ajisrawi/sentinel-uhf-radar/docs/images/backplane_layers.jpg

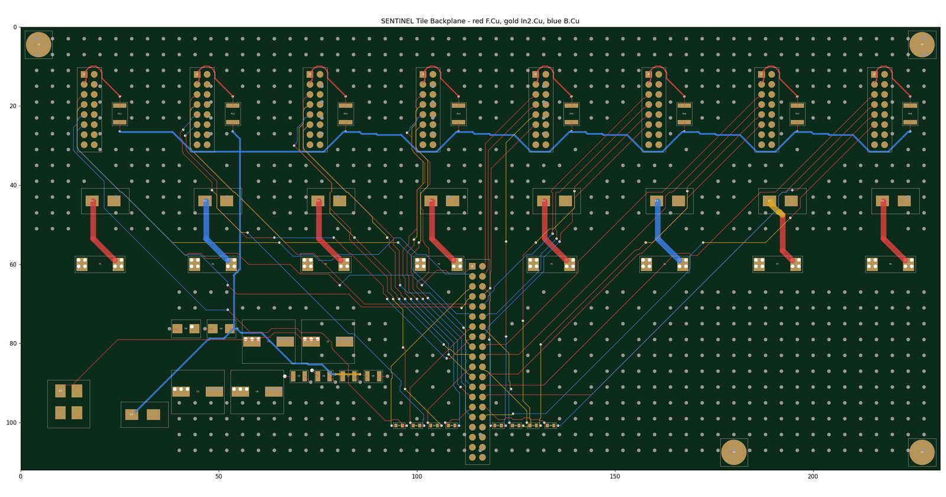
docs/images/backplane_layers.jpg
