ajisrawi/sentinel-uhf-radar/docs/images/cal_board_layers.jpg

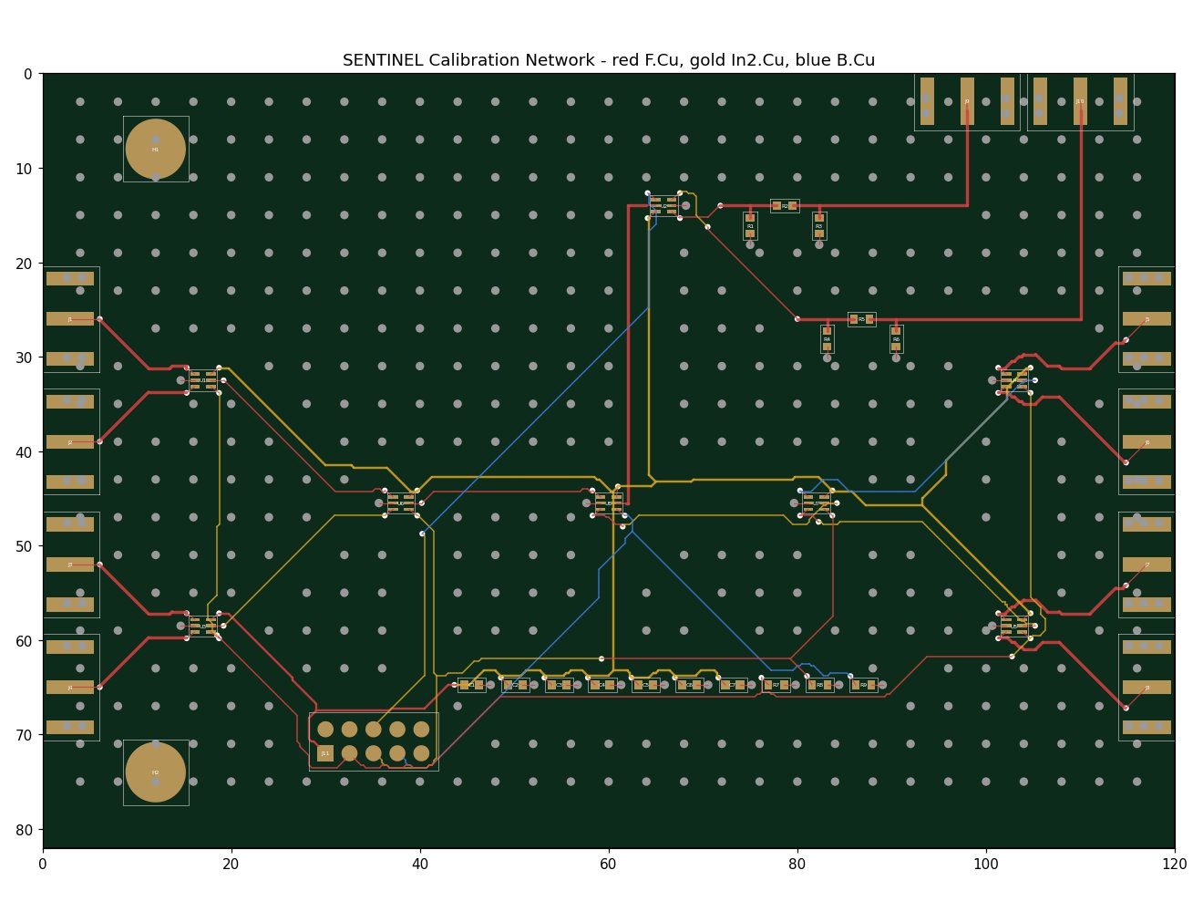
docs/images/cal_board_layers.jpg
