ajisrawi/sentinel-uhf-radar/docs/images/clock_board_layers.jpg

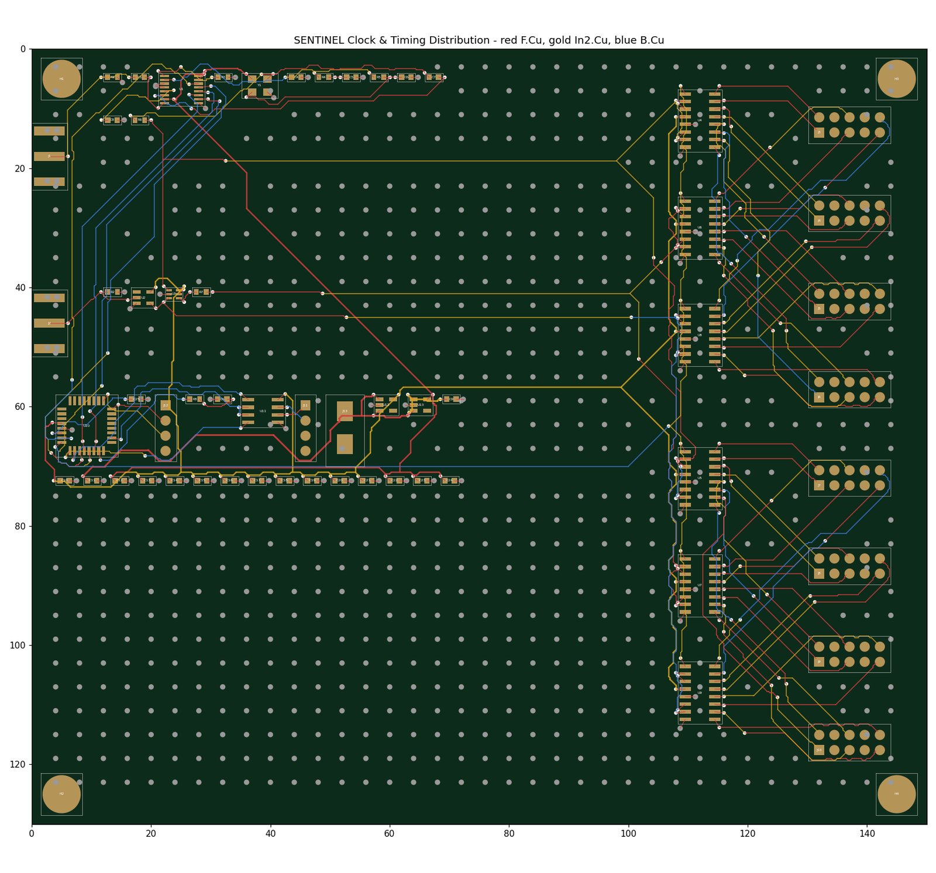
docs/images/clock_board_layers.jpg
