ajisrawi/sentinel-uhf-radar/docs/images/feed_board_layers.jpg

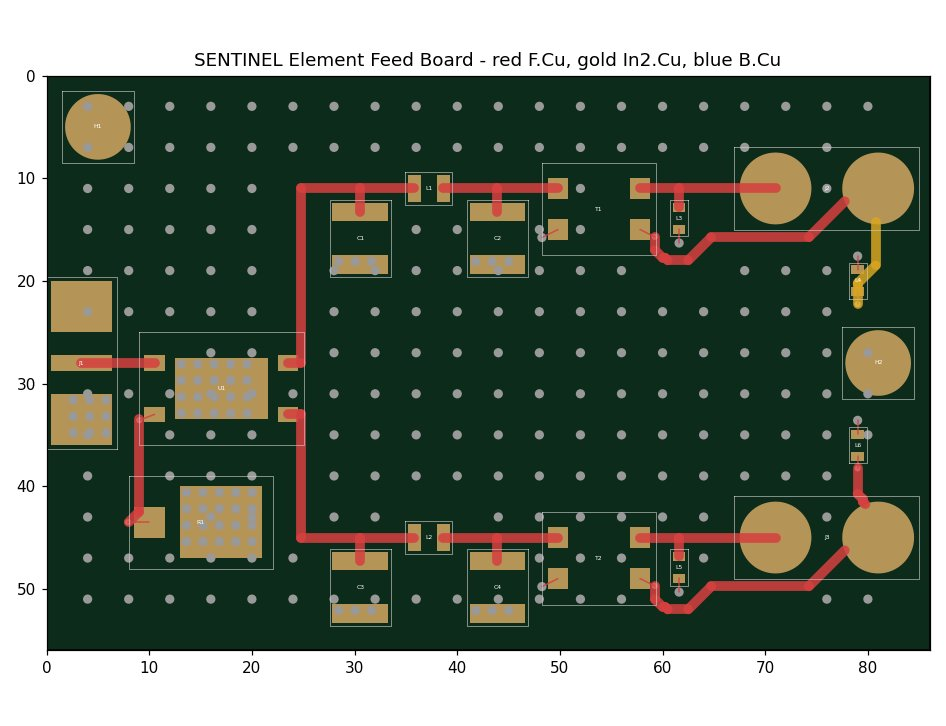
docs/images/feed_board_layers.jpg
