ajisrawi/sentinel-uhf-radar/docs/images/psu_layers.jpg

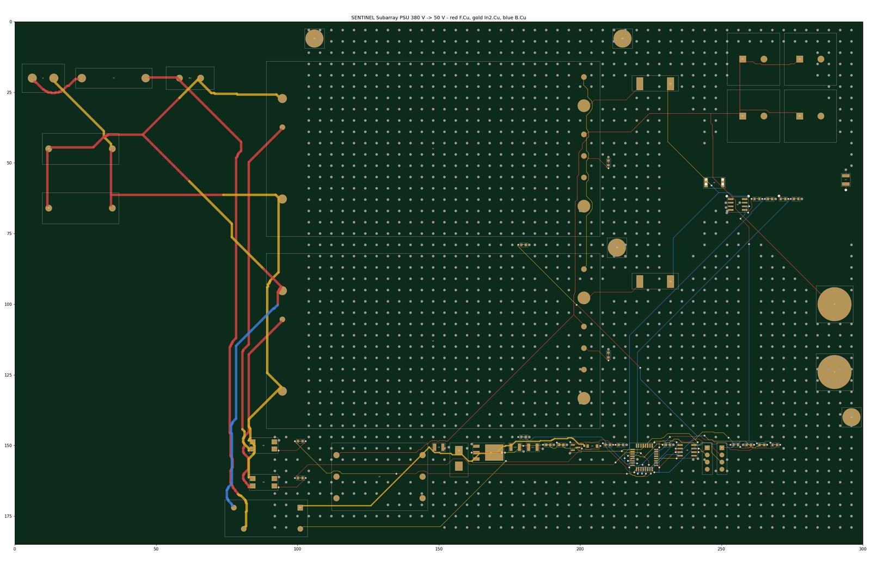
docs/images/psu_layers.jpg
