ajisrawi/sentinel-uhf-radar/docs/images/rfsoc_tile_layers.jpg

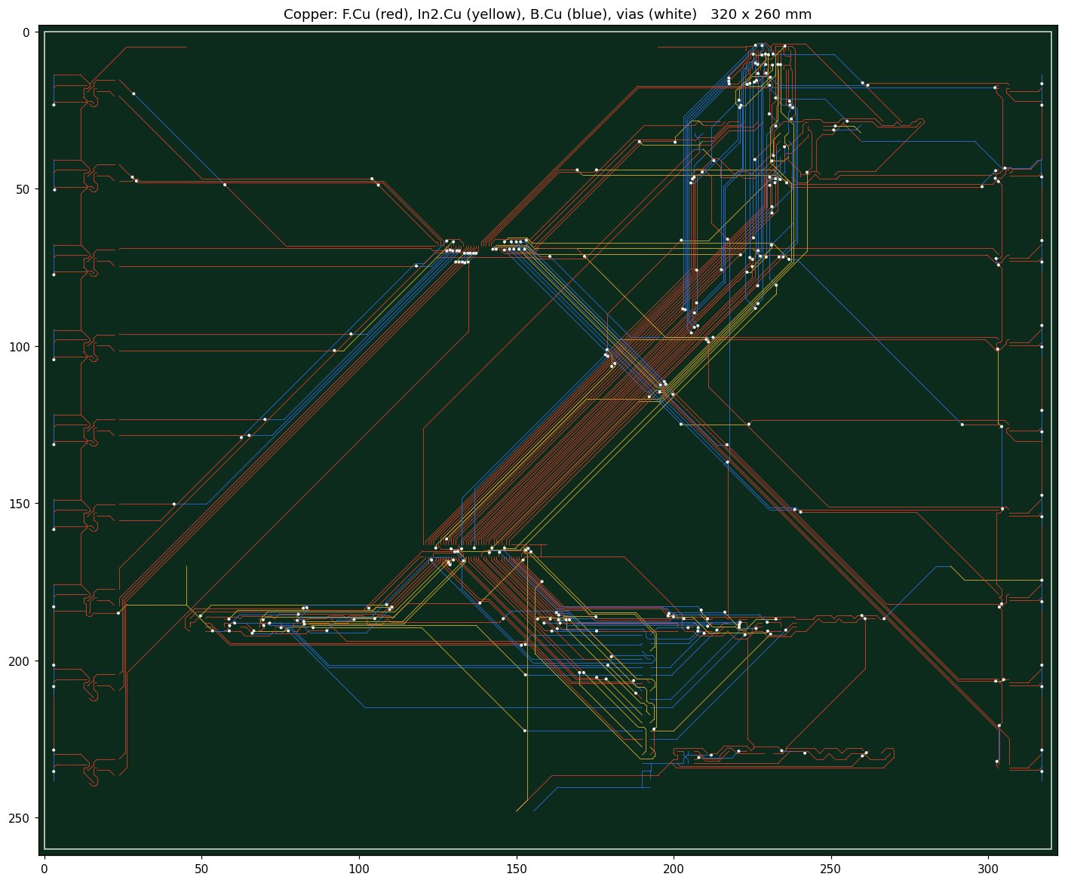
docs/images/rfsoc_tile_layers.jpg
