ajisrawi/sentinel-uhf-radar/report/img/sentinel_aerial.jpg

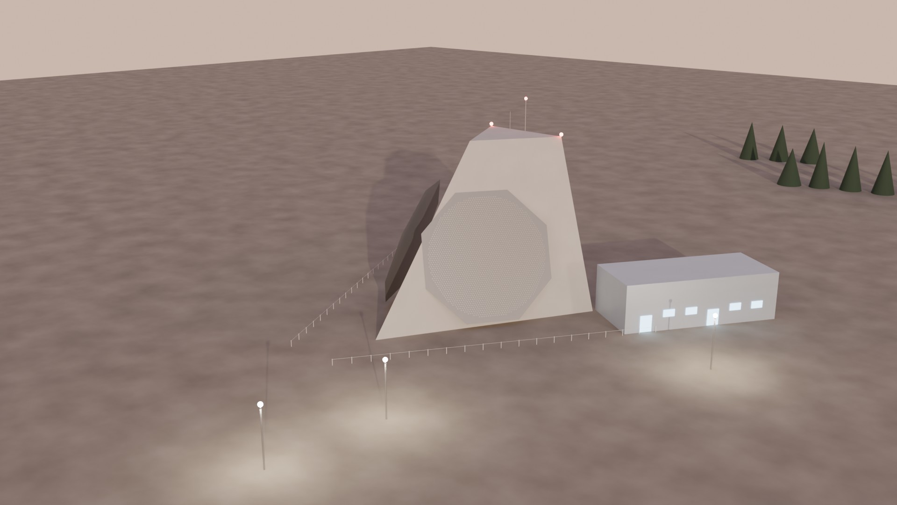
report/img/sentinel_aerial.jpg
