ajisrawi/sentinel-uhf-radar/hardware/backplane/export/SENTINEL_BACKPLANE_BOM.csv

Item | References | Qty | Value | Footprint | Description | MPN / part class
1 | C1-C4 | 4 | 330u 63V | Capacitor_SMD:CP_Elec_10x10.5 | Bus reservoir
2 | C5-C8 | 4 | 4.7u 100V | Capacitor_SMD:C_1210_3225Metric
3 | D1 | 1 | SMBJ58A | Diode_SMD:D_SMB
4 | D2 | 1 | SMBJ15A | Diode_SMD:D_SMB
5 | F1-F8 | 8 | 15A | SENTINEL:Fuse_456_SMD | 15 A fast fuse, per-slot drain protection
6 | F11-F18 | 8 | 0.5A | Fuse:Fuse_1812_4532Metric | Resettable fuse, module aux power
7 | H1-H4 | 4 | M4 | MountingHole:MountingHole_3.2mm_M3_Pad
8 | J1 | 1 | SLOT1 | Connector_PinHeader_2.54mm:PinHeader_2x08_P2.54mm_Vertical | T/R module 1 control header (mates module J5)
9 | J2 | 1 | SLOT2 | Connector_PinHeader_2.54mm:PinHeader_2x08_P2.54mm_Vertical | T/R module 2 control header (mates module J5)
10 | J3 | 1 | SLOT3 | Connector_PinHeader_2.54mm:PinHeader_2x08_P2.54mm_Vertical | T/R module 3 control header (mates module J5)
11 | J4 | 1 | SLOT4 | Connector_PinHeader_2.54mm:PinHeader_2x08_P2.54mm_Vertical | T/R module 4 control header (mates module J5)
12 | J5 | 1 | SLOT5 | Connector_PinHeader_2.54mm:PinHeader_2x08_P2.54mm_Vertical | T/R module 5 control header (mates module J5)
13 | J6 | 1 | SLOT6 | Connector_PinHeader_2.54mm:PinHeader_2x08_P2.54mm_Vertical | T/R module 6 control header (mates module J5)
14 | J7 | 1 | SLOT7 | Connector_PinHeader_2.54mm:PinHeader_2x08_P2.54mm_Vertical | T/R module 7 control header (mates module J5)
15 | J8 | 1 | SLOT8 | Connector_PinHeader_2.54mm:PinHeader_2x08_P2.54mm_Vertical | T/R module 8 control header (mates module J5)
16 | J9 | 1 | TO TILE | Connector_PinHeader_2.54mm:PinHeader_2x20_P2.54mm_Vertical | To RFSoC tile: 8 x (RS-485 A/B, TX_EN, FAULT_N)
17 | J10 | 1 | 50V IN | Connector_Molex:Molex_Mini-Fit_Jr_5566-04A_2x02_P4.20mm_Vertical | 50 V from subarray supply, 40 A pk
18 | J11 | 1 | DRAIN1 | Connector_Molex:Molex_Mini-Fit_Jr_5566-02A_2x01_P4.20mm_Vertical | Module 1 50 V drain feed
19 | J12 | 1 | DRAIN2 | Connector_Molex:Molex_Mini-Fit_Jr_5566-02A_2x01_P4.20mm_Vertical | Module 2 50 V drain feed
20 | J13 | 1 | DRAIN3 | Connector_Molex:Molex_Mini-Fit_Jr_5566-02A_2x01_P4.20mm_Vertical | Module 3 50 V drain feed
21 | J14 | 1 | DRAIN4 | Connector_Molex:Molex_Mini-Fit_Jr_5566-02A_2x01_P4.20mm_Vertical | Module 4 50 V drain feed
22 | J15 | 1 | DRAIN5 | Connector_Molex:Molex_Mini-Fit_Jr_5566-02A_2x01_P4.20mm_Vertical | Module 5 50 V drain feed
23 | J16 | 1 | DRAIN6 | Connector_Molex:Molex_Mini-Fit_Jr_5566-02A_2x01_P4.20mm_Vertical | Module 6 50 V drain feed
24 | J17 | 1 | DRAIN7 | Connector_Molex:Molex_Mini-Fit_Jr_5566-02A_2x01_P4.20mm_Vertical | Module 7 50 V drain feed
25 | J18 | 1 | DRAIN8 | Connector_Molex:Molex_Mini-Fit_Jr_5566-02A_2x01_P4.20mm_Vertical | Module 8 50 V drain feed
26 | J19 | 1 | 12V IN | Connector_Molex:Molex_Mini-Fit_Jr_5566-02A_2x01_P4.20mm_Vertical | 12 V aux from subarray supply
27 | R1-R8 | 8 | 33 | Resistor_SMD:R_0603_1608Metric | TX_EN source termination
