ajisrawi/sentinel-uhf-radar/hardware/cal_board/export/SENTINEL_CAL_BOM.csv

Item | References | Qty | Value | Footprint | Description | MPN / part class
1 | C1 | 1 | 1u | Capacitor_SMD:C_0603_1608Metric
2 | C2-C7 | 6 | 100n | Capacitor_SMD:C_0603_1608Metric
3 | H1,H2 | 2 | M3 | MountingHole:MountingHole_3.2mm_M3_Pad
4 | J1 | 1 | CAL1 | Connector_Coaxial:SMA_Amphenol_132289_EdgeMount | From T/R module 1 CAL port
5 | J2 | 1 | CAL2 | Connector_Coaxial:SMA_Amphenol_132289_EdgeMount | From T/R module 2 CAL port
6 | J3 | 1 | CAL3 | Connector_Coaxial:SMA_Amphenol_132289_EdgeMount | From T/R module 3 CAL port
7 | J4 | 1 | CAL4 | Connector_Coaxial:SMA_Amphenol_132289_EdgeMount | From T/R module 4 CAL port
8 | J5 | 1 | CAL5 | Connector_Coaxial:SMA_Amphenol_132289_EdgeMount | From T/R module 5 CAL port
9 | J6 | 1 | CAL6 | Connector_Coaxial:SMA_Amphenol_132289_EdgeMount | From T/R module 6 CAL port
10 | J7 | 1 | CAL7 | Connector_Coaxial:SMA_Amphenol_132289_EdgeMount | From T/R module 7 CAL port
11 | J8 | 1 | CAL8 | Connector_Coaxial:SMA_Amphenol_132289_EdgeMount | From T/R module 8 CAL port
12 | J9 | 1 | INJECT | Connector_Coaxial:SMA_Amphenol_132289_EdgeMount | From tile calibration DAC
13 | J10 | 1 | MEASURE | Connector_Coaxial:SMA_Amphenol_132289_EdgeMount | To tile calibration ADC
14 | J11 | 1 | CTRL | Connector_PinHeader_2.54mm:PinHeader_2x05_P2.54mm_Vertical | Control from RFSoC tile
15 | R1,R3,R4,R6 | 4 | 150 | Resistor_SMD:R_0603_1608Metric
16 | R2,R5 | 2 | 37.4 | Resistor_SMD:R_0603_1608Metric | 6 dB pad
17 | R7-R9 | 3 | 100k | Resistor_SMD:R_0603_1608Metric | Default channel 1
18 | U1-U8 | 8 | SPDT | Package_TO_SOT_SMD:SOT-363_SC-70-6 | Inject (RF1) / measure (RF2),Selector tree, SEL0 picks RF1/RF2,Selector tree, SEL1 picks RF1/RF2,Selector tree, SEL2 picks RF1/RF2
