ajisrawi/sentinel-uhf-radar/hardware/clock_board/export/SENTINEL_CLOCK_BOM.csv

Item | References | Qty | Value | Footprint | Description | MPN / part class
1 | C1,C13-C25 | 14 | 100n | Capacitor_SMD:C_0603_1608Metric
2 | C4 | 1 | 2.2n | Capacitor_SMD:C_0603_1608Metric | Loop filter (100 Hz loop)
3 | C5 | 1 | 22n | Capacitor_SMD:C_0603_1608Metric | Loop filter (100 Hz loop)
4 | C6 | 1 | 1n | Capacitor_SMD:C_0603_1608Metric | Loop filter (100 Hz loop)
5 | C7,C8 | 2 | 100p | Capacitor_SMD:C_0603_1608Metric
6 | C9-C12 | 4 | 1u | Capacitor_SMD:C_0603_1608Metric
7 | D1 | 1 | LOCK | LED_SMD:LED_0603_1608Metric
8 | H1-H4 | 4 | M3 | MountingHole:MountingHole_3.2mm_M3_Pad
9 | J1 | 1 | 10MHz IN | Connector_Coaxial:SMA_Amphenol_132289_EdgeMount | 10 MHz from site master, +7 dBm sine
10 | J2 | 1 | PPS IN | Connector_Coaxial:SMA_Amphenol_132289_EdgeMount | 1 PPS from site master
11 | J3 | 1 | TILE1 | Connector_PinHeader_2.54mm:PinHeader_2x05_P2.54mm_Vertical | Clock bundle to tile 1
12 | J4 | 1 | TILE2 | Connector_PinHeader_2.54mm:PinHeader_2x05_P2.54mm_Vertical | Clock bundle to tile 2
13 | J5 | 1 | TILE3 | Connector_PinHeader_2.54mm:PinHeader_2x05_P2.54mm_Vertical | Clock bundle to tile 3
14 | J6 | 1 | TILE4 | Connector_PinHeader_2.54mm:PinHeader_2x05_P2.54mm_Vertical | Clock bundle to tile 4
15 | J7 | 1 | TILE5 | Connector_PinHeader_2.54mm:PinHeader_2x05_P2.54mm_Vertical | Clock bundle to tile 5
16 | J8 | 1 | TILE6 | Connector_PinHeader_2.54mm:PinHeader_2x05_P2.54mm_Vertical | Clock bundle to tile 6
17 | J9 | 1 | TILE7 | Connector_PinHeader_2.54mm:PinHeader_2x05_P2.54mm_Vertical | Clock bundle to tile 7
18 | J10 | 1 | TILE8 | Connector_PinHeader_2.54mm:PinHeader_2x05_P2.54mm_Vertical | Clock bundle to tile 8
19 | J11 | 1 | RS485 | Connector_PinHeader_2.54mm:PinHeader_1x04_P2.54mm_Vertical | To site timing controller
20 | J12 | 1 | SWD | Connector_PinHeader_2.54mm:PinHeader_1x04_P2.54mm_Vertical
21 | J13 | 1 | 5V IN | Connector_Molex:Molex_Mini-Fit_Jr_5566-02A_2x01_P4.20mm_Vertical
22 | R1,R2 | 2 | 51 | Resistor_SMD:R_0603_1608Metric | 50 ohm termination
23 | R3 | 1 | 5.1k | Resistor_SMD:R_0603_1608Metric
24 | R4 | 1 | 3.3k | Resistor_SMD:R_0603_1608Metric | Loop filter (100 Hz loop)
25 | R5 | 1 | 6.8k | Resistor_SMD:R_0603_1608Metric | Loop filter (100 Hz loop)
26 | R6,R7 | 2 | 33 | Resistor_SMD:R_0603_1608Metric | Source termination
27 | R8 | 1 | 1k | Resistor_SMD:R_0603_1608Metric
28 | U1 | 1 | PLL | Package_SO:TSSOP-16_4.4x5mm_P0.65mm | Integer-N PLL, verify pin map
29 | U2 | 1 | 74LVC1G17 | Package_TO_SOT_SMD:SOT-23-5 | PPS Schmitt buffer
30 | U3 | 1 | 74LVC1G175 | Package_TO_SOT_SMD:SOT-363_SC-70-6 | SYSREF: PPS re-timed by CLK
31 | U4-U9 | 6 | SN65LVDS047 | Package_SO:SOIC-16_3.9x9.9mm_P1.27mm | Quad LVDS driver, CLK to tiles 1-4,Quad LVDS driver, CLK to tiles 5-8,Quad LVDS driver, PPS to tiles 1-4,Quad LVDS driver, PPS to tiles 5-8,Quad LVDS driver, SYSREF to tiles 1-4,Quad LVDS driver, SYSREF to tiles 5-8
32 | U10 | 1 | STM32G031K8T6 | Package_QFP:LQFP-32_7x7mm_P0.8mm | Programs the PLL, reports lock, enables outputs
33 | U11 | 1 | THVD1450 | Package_SO:SOIC-8_3.9x4.9mm_P1.27mm
34 | U12,U13 | 2 | AP2112K-3.3 | Package_TO_SOT_SMD:SOT-23-5 | Analog rail for PLL/VCXO
35 | Y1 | 1 | 122.88MHz | Oscillator:Oscillator_SMD_EuroQuartz_XO53-4Pin_5.0x3.2mm | 122.88 MHz VCXO, low phase noise
