ajisrawi/sentinel-uhf-radar/hardware/feed_board/export/SENTINEL_FEED_BOM.csv

Item | References | Qty | Value | Footprint | Description | MPN / part class
1 | C1 | 1 | DNP | Capacitor_SMD:C_2220_5750Metric | X match shunt, 500 V
2 | C2,C4 | 2 | tune | Capacitor_SMD:C_2220_5750Metric | Bench trim, fit if needed | DNP
3 | C3 | 1 | 3.9p | Capacitor_SMD:C_2220_5750Metric | Y match shunt, 500 V
4 | H1,H2 | 2 | M3 | MountingHole:MountingHole_3.2mm_M3_Pad
5 | J1 | 1 | FROM T/R | SENTINEL:N_EdgeLaunch | N-type from T/R module ANT port, 300 W pk
6 | J2 | 1 | DIPOLE X | SENTINEL:DipoleArm_M4_Pair | X dipole arms, M4 lugs
7 | J3 | 1 | DIPOLE Y | SENTINEL:DipoleArm_M4_Pair | Y dipole arms, M4 lugs
8 | L1 | 1 | 11.2n | Inductor_SMD:L_1210_3225Metric | X match series
9 | L2 | 1 | 20.7n | Inductor_SMD:L_1210_3225Metric | Y match series
10 | L3-L6 | 4 | 1u | Inductor_SMD:L_0805_2012Metric | Static bleed
11 | R1 | 1 | 50 100W | SENTINEL:Termination_100W_SMD | Isolated-port load, 100 W
12 | T1,T2 | 2 | 1:1 | SENTINEL:Balun_SMD_10x8 | 1:1 balun, 200 W pk
13 | U1 | 1 | HYB 3dB | SENTINEL:Hybrid90_SMD_15x10 | 3 dB 90 deg hybrid, 420-450 MHz, 500 W
