ajisrawi/sentinel-uhf-radar/hardware/psu/export/SENTINEL_PSU_BOM.csv

Item | References | Qty | Value | Footprint | Description | MPN / part class
1 | C1,C2 | 2 | 10u 450V | Capacitor_THT:C_Rect_L26.5mm_W10.5mm_P22.50mm_MKS4 | Input film capacitor
2 | C3-C6 | 4 | 1000u 63V | Capacitor_THT:CP_Radial_D18.0mm_P7.50mm | Output bulk
3 | C7 | 1 | 10u 100V | Capacitor_SMD:C_1210_3225Metric
4 | C8 | 1 | 10n | Capacitor_SMD:C_0603_1608Metric
5 | C9 | 1 | 22u 25V | Capacitor_SMD:C_1210_3225Metric
6 | C10,C11 | 2 | 10u | Capacitor_SMD:C_1210_3225Metric
7 | C12-C14 | 3 | 100n | Capacitor_SMD:C_0603_1608Metric
8 | D1,D2 | 2 | 100V 60A | Package_TO_SOT_THT:TO-247-2_Vertical | Output OR-ing diode
9 | D3 | 1 | 1N4148W | Diode_SMD:D_SOD-123 | Relay flyback
10 | D4 | 1 | GRN | LED_SMD:LED_0603_1608Metric
11 | F1 | 1 | 6.3A 500V | SENTINEL:Fuse_Clips_5x20 | Input fuse, 500 VDC rated
12 | H1-H4 | 4 | M4 | MountingHole:MountingHole_3.2mm_M3_Pad
13 | J1 | 1 | 380VDC IN | SENTINEL:Terminal_HV_2P_7.62 | 380 VDC site distribution bus
14 | J2 | 1 | +50V STUD | SENTINEL:Stud_M6 | M6 stud: capacitor bank + and backplane 50 V
15 | J3 | 1 | 0V STUD | SENTINEL:Stud_M6 | M6 stud: return
16 | J4 | 1 | 12V OUT | Connector_Molex:Molex_Mini-Fit_Jr_5566-02A_2x01_P4.20mm_Vertical | 12 V aux to backplane
17 | J5 | 1 | RS485 | Connector_PinHeader_2.54mm:PinHeader_1x04_P2.54mm_Vertical | Telemetry to tile controller
18 | J6 | 1 | SWD | Connector_PinHeader_2.54mm:PinHeader_1x04_P2.54mm_Vertical
19 | K1 | 1 | G2RL-1A 12V | Relay_THT:Relay_SPST_Omron_G2RL-1A | Inrush bypass relay, 5 kV coil-contact
20 | Q1 | 1 | 2N7002 | Package_TO_SOT_SMD:SOT-23
21 | R1,R2 | 2 | 470 | Resistor_SMD:R_0603_1608Metric
22 | R3,R4 | 2 | trim | Resistor_SMD:R_0603_1608Metric | Trim-up to 50.0 V per vendor formula | value per brick datasheet
23 | R5,R6,R10 | 3 | 10k | Resistor_SMD:R_0603_1608Metric
24 | R7 | 1 | 1m | Resistor_SMD:R_2512_6332Metric | Brick current shunt
25 | R8,R13 | 2 | 1k | Resistor_SMD:R_0603_1608Metric
26 | R9 | 1 | 200k | Resistor_SMD:R_0603_1608Metric
27 | R11 | 1 | 100 | Resistor_SMD:R_0603_1608Metric
28 | R12 | 1 | 100k | Resistor_SMD:R_0603_1608Metric
29 | RT1 | 1 | 10R NTC | SENTINEL:NTC_Disc_D15_P7.5 | Inrush limiter, bypassed by K1 after precharge
30 | TH1,TH2 | 2 | 10k NTC | Resistor_SMD:R_0603_1608Metric | Brick 1 baseplate temperature,Brick 2 baseplate temperature
31 | U1,U2 | 2 | 380V->50V 600W | SENTINEL:Brick_Full_THT | Isolated full brick, 380 V in, 50 V / 12 A out, current share
32 | U3,U4 | 2 | PC817 | Package_DIP:SMDIP-4_W7.62mm | Brick enable across the isolation barrier
33 | U5 | 1 | 48V->12V 50W | SENTINEL:Brick_16_THT | 12 V aux for modules and relay
34 | U6 | 1 | LM1117-3.3 | Package_TO_SOT_SMD:TO-252-3_TabPin2
35 | U7 | 1 | STM32G031K8T6 | Package_QFP:LQFP-32_7x7mm_P0.8mm | Supervisor: soft start, OV/UV, current, temperature, telemetry
36 | U8 | 1 | THVD1450 | Package_SO:SOIC-8_3.9x4.9mm_P1.27mm
37 | U9 | 1 | INA240A1 | Package_SO:SOIC-8_3.9x4.9mm_P1.27mm
