ajisrawi/sentinel-uhf-radar/hardware/rfsoc_tile/export/SENTINEL_TILE_BOM.csv

Item | References | Qty | Value | Footprint | Description | MPN / part class
1 | C1-C9,C11,C12,C21,C100-C108,C120-C128,C140-C148,C161 | 40 | 100n | Capacitor_SMD:C_0603_1608Metric | Centre-tap AC ground
2 | C10,C160 | 2 | 10u | Capacitor_SMD:C_1210_3225Metric | QSFP supply filter
3 | C20 | 1 | 10u 25V | Capacitor_SMD:C_1210_3225Metric
4 | C22 | 1 | 1u | Capacitor_SMD:C_0603_1608Metric
5 | C23,C24 | 2 | 22u | Capacitor_SMD:C_1210_3225Metric
6 | C25 | 1 | 22u 25V | Capacitor_SMD:C_1210_3225Metric
7 | H1-H4 | 4 | M3 | MountingHole:MountingHole_3.2mm_M3_Pad
8 | J1 | 1 | SOM CONN A | SENTINEL:SOM_B2B_2x40_P0.8 | SOM data-converter connector
9 | J2 | 1 | SOM CONN B | SENTINEL:SOM_B2B_2x50_P0.8 | SOM control / optics / power connector
10 | J3 | 1 | BACKPLANE | Connector_PinHeader_2.54mm:PinHeader_2x20_P2.54mm_Vertical | Cable to tile backplane J9 (pin-for-pin)
11 | J4 | 1 | CLOCK | Connector_PinHeader_2.54mm:PinHeader_2x05_P2.54mm_Vertical | From clock board
12 | J5 | 1 | CAL CTRL | Connector_PinHeader_2.54mm:PinHeader_2x05_P2.54mm_Vertical | To calibration board J11
13 | J6 | 1 | PSU LINK | Connector_PinHeader_2.54mm:PinHeader_1x04_P2.54mm_Vertical
14 | J7 | 1 | QSFP28 | SENTINEL:QSFP28_Host_38P | QSFP28 to face beamformer, 4 x 25 Gb/s
15 | J8 | 1 | 12V IN | Connector_Molex:Molex_Mini-Fit_Jr_5566-02A_2x01_P4.20mm_Vertical | 12 V from subarray PSU aux, 4 A
16 | J10 | 1 | RX1 | Connector_Coaxial:SMA_Amphenol_132289_EdgeMount | From T/R module 1 RX_OUT
17 | J11 | 1 | RX2 | Connector_Coaxial:SMA_Amphenol_132289_EdgeMount | From T/R module 2 RX_OUT
18 | J12 | 1 | RX3 | Connector_Coaxial:SMA_Amphenol_132289_EdgeMount | From T/R module 3 RX_OUT
19 | J13 | 1 | RX4 | Connector_Coaxial:SMA_Amphenol_132289_EdgeMount | From T/R module 4 RX_OUT
20 | J14 | 1 | RX5 | Connector_Coaxial:SMA_Amphenol_132289_EdgeMount | From T/R module 5 RX_OUT
21 | J15 | 1 | RX6 | Connector_Coaxial:SMA_Amphenol_132289_EdgeMount | From T/R module 6 RX_OUT
22 | J16 | 1 | RX7 | Connector_Coaxial:SMA_Amphenol_132289_EdgeMount | From T/R module 7 RX_OUT
23 | J17 | 1 | RX8 | Connector_Coaxial:SMA_Amphenol_132289_EdgeMount | From T/R module 8 RX_OUT
24 | J18 | 1 | RXCAL | Connector_Coaxial:SMA_Amphenol_132289_EdgeMount | From calibration board MEASURE
25 | J20 | 1 | TX1 | Connector_Coaxial:SMA_Amphenol_132289_EdgeMount | To T/R module 1 TX_IN
26 | J21 | 1 | TX2 | Connector_Coaxial:SMA_Amphenol_132289_EdgeMount | To T/R module 2 TX_IN
27 | J22 | 1 | TX3 | Connector_Coaxial:SMA_Amphenol_132289_EdgeMount | To T/R module 3 TX_IN
28 | J23 | 1 | TX4 | Connector_Coaxial:SMA_Amphenol_132289_EdgeMount | To T/R module 4 TX_IN
29 | J24 | 1 | TX5 | Connector_Coaxial:SMA_Amphenol_132289_EdgeMount | To T/R module 5 TX_IN
30 | J25 | 1 | TX6 | Connector_Coaxial:SMA_Amphenol_132289_EdgeMount | To T/R module 6 TX_IN
31 | J26 | 1 | TX7 | Connector_Coaxial:SMA_Amphenol_132289_EdgeMount | To T/R module 7 TX_IN
32 | J27 | 1 | TX8 | Connector_Coaxial:SMA_Amphenol_132289_EdgeMount | To T/R module 8 TX_IN
33 | J28 | 1 | TXCAL | Connector_Coaxial:SMA_Amphenol_132289_EdgeMount | To calibration board INJECT
34 | L1 | 1 | 4.7u | Inductor_SMD:L_1210_3225Metric
35 | R10-R12,R24 | 4 | 100 | Resistor_SMD:R_0603_1608Metric | LVDS receiver termination,LVDS termination (DNP if SOM terminates),MGT reference clock termination (refclk from SOM oscillator)
36 | R20-R23 | 4 | 4.7k | Resistor_SMD:R_0603_1608Metric
37 | R25,R27 | 2 | 100k | Resistor_SMD:R_0603_1608Metric
38 | R26 | 1 | 43.2k | Resistor_SMD:R_0603_1608Metric
39 | R160 | 1 | 0 | Resistor_SMD:R_0805_2012Metric | DAC_AVTT from 3.3 V (fit per SOM DAC mode: 2.5 V or 3.0 V)
40 | T1-T9,T11-T19 | 18 | 1:2 | SENTINEL:Balun_SMD_6P_3.8x3.8 | ADC input transformer, 50 -> 100 ohm,DAC output transformer, centre tap biases the DAC
41 | U1-U9 | 9 | THVD1450 | Package_SO:SOIC-8_3.9x4.9mm_P1.27mm | RS-485 to T/R module 1,RS-485 to T/R module 2,RS-485 to T/R module 3,RS-485 to T/R module 4,RS-485 to T/R module 5,RS-485 to T/R module 6,RS-485 to T/R module 7,RS-485 to T/R module 8,RS-485 to subarray PSU
42 | U10 | 1 | LMR33630 | Package_SO:Texas_HSOP-8-1EP_3.9x4.9mm_P1.27mm_ThermalVias | 12 V -> 3.3 V, 3 A
