ajisrawi/sentinel-uhf-radar/hardware/tr_module/export/SENTINEL_TRM_BOM.csv

Item | References | Qty | Value | Footprint | Description | MPN / part class
1 | C1,C3,C23-C29 | 9 | 100p | Capacitor_SMD:C_0603_1608Metric | DC block, C0G
2 | C5 | 1 | 33p | Capacitor_SMD:C_0603_1608Metric | Driver input DC block
3 | C6 | 1 | 8.2p | Capacitor_SMD:C_0603_1608Metric | Driver input match
4 | C8 | 1 | 1.5p | Capacitor_SMD:C_0805_2012Metric | Driver output match
5 | C9 | 1 | 47p | Capacitor_SMD:C_0805_2012Metric | Interstage DC block
6 | C10 | 1 | 10p | Capacitor_SMD:C_0805_2012Metric | Interstage match
7 | C11 | 1 | 22p | Capacitor_SMD:C_1206_3216Metric | PA input match
8 | C13 | 1 | 1n 100V | Capacitor_SMD:C_1210_3225Metric
9 | C14 | 1 | 10u 100V | Capacitor_SMD:C_2220_5750Metric
10 | C15,C16 | 2 | 330u 63V | Capacitor_SMD:CP_Elec_10x10.5 | Polymer, pulse reservoir
11 | C17 | 1 | 100p | Capacitor_SMD:C_2220_5750Metric | Output DC block, 500 V, high-Q
12 | C18 | 1 | 6.8p | Capacitor_SMD:C_2220_5750Metric | Output match, 500 V
13 | C19 | 1 | 3.3p | Capacitor_SMD:C_2220_5750Metric | Output match, 500 V
14 | C20,C21,C30,C31,C35,C36,C40,C41,C44,C47,C49,C50 | 12 | 100n | Capacitor_SMD:C_0603_1608Metric
15 | C22,C32,C33,C45,C46 | 5 | 1u | Capacitor_SMD:C_0603_1608Metric
16 | C34 | 1 | 4.7u | Capacitor_SMD:C_0805_2012Metric
17 | C37 | 1 | 10n | Capacitor_SMD:C_0603_1608Metric
18 | C38 | 1 | 100u 100V | Capacitor_SMD:CP_Elec_10x10.5 | Bus bulk
19 | C39 | 1 | 1u 100V | Capacitor_SMD:C_1210_3225Metric
20 | C42 | 1 | 22u | Capacitor_SMD:C_1210_3225Metric
21 | C43 | 1 | 10u 50V | Capacitor_SMD:C_1210_3225Metric
22 | C48 | 1 | 4.7u | Capacitor_SMD:C_0603_1608Metric
23 | D1 | 1 | PIN | Diode_SMD:D_SMB | Coarse PIN limiter diode, 100 W pk
24 | D2 | 1 | Schottky | Diode_SMD:D_SOD-323 | Fine limiter
25 | D3 | 1 | 12V | Diode_SMD:D_SOD-323 | P-FET Vgs clamp
26 | D4 | 1 | SMBJ58A | Diode_SMD:D_SMB | Bus transient clamp
27 | D5 | 1 | SS16 | Diode_SMD:D_SMA
28 | D6 | 1 | GRN | LED_SMD:LED_0603_1608Metric | Status LED
29 | H1-H4 | 4 | M3 | MountingHole:MountingHole_3.2mm_M3_Pad | Cold-plate bond, M3
30 | J1 | 1 | TX_IN | Connector_Coaxial:SMA_Amphenol_132289_EdgeMount | SMA edge launch, RF drive from RFSoC DAC (0 dBm)
31 | J2 | 1 | RX_OUT | Connector_Coaxial:SMA_Amphenol_132289_EdgeMount | SMA edge launch to RFSoC ADC
32 | J3 | 1 | ANT | SENTINEL:N_EdgeLaunch | N-type edge launch to crossed-dipole hybrid
33 | J4 | 1 | CAL | Connector_Coaxial:SMA_Amphenol_132289_EdgeMount | SMA to array calibration network (mutual-coupling cal)
34 | J5 | 1 | BACKPLANE | Connector_PinHeader_2.54mm:PinHeader_2x08_P2.54mm_Vertical | Tile backplane: aux power, RS-485, TX_EN gate, fault; even pins ground
35 | J6 | 1 | 50V IN | Connector_Molex:Molex_Mini-Fit_Jr_5566-02A_2x01_P4.20mm_Vertical | Mini-Fit Jr, 50 V drain bus from subarray supply
36 | J7 | 1 | SWD | Connector_PinHeader_2.54mm:PinHeader_1x04_P2.54mm_Vertical
37 | L1,L9,L10 | 3 | 390n | Inductor_SMD:L_0603_1608Metric | RF choke
38 | L2 | 1 | 220n | Inductor_SMD:L_0805_2012Metric | Gate feed
39 | L3 | 1 | 120n | Inductor_SMD:L_1210_3225Metric | Driver drain feed
40 | L4 | 1 | 18n | Inductor_SMD:L_0805_2012Metric | Interstage match
41 | L5 | 1 | 56n | Inductor_SMD:L_1210_3225Metric | PA gate feed
42 | L6 | 1 | 47n | Inductor_SMD:L_1812_4532Metric | PA drain feed, 10 A peak
43 | L7 | 1 | 8n | Inductor_SMD:L_1812_4532Metric | Output match, air core
44 | L8 | 1 | 100n | Inductor_SMD:L_0603_1608Metric | Limiter DC return
45 | L11 | 1 | 22u | Inductor_SMD:L_1210_3225Metric
46 | Q1 | 1 | GaN 10W | SENTINEL:GaN_Flange_440166 | Driver GaN HEMT 10 W, 50 V, 440166 flange | CG2H40010F class
47 | Q2 | 1 | GaN 300W | SENTINEL:GaN_Flange_780 | Final GaN HEMT 300 W pulsed, 50 V, NI-780 flange | UHF radar GaN, 300 W class
48 | Q3 | 1 | 2N7002 | Package_TO_SOT_SMD:SOT-23 | Level shifter
49 | Q4 | 1 | SUD50P10 | Package_TO_SOT_SMD:TO-252-2 | High-side drain switch, 100 V P-FET
50 | R1,R10 | 2 | 33 | Resistor_SMD:R_0603_1608Metric
51 | R3,R5 | 2 | 292 | Resistor_SMD:R_0603_1608Metric | 3 dB pi pad
52 | R4 | 1 | 17.6 | Resistor_SMD:R_0603_1608Metric | 3 dB pi pad
53 | R6 | 1 | 22 | Resistor_SMD:R_0603_1608Metric
54 | R7 | 1 | 4.7 | Resistor_SMD:R_0603_1608Metric | Gate stability resistor
55 | R8 | 1 | 10 | Resistor_SMD:R_0805_2012Metric
56 | R9 | 1 | 47 | Resistor_SMD:R_0603_1608Metric
57 | R12,R14,R15,R17 | 4 | 96 | Resistor_SMD:R_0603_1608Metric
58 | R13,R16 | 2 | 71 | Resistor_SMD:R_0603_1608Metric | 10 dB pi pad
59 | R18,R21,R26,R33,R40,R41,R44,R46 | 8 | 10k | Resistor_SMD:R_0603_1608Metric | TX_EN defaults low
60 | R19,R22 | 2 | 12.4k | Resistor_SMD:R_0603_1608Metric
61 | R20,R23 | 2 | 10 | Resistor_SMD:R_0603_1608Metric
62 | R24,R25,R27,R28,R31,R32,R48 | 7 | 100k | Resistor_SMD:R_0603_1608Metric | Fail-safe pinch-off
63 | R29 | 1 | 82k | Resistor_SMD:R_0603_1608Metric
64 | R30 | 1 | 20k | Resistor_SMD:R_0603_1608Metric
65 | R34 | 1 | 100 | Resistor_SMD:R_0603_1608Metric
66 | R35 | 1 | 10k | Resistor_SMD:R_1206_3216Metric
67 | R36 | 1 | 4.7k | Resistor_SMD:R_0805_2012Metric
68 | R37 | 1 | 5m | Resistor_SMD:R_2512_6332Metric | Drain current shunt, Kelvin
69 | R38,R45 | 2 | 1k | Resistor_SMD:R_0603_1608Metric
70 | R39 | 1 | 180k | Resistor_SMD:R_0603_1608Metric
71 | R43 | 1 | 56.2k | Resistor_SMD:R_0603_1608Metric
72 | TH1 | 1 | 10k NTC | Resistor_SMD:R_0603_1608Metric | On PA flange
73 | U1 | 1 | GB 20dB | Package_TO_SOT_SMD:SOT-89-3 | Driver gain block, G 20 dB, P1dB +21 dBm | PHA-13LN+ class
74 | U3 | 1 | CIRC 400W | SENTINEL:Circulator_DropIn_32mm | Drop-in circulator 420-450 MHz, 400 W pk, 20 dB isolation
75 | U4 | 1 | -30dB | SENTINEL:DirCoupler_SMD_12x6 | Directional coupler 30 dB, 500 W
76 | U5 | 1 | SPDT | Package_TO_SOT_SMD:SOT-363_SC-70-6 | RF switch: detector or calibration port
77 | U6 | 1 | DET FWD | Package_TO_SOT_SMD:SOT-23-6 | Forward power detector
78 | U7 | 1 | DET REV | Package_TO_SOT_SMD:SOT-23-6 | Reflected power detector (VSWR trip)
79 | U8 | 1 | LNA | Package_TO_SOT_SMD:SOT-89-3 | LNA NF 0.5 dB, G 18 dB at 435 MHz
80 | U9 | 1 | BPF 420-450 | SENTINEL:BPF_SMD_5x5 | SAW BPF 435 MHz, 30 MHz BW, IL 2 dB
81 | U10 | 1 | GB 20dB | Package_TO_SOT_SMD:SOT-89-3 | Receive gain block, G 20 dB
82 | U11 | 1 | LM2776 | Package_TO_SOT_SMD:SOT-23-6 | -5 V for GaN gate bias
83 | U12,U13 | 2 | DAC7311 | Package_TO_SOT_SMD:SOT-363_SC-70-6 | 12-bit DAC, DRV gate setpoint,12-bit DAC, PA gate setpoint
84 | U14,U15 | 2 | LM321 | Package_TO_SOT_SMD:SOT-23-5 | Inverting gate driver, +5/-5 V
85 | U16 | 1 | LMV331 | Package_TO_SOT_SMD:SOT-23-5 | BIAS_OK high only when VG_PA < -2.0 V
86 | U17 | 1 | 74LVC1G11 | Package_TO_SOT_SMD:SOT-363_SC-70-6 | Drain on = TX_EN AND BIAS_OK AND MCU enable
87 | U18 | 1 | INA240A1 | Package_SO:SOIC-8_3.9x4.9mm_P1.27mm | Drain current sense, 20 V/V
88 | U19 | 1 | LMR16006 | Package_TO_SOT_SMD:SOT-23-6 | 12 V to 5 V buck, 0.6 A
89 | U20 | 1 | AP2112K-3.3 | Package_TO_SOT_SMD:SOT-23-5
90 | U21 | 1 | STM32G031K8T6 | Package_QFP:LQFP-32_7x7mm_P0.8mm | Module controller: bias, protection, telemetry
91 | U22 | 1 | THVD1450 | Package_SO:SOIC-8_3.9x4.9mm_P1.27mm | RS-485 to tile controller
