ajisrawi/sentinel-uhf-radar/(list of files, cad)

Other CAD files:
render/sentinel_site.blend
