ajisrawi/sentinel-uhf-radar/hardware/rfsoc_tile/export/SENTINEL_TILE_schematic.pdf

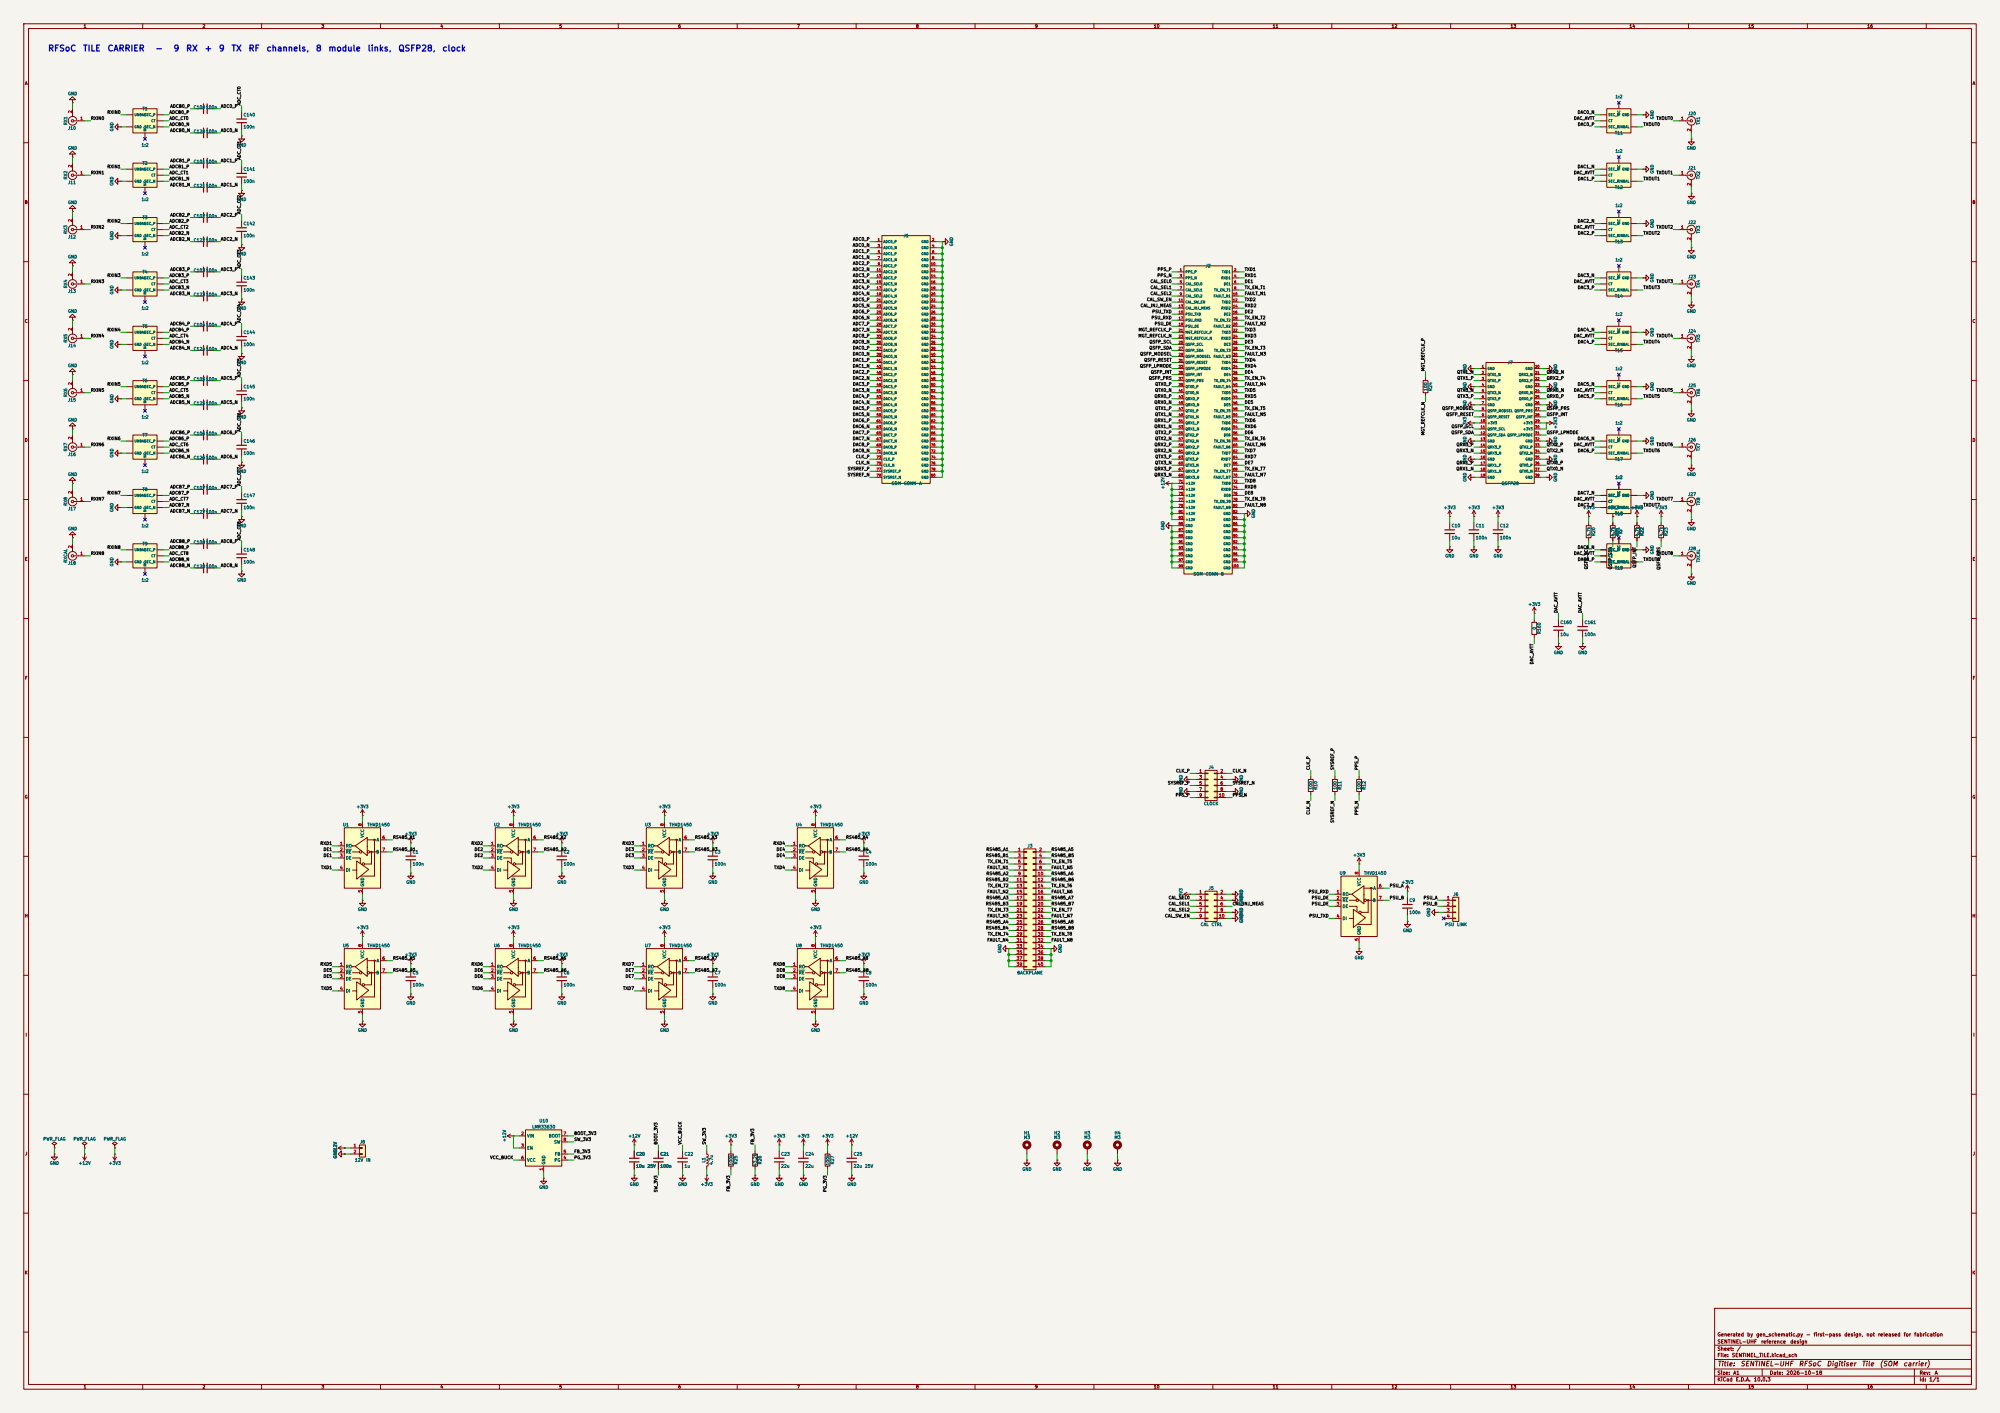
[picture p35: page 1]

37 | 38
39 | 40

Generated by gen_schematic.py - first-pass design, not released for fabrication
SENTINEL-UHF reference design
Sheet: /
File: SENTINEL_TILE.kicad_sch
Title: SENTINEL-UHF RFSoC Digitiser Tile (SOM carrier)

Size: A1 | Rev: A
KiCad E.D.A. 10.0.3 | Id: 1/1
