ajisrawi/sentinel-uhf-radar/hardware/backplane/export/SENTINEL_BACKPLANE_schematic.pdf

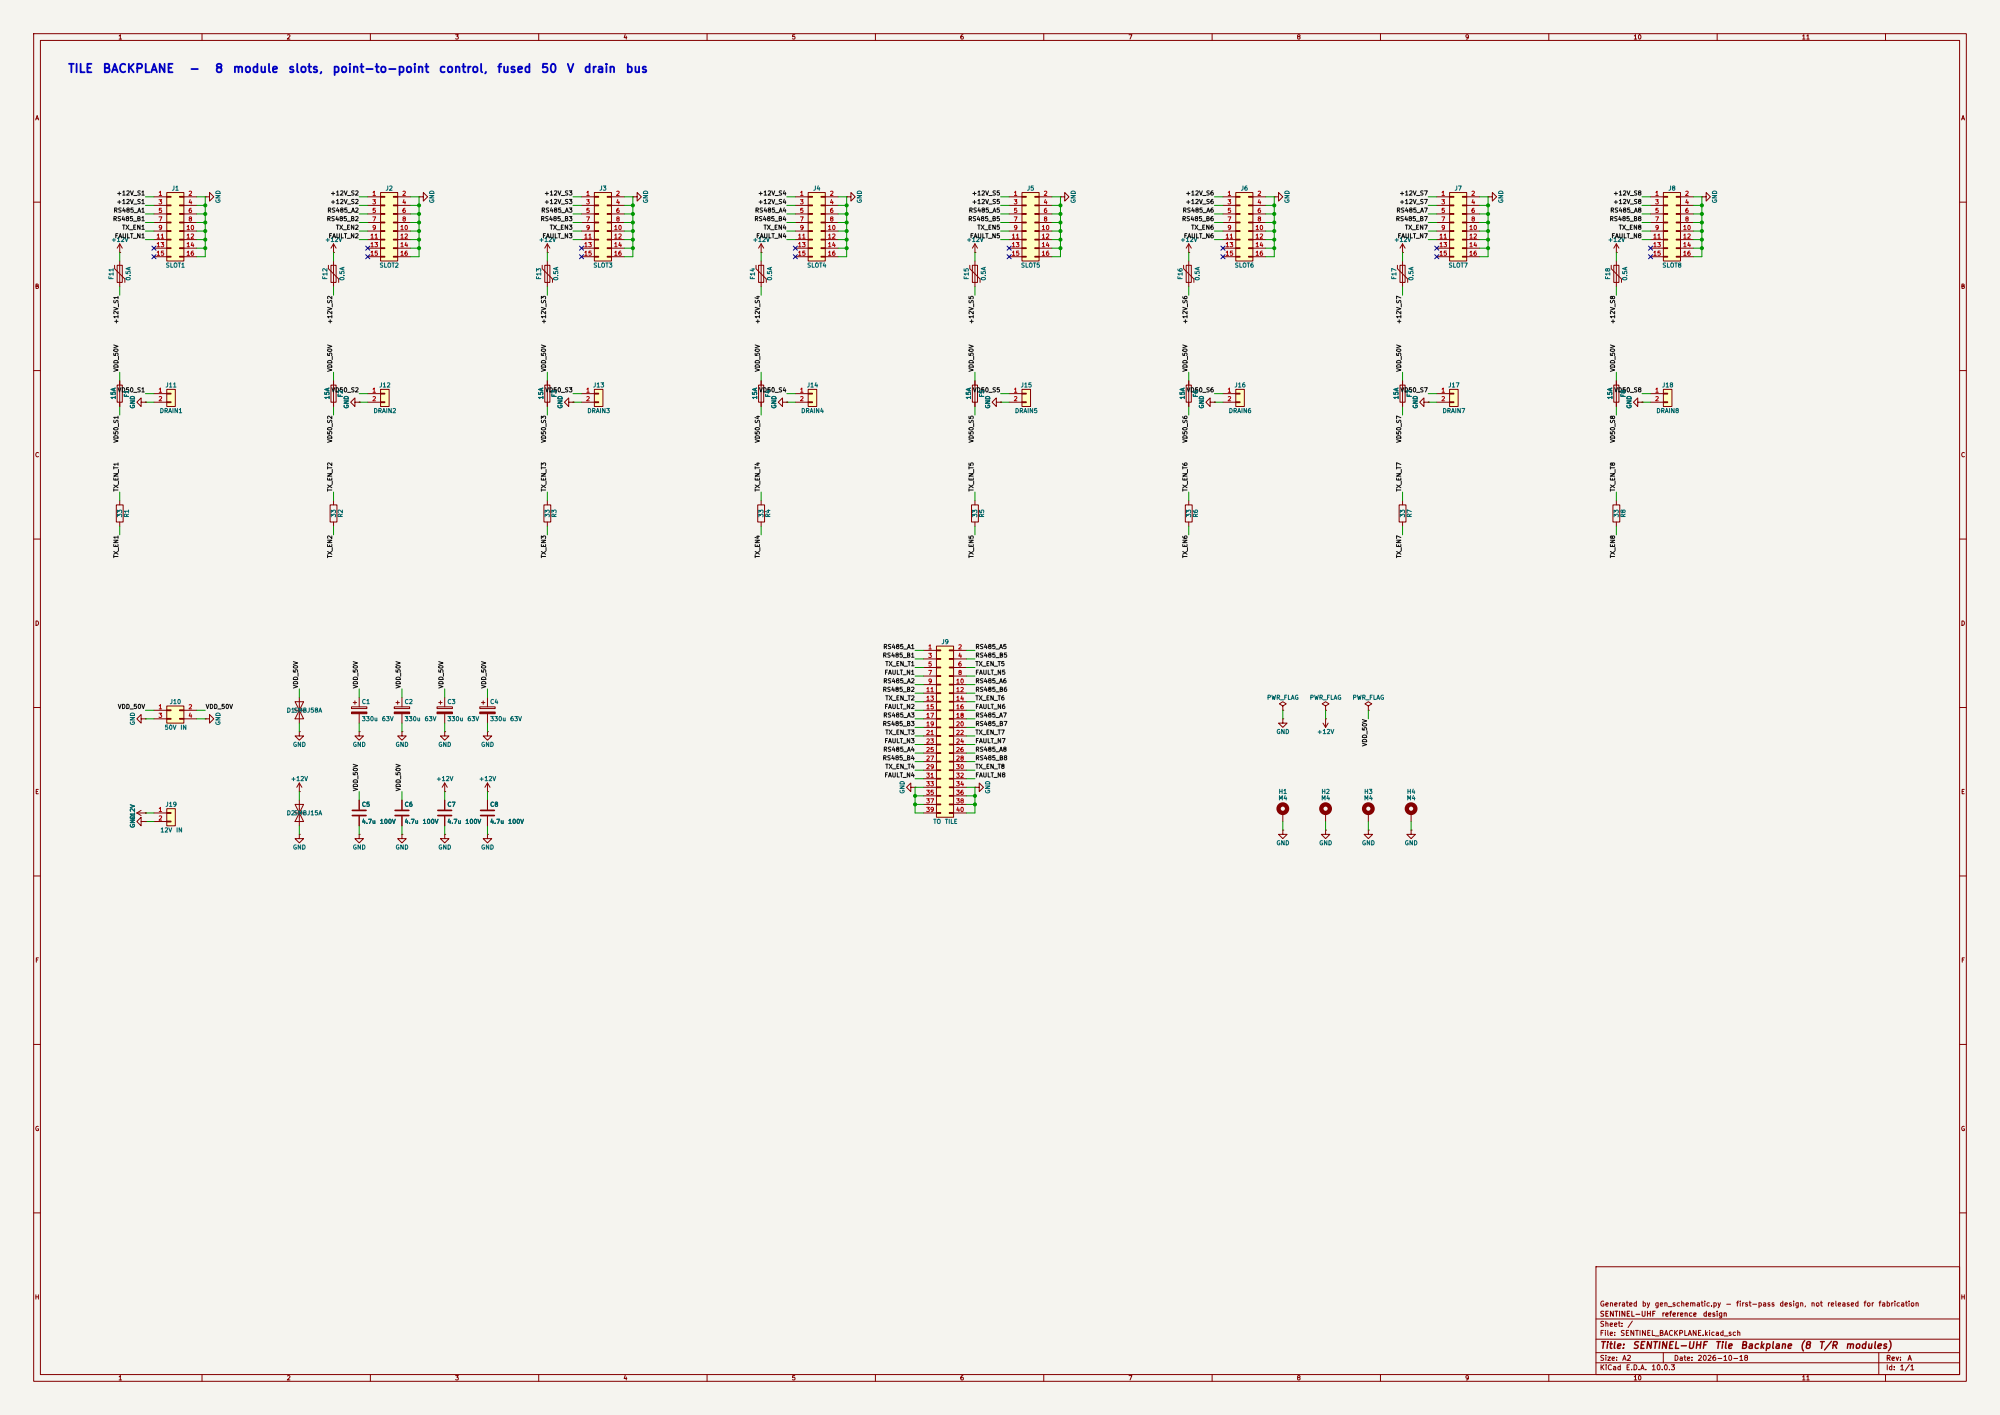
[picture p36: page 1]

35 | 36
37 | 38
39 | 40

Generated by gen_schematic.py - first-pass design, not released for fabrication
SENTINEL-UHF reference design
Sheet: /
File: SENTINEL_BACKPLANE.kicad_sch
Title: SENTINEL-UHF Tile Backplane (8 T/R modules)

Size: A2 | Rev: A
KiCad E.D.A. 10.0.3 | Id: 1/1
