ajisrawi/sentinel-uhf-radar/hardware/cal_board/export/SENTINEL_CAL_schematic.pdf

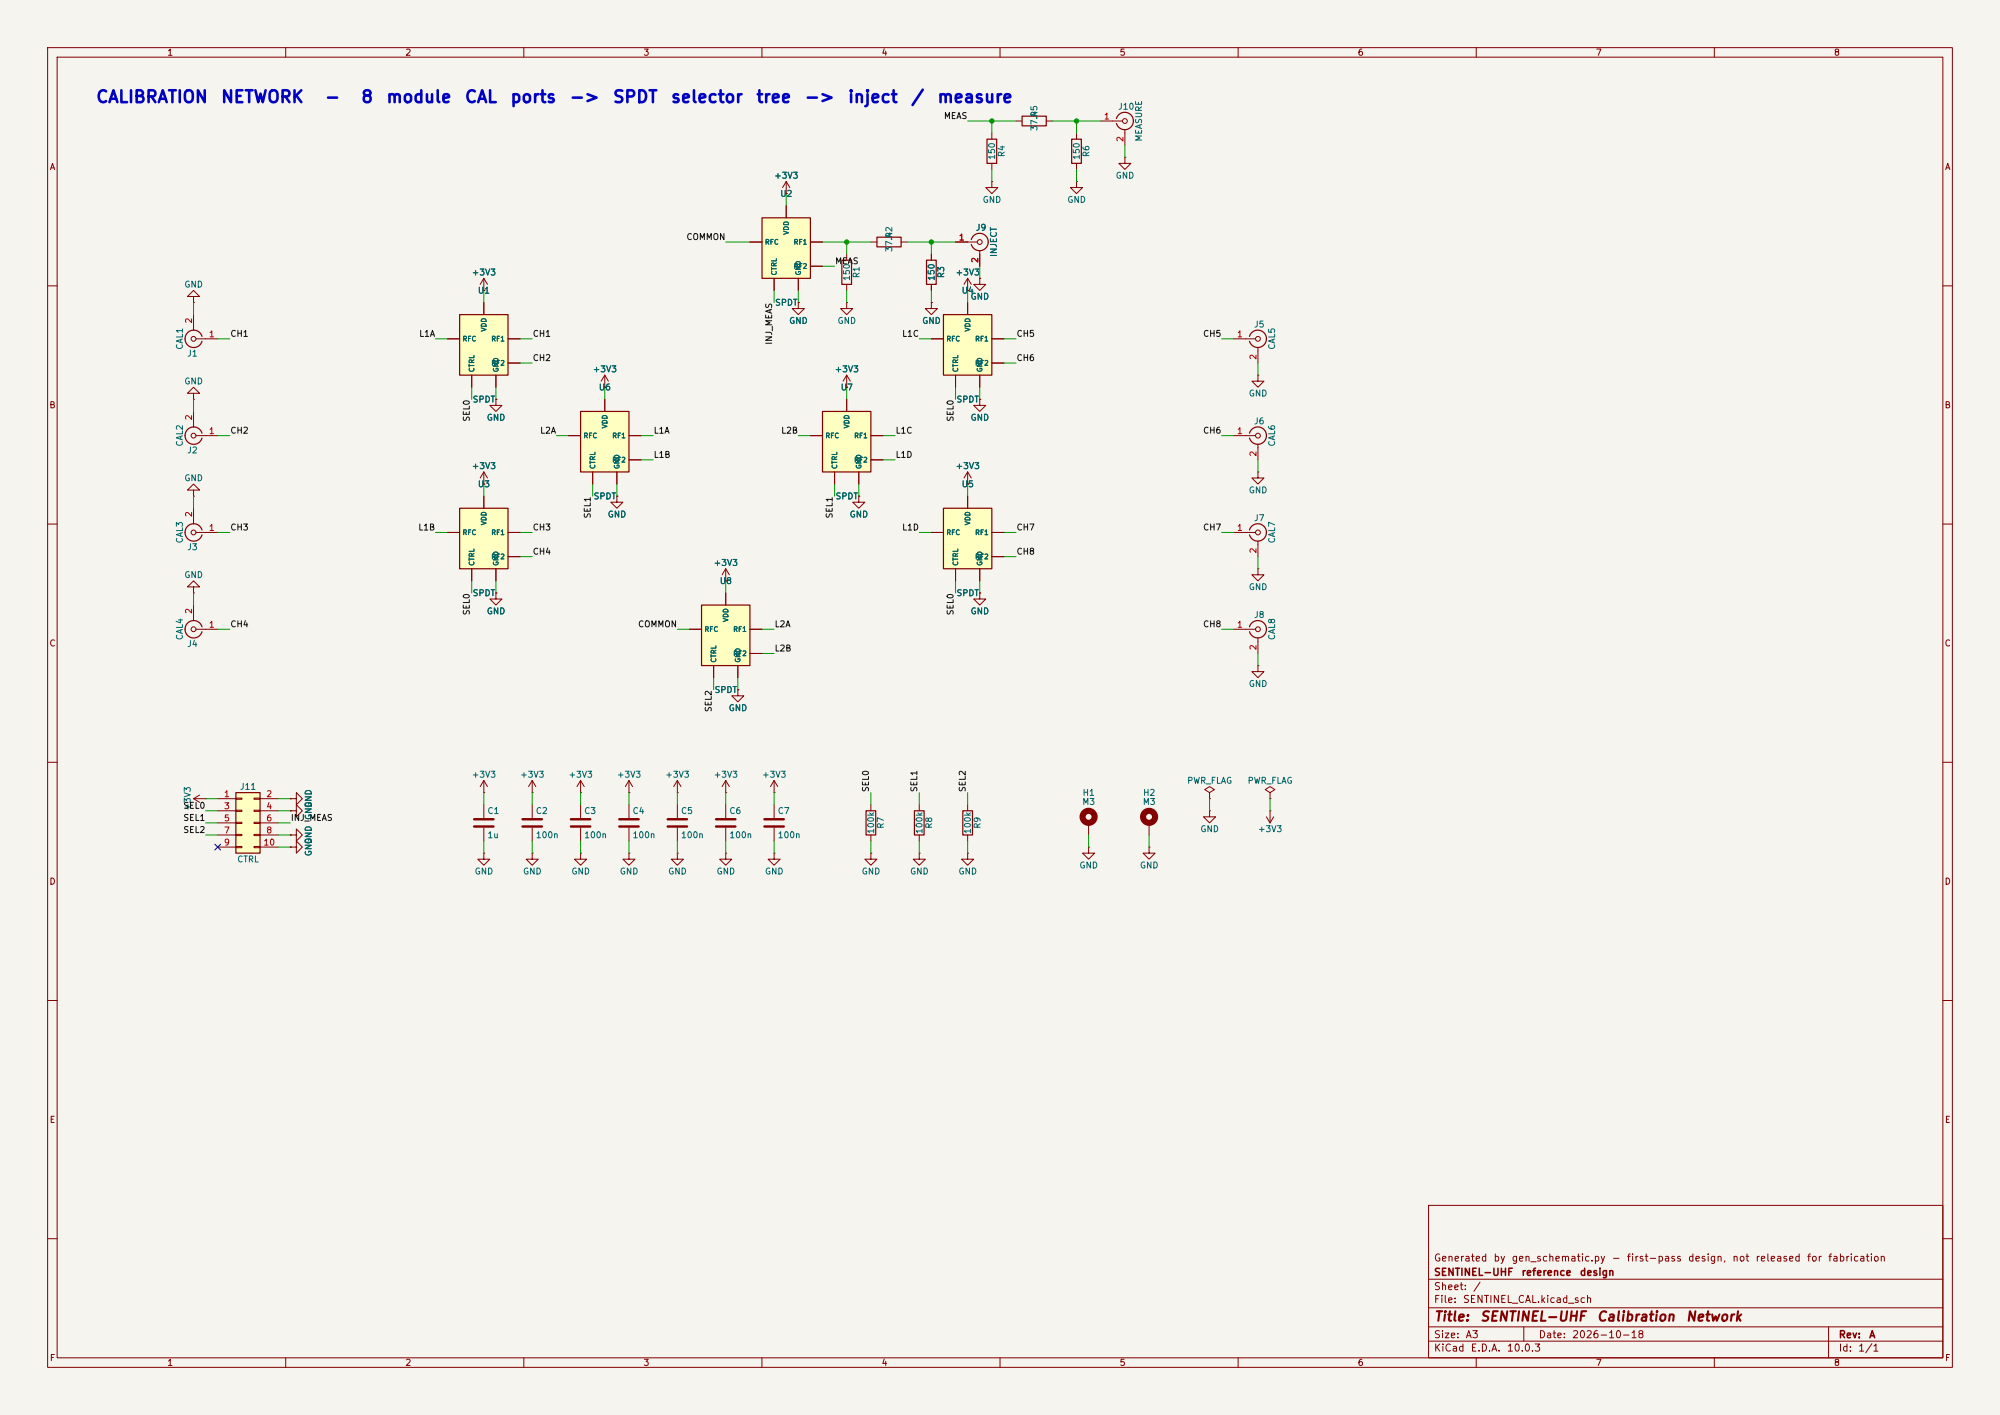
[picture p37: page 1]

L1C CALIBRATION NETWORK - 8 module CAL ports -> SPDT selector tree -> inject / measure

SPDTRF1GNDRF2 CTRL RFC VDD +3V3 GND GND

SPDT RF1GNDRF2 CTRL RFC VDD U3

RF1GNDRF2 CTRL RFC VDD U5
SPDTRF1GNDRF2 CTRL RFC VDD GND

Generated by gen_schematic.py - first-pass design, not released for fabrication
SENTINEL-UHF reference design
Sheet: /
File: SENTINEL_CAL.kicad_sch
Title: SENTINEL-UHF Calibration Network

Size: A3 | Rev: A | F Date: 2026-10-18
KiCad E.D.A. 10.0.3 | Id: 1/1
