ajisrawi/sentinel-uhf-radar/hardware/clock_board/export/SENTINEL_CLOCK_schematic.pdf

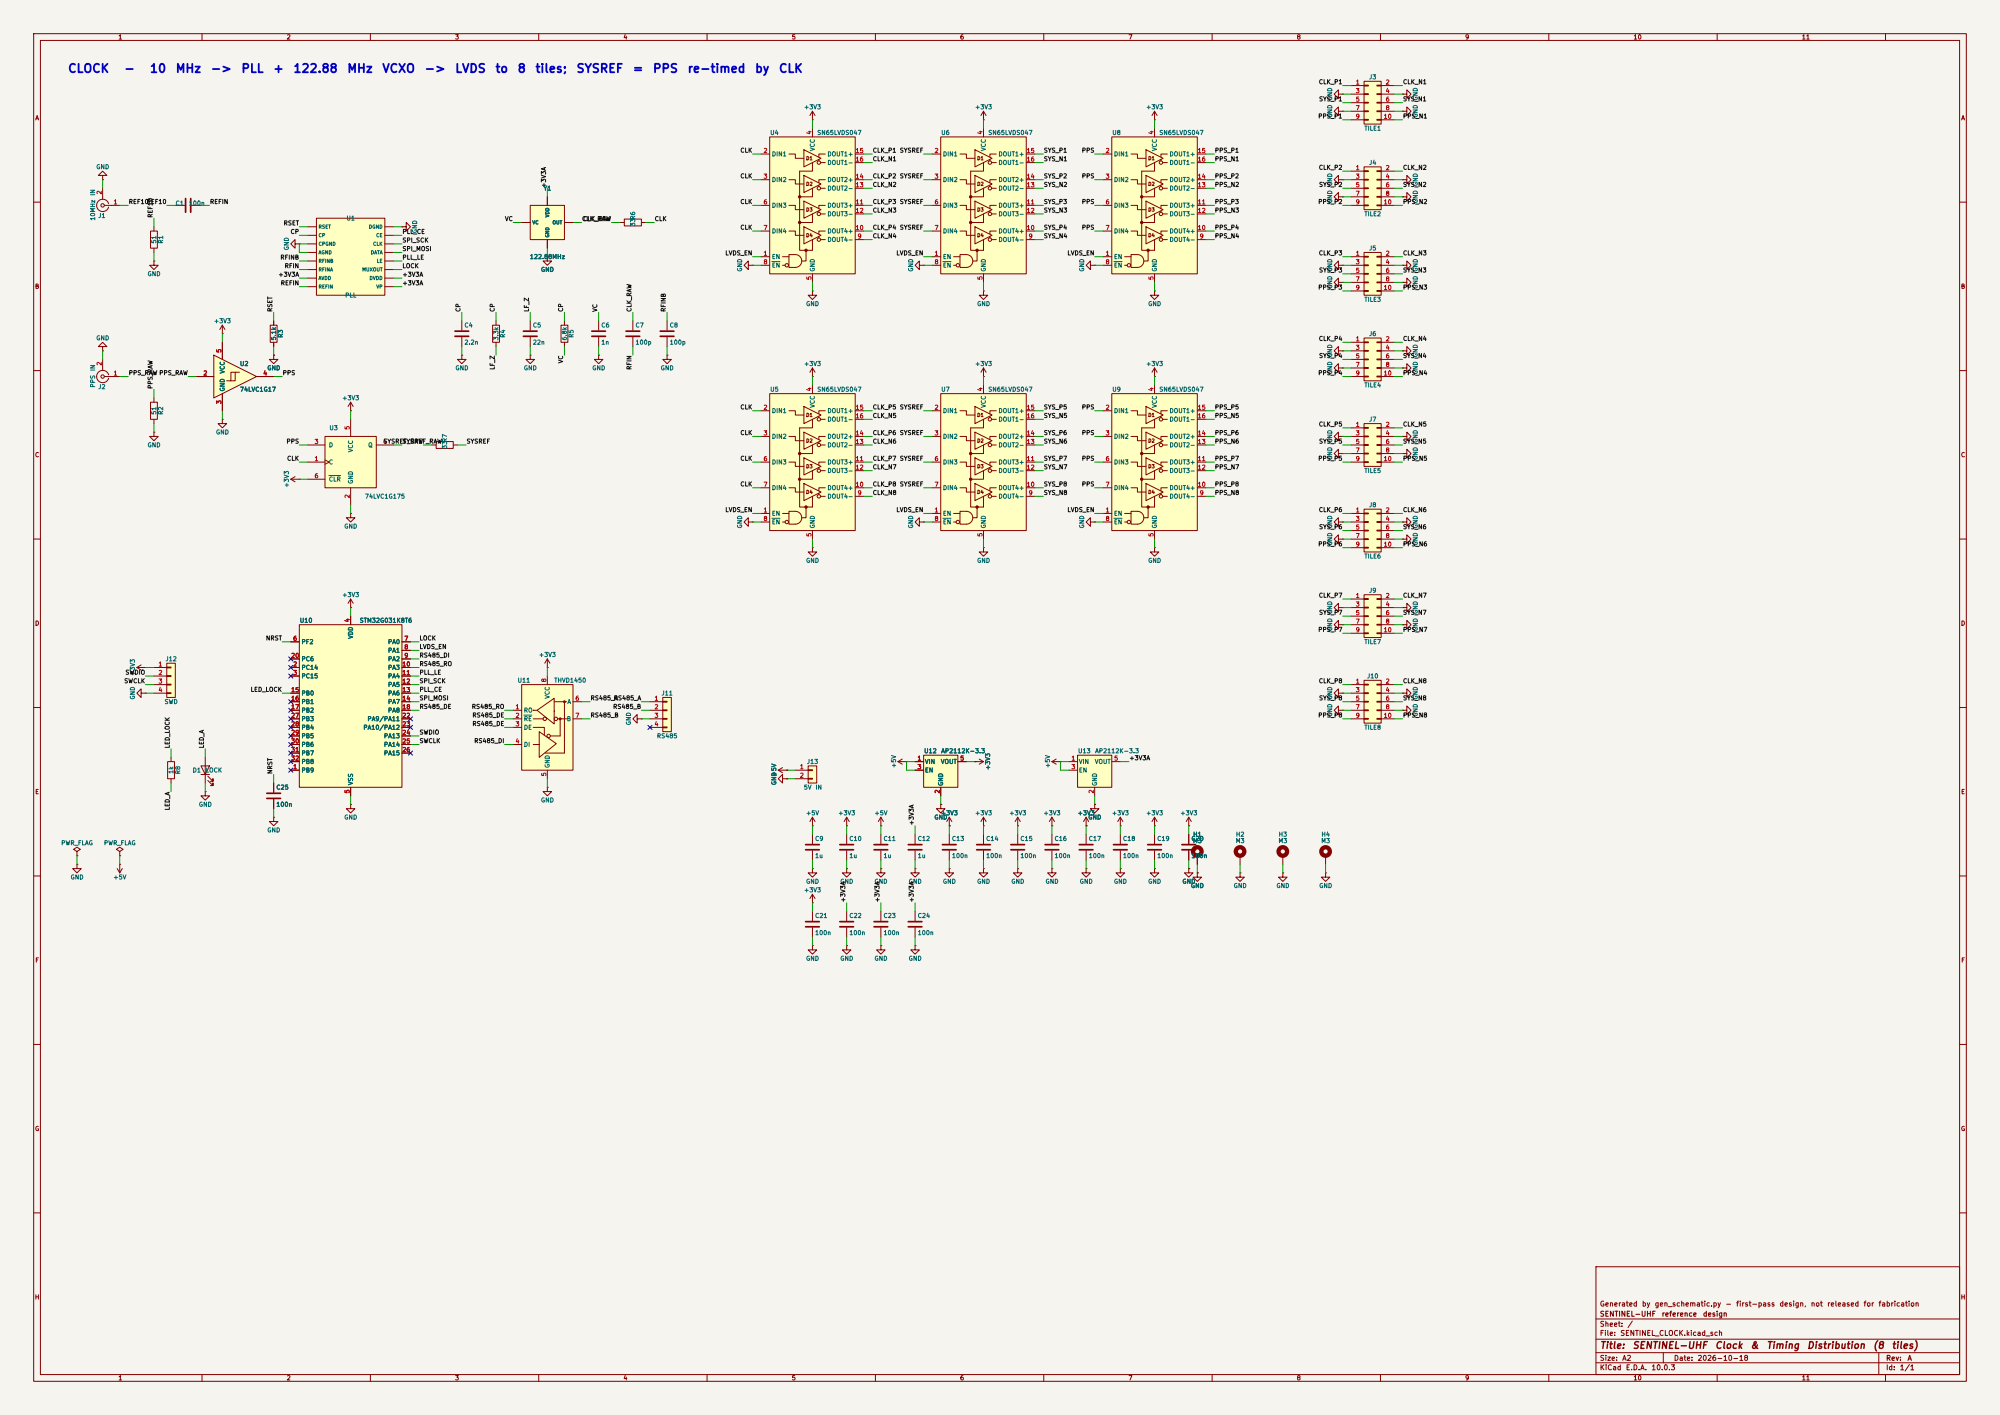
[picture p38: page 1]

CLOCK - 10 MHz -> PLL + 122.88 MHz VCXO -> LVDS to 8 tiles; SYSREF = PPS re-timed by CLK

SYSREF SYSREF CLK_P3 SYSREF CLK

2 PPS J2 IN GND +3V3 +3V3 GND

Generated by gen_schematic.py - first-pass design, not released for fabrication
SENTINEL-UHF reference design
Sheet: /
File: SENTINEL_CLOCK.kicad_sch
Title: SENTINEL-UHF Clock & Timing Distribution (8 tiles)

Size: A2 | Rev: A
KiCad E.D.A. 10.0.3 | Id: 1/1
