ajisrawi/sentinel-uhf-radar/hardware/feed_board/export/SENTINEL_FEED_schematic.pdf

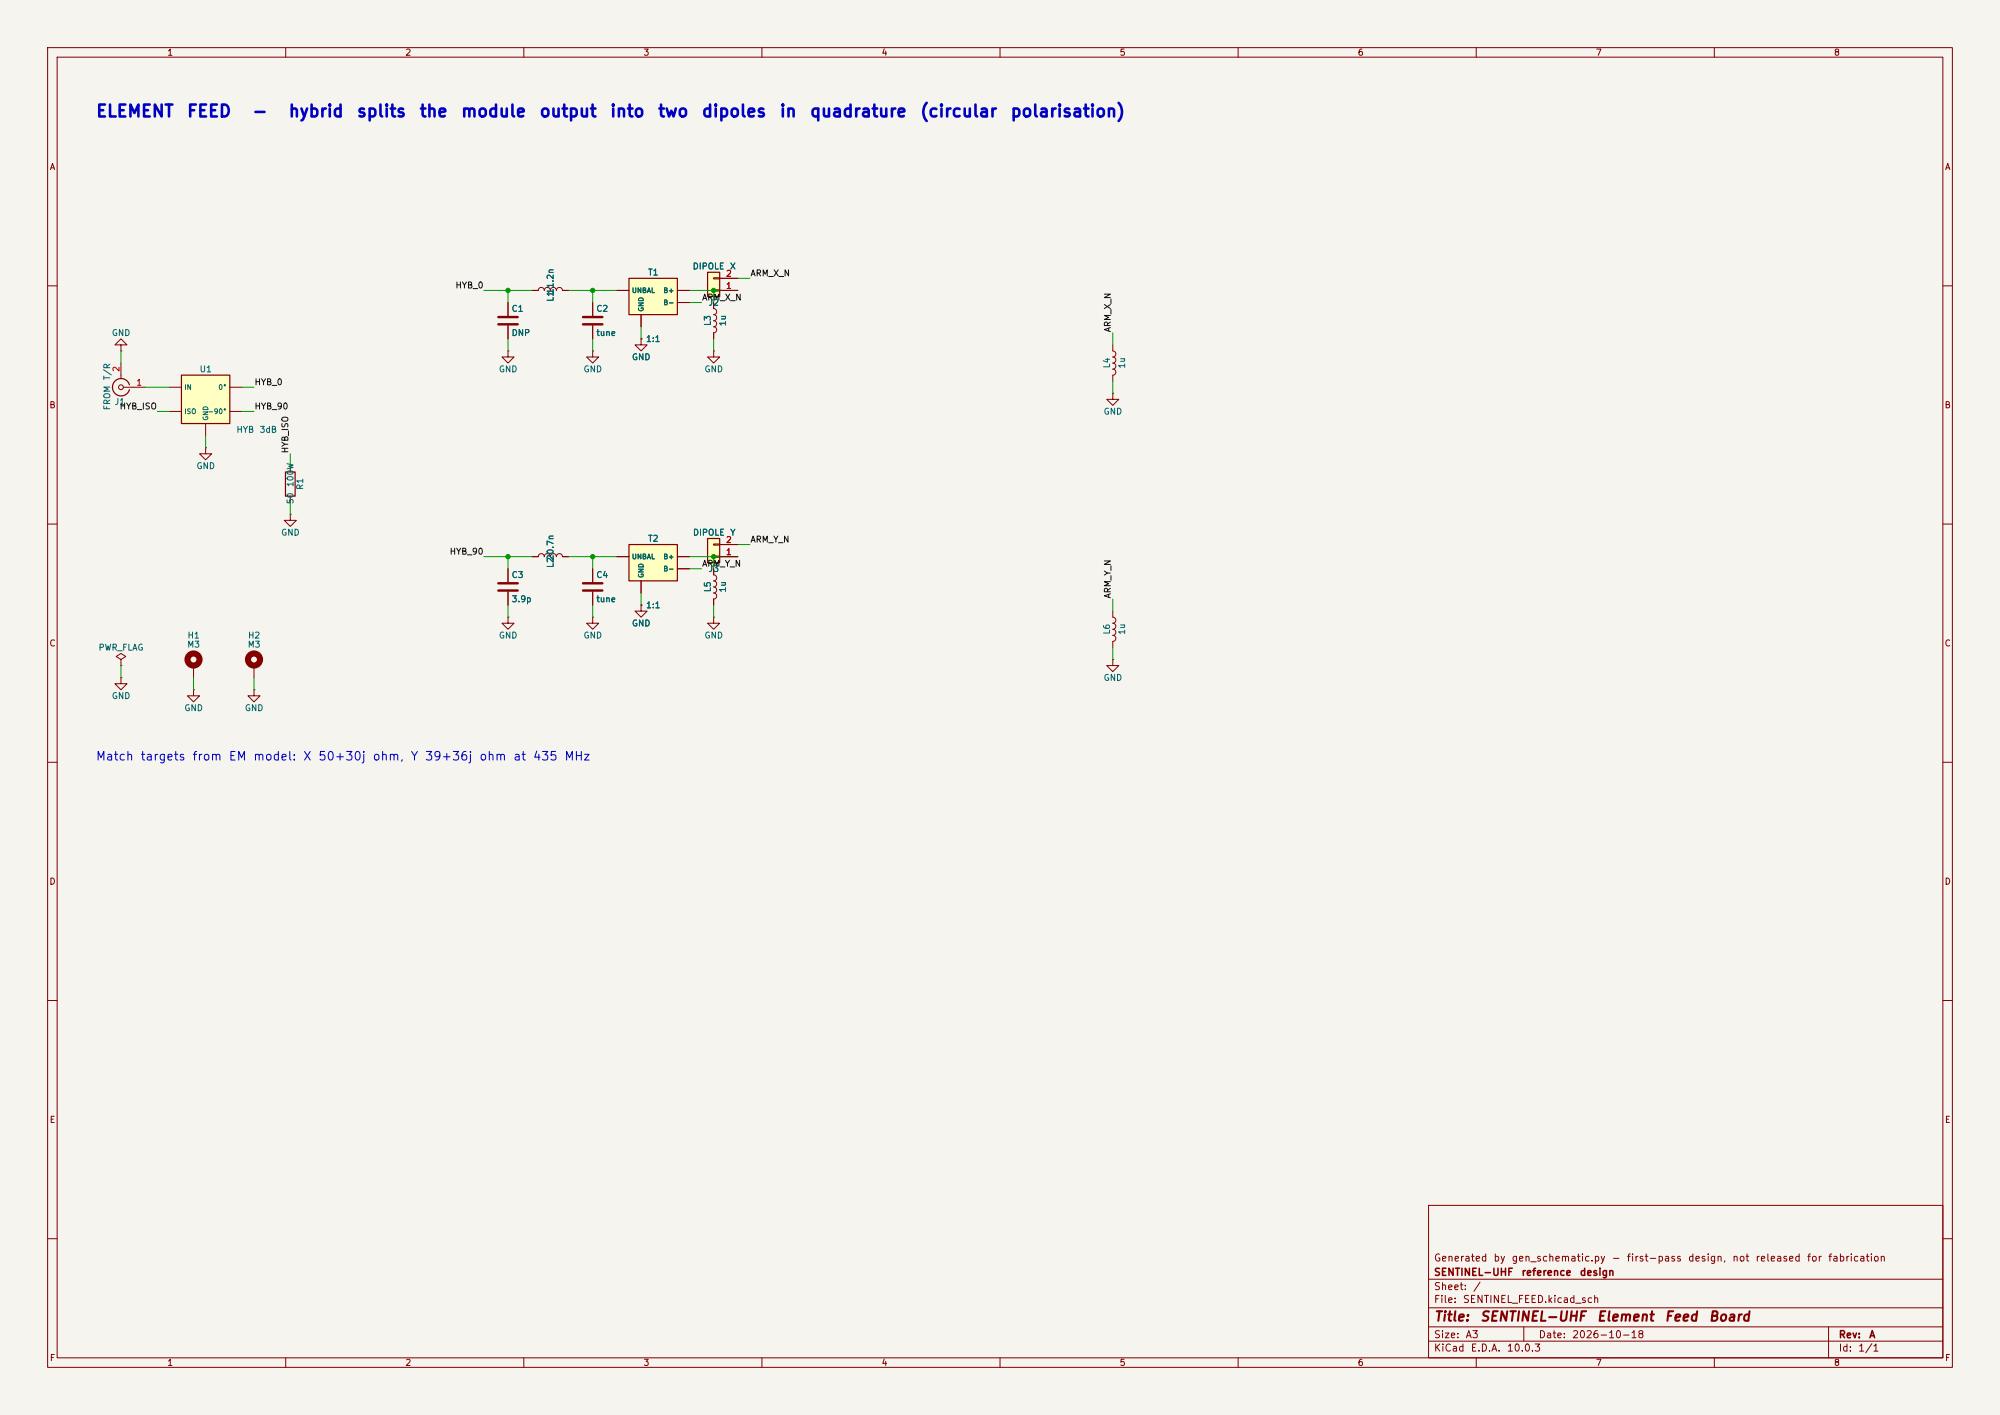
[picture p39: page 1]

HYB_ISO ELEMENT FEED - hybrid splits the module output into two dipoles in quadrature (circular polarisation)

Generated by gen_schematic.py - first-pass design, not released for fabrication L41uGND

Match targets from EM model: X 50+30j ohm, Y 39+36j ohm at 435 MHz

SENTINEL-UHF reference design
Sheet: /
File: SENTINEL_FEED.kicad_sch
Title: SENTINEL-UHF Element Feed Board

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
