ajisrawi/sentinel-uhf-radar/hardware/psu/export/SENTINEL_PSU_schematic.pdf

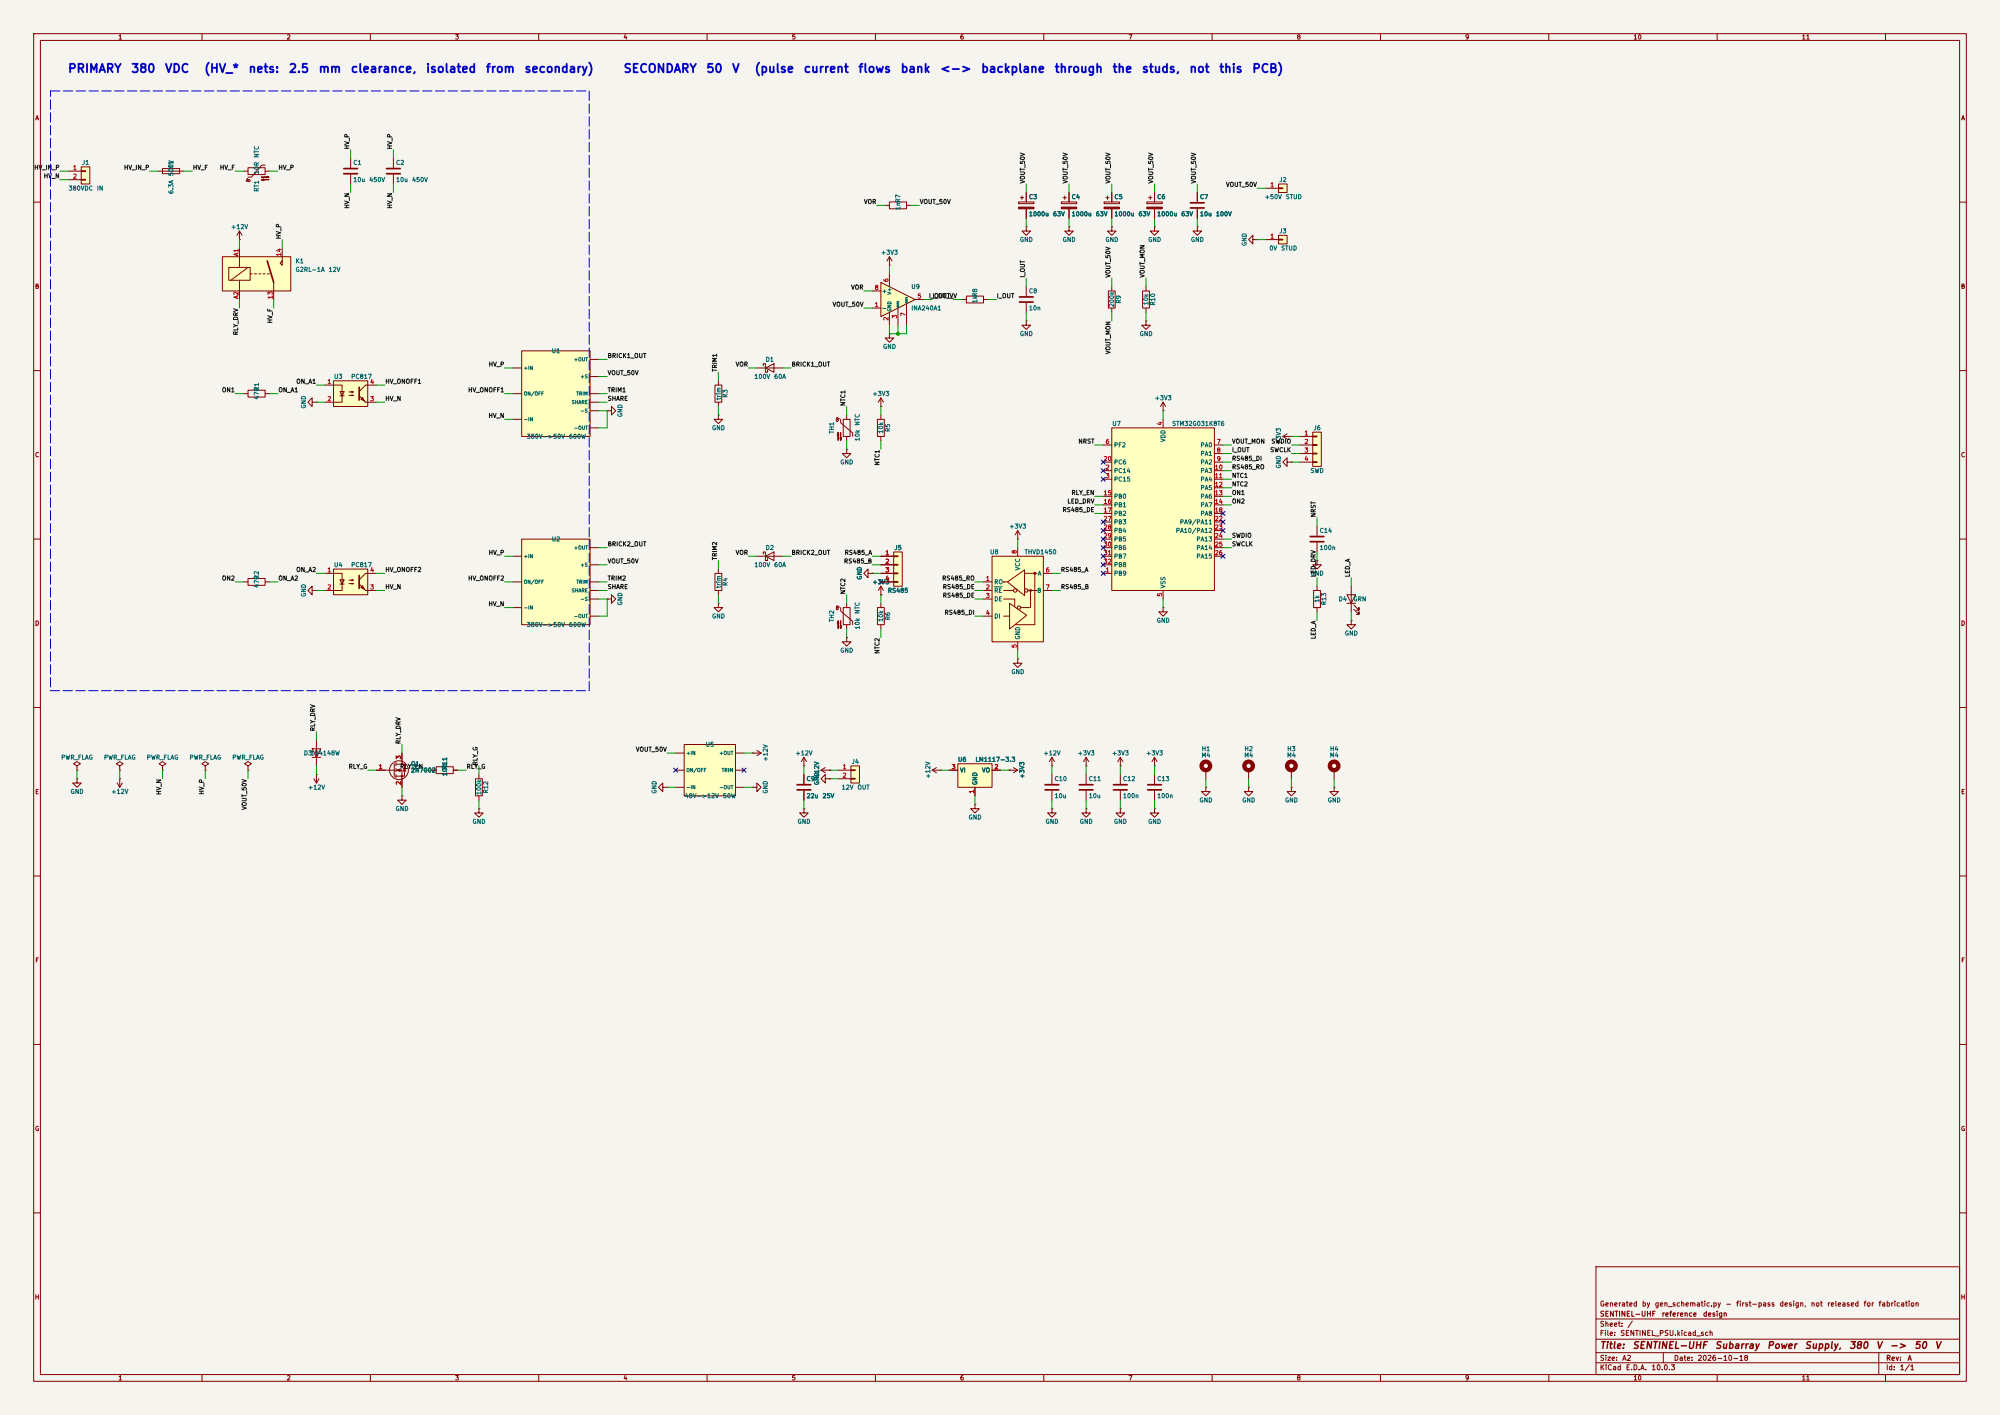
[picture p40: page 1]

Generated by gen_schematic.py - first-pass design, not released for fabrication GND

SENTINEL-UHF reference design
Sheet: /
File: SENTINEL_PSU.kicad_sch
Title: SENTINEL-UHF Subarray Power Supply, 380 V -> 50 V

Size: A2 | Rev: A
KiCad E.D.A. 10.0.3 | Id: 1/1
