ajisrawi/sentinel-uhf-radar/(list of files, drawings)

Other design files:
hardware/rfsoc_tile/easyeda_routes.json
hardware/tr_module/easyeda_routes.json
