ajisrawi/sentinel-uhf-radar/hardware/tr_module/SENTINEL_TRM.kicad_pcb

## KiCad design hardware/tr_module/SENTINEL_TRM.kicad_pcb (2026-10-20)

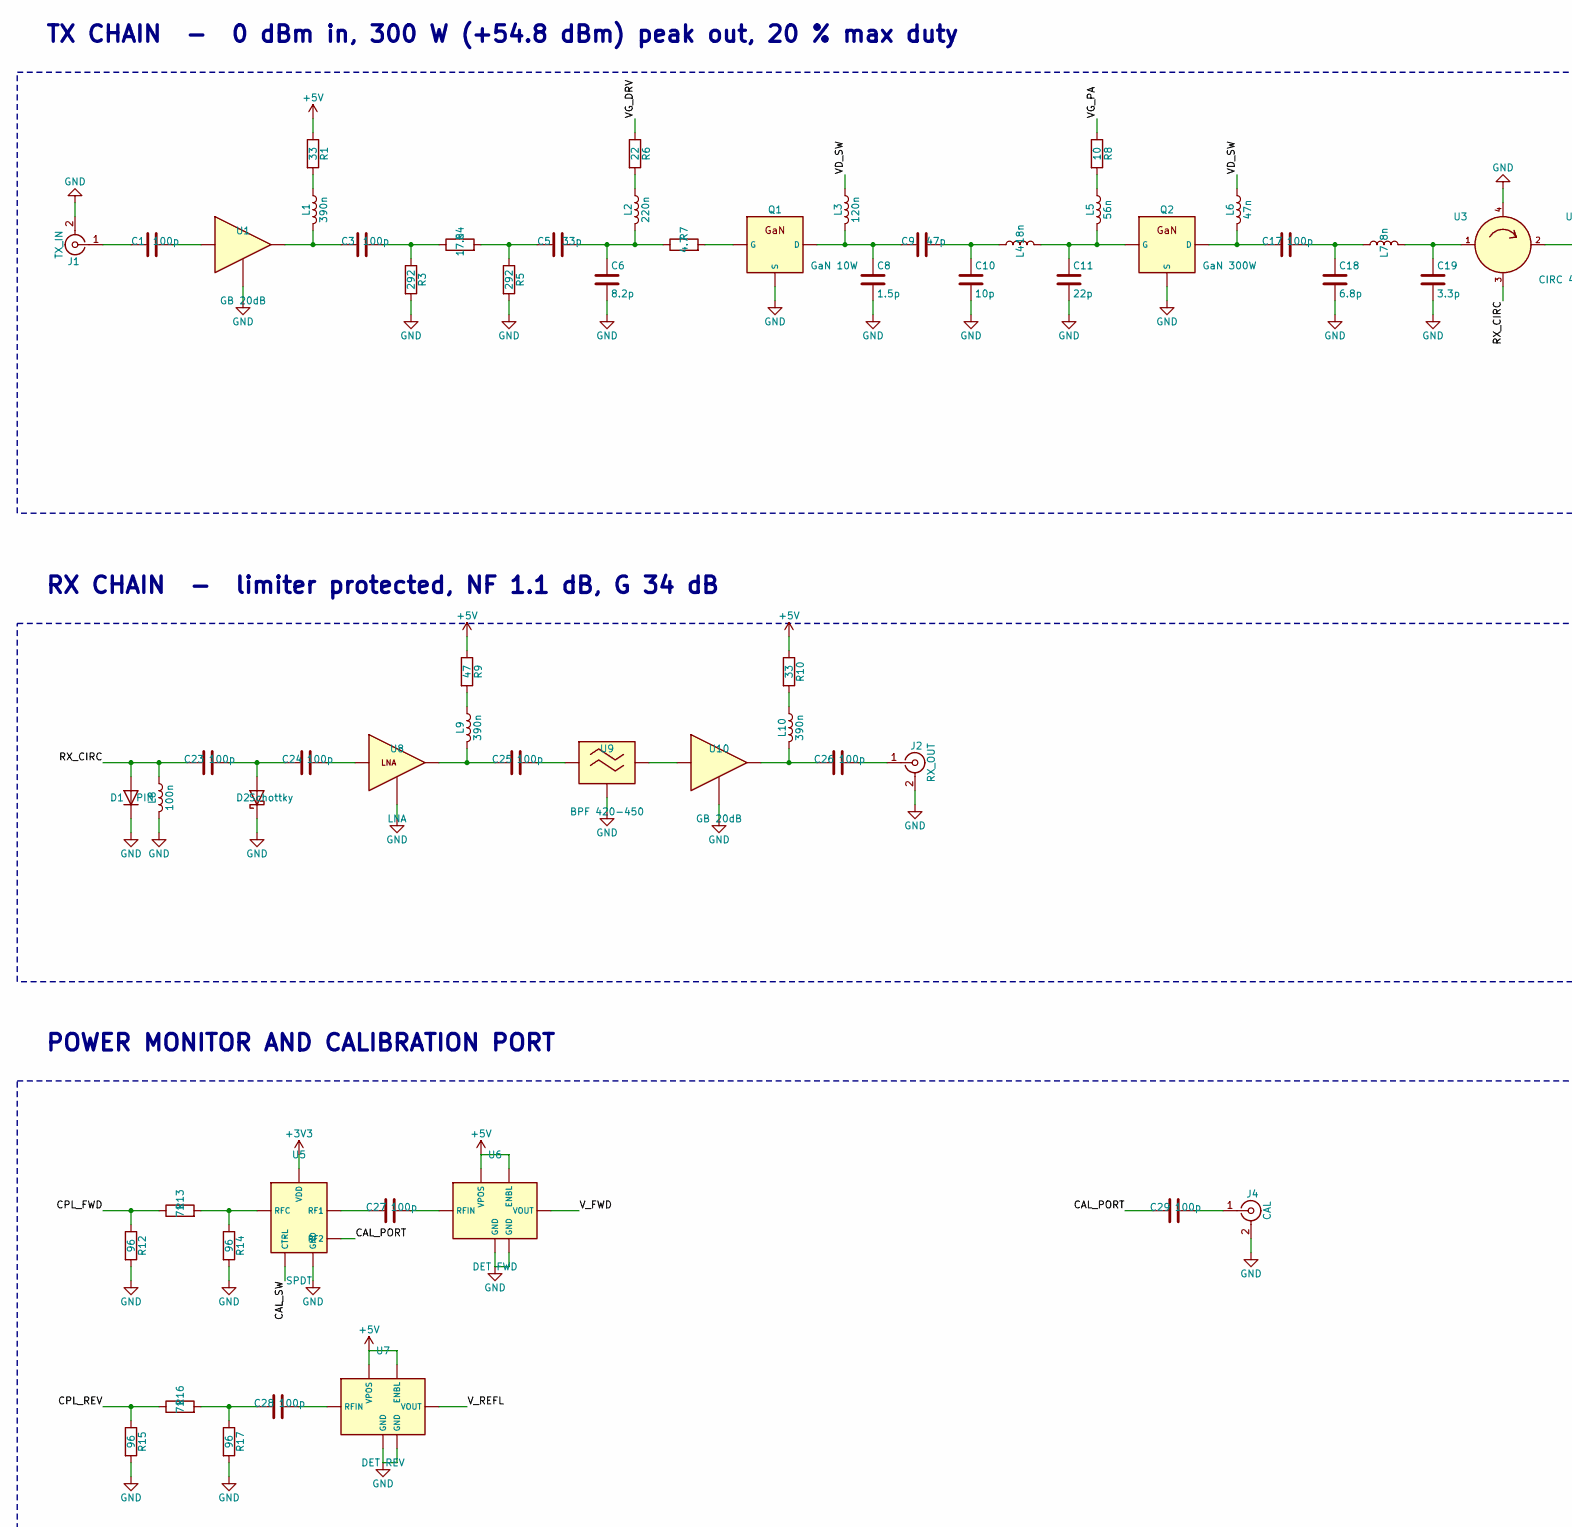
[picture p42: schematic SENTINEL_TRM.kicad_sch, SENTINEL-UHF T/R Module, 420-450 MHz, 300 W, part in row 1, column 1]

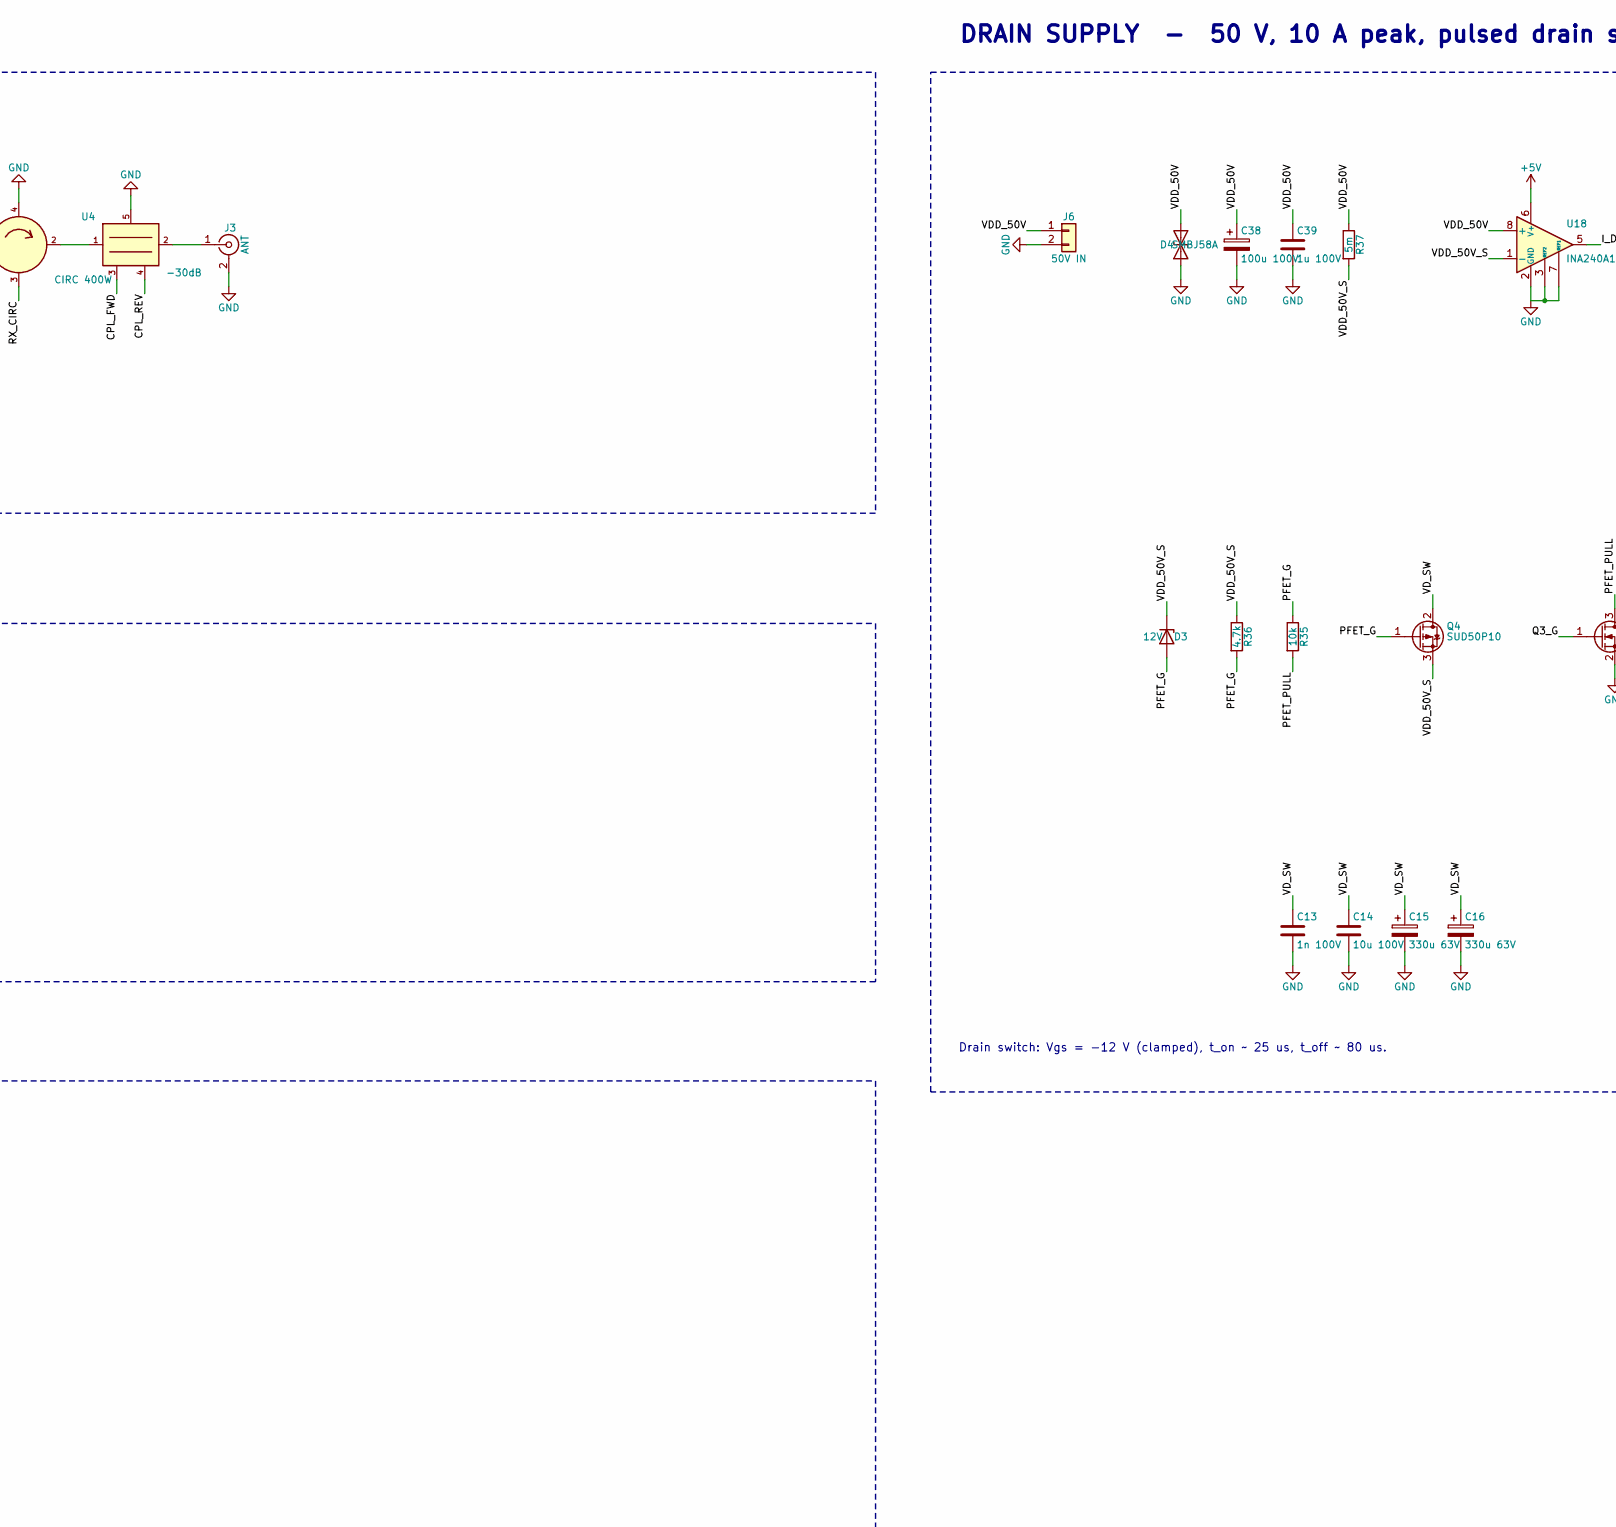
[picture p43: schematic SENTINEL_TRM.kicad_sch, SENTINEL-UHF T/R Module, 420-450 MHz, 300 W, part in row 1, column 2]

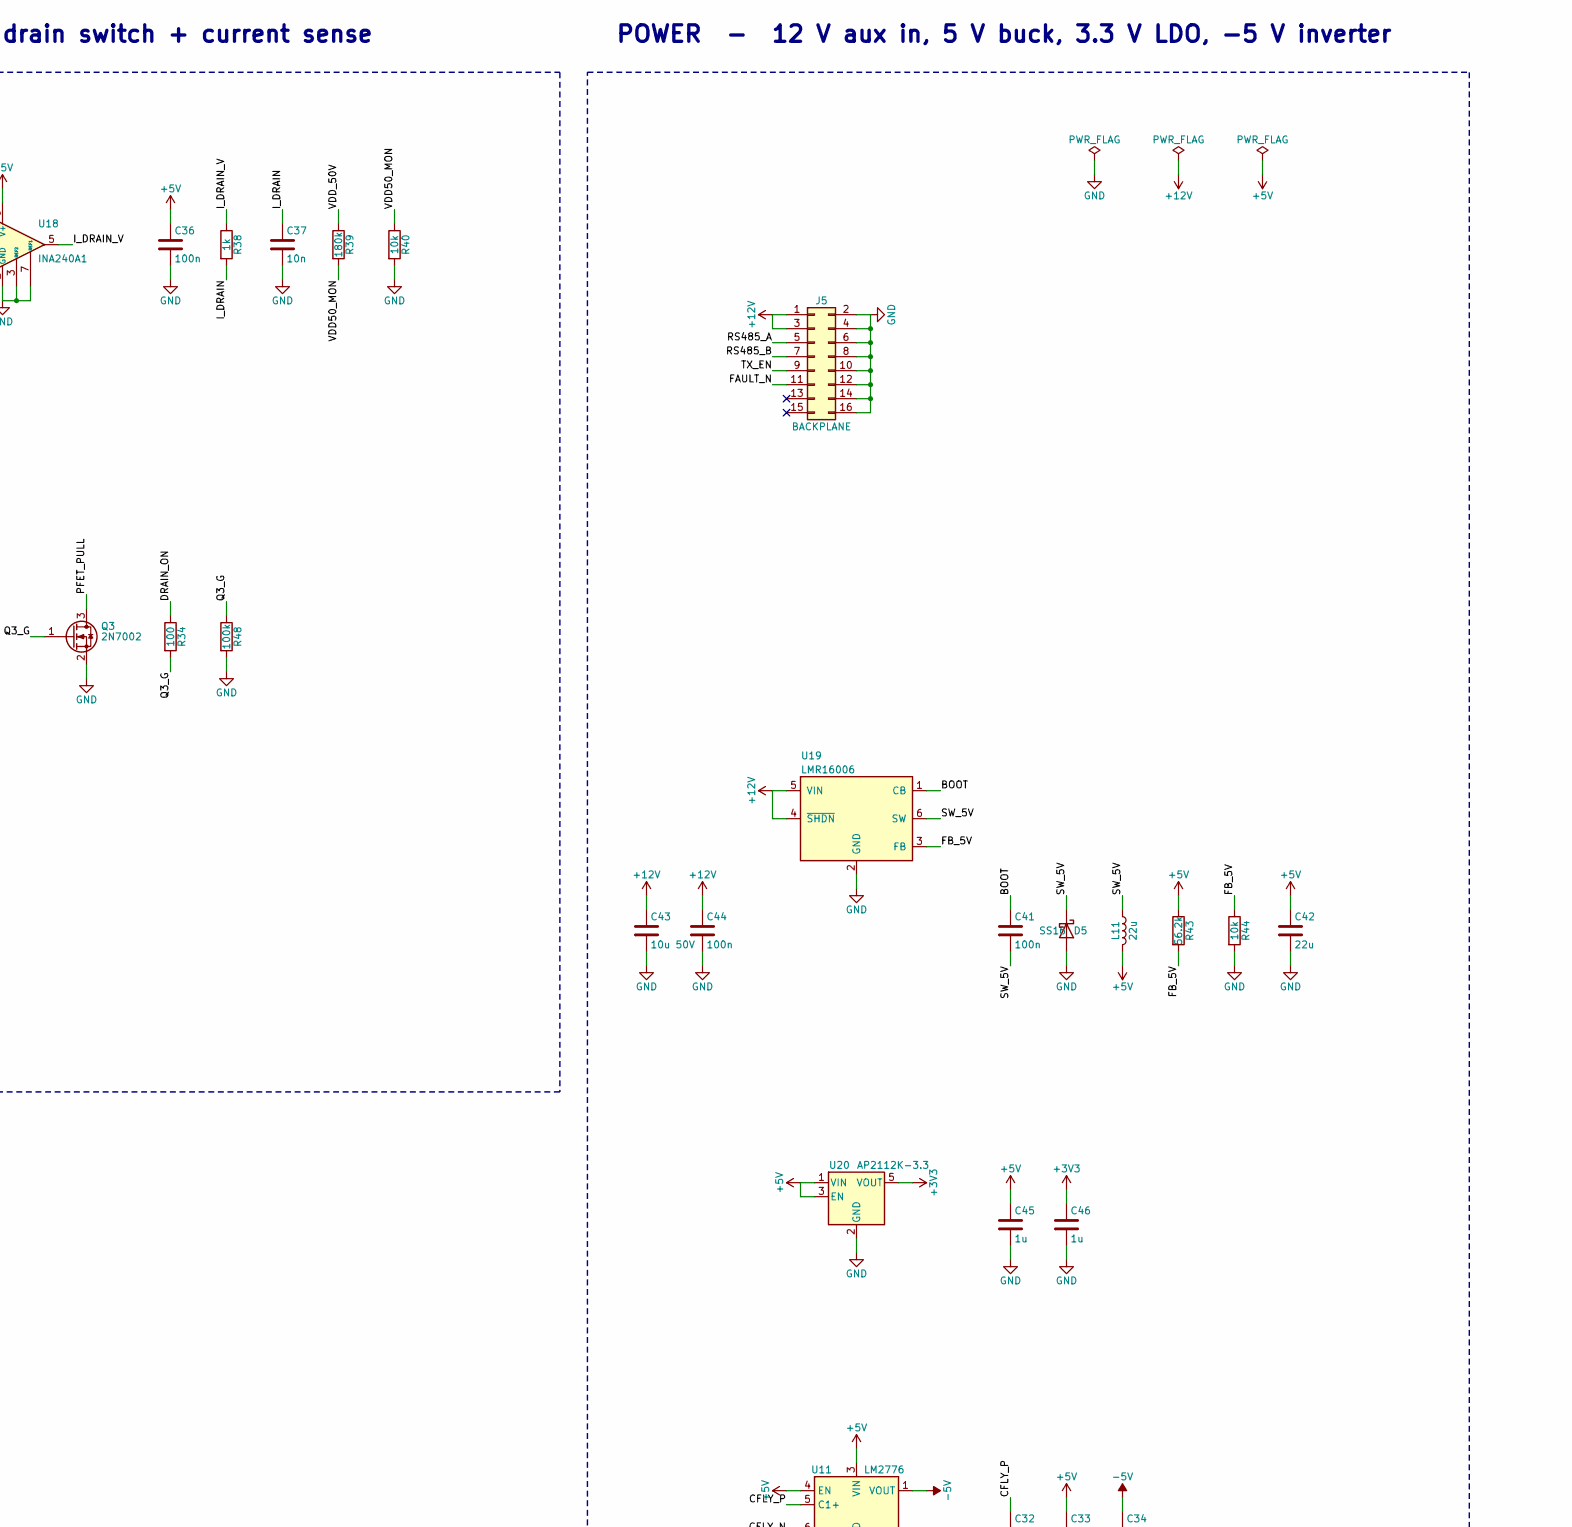
[picture p44: schematic SENTINEL_TRM.kicad_sch, SENTINEL-UHF T/R Module, 420-450 MHz, 300 W, part in row 1, column 3]

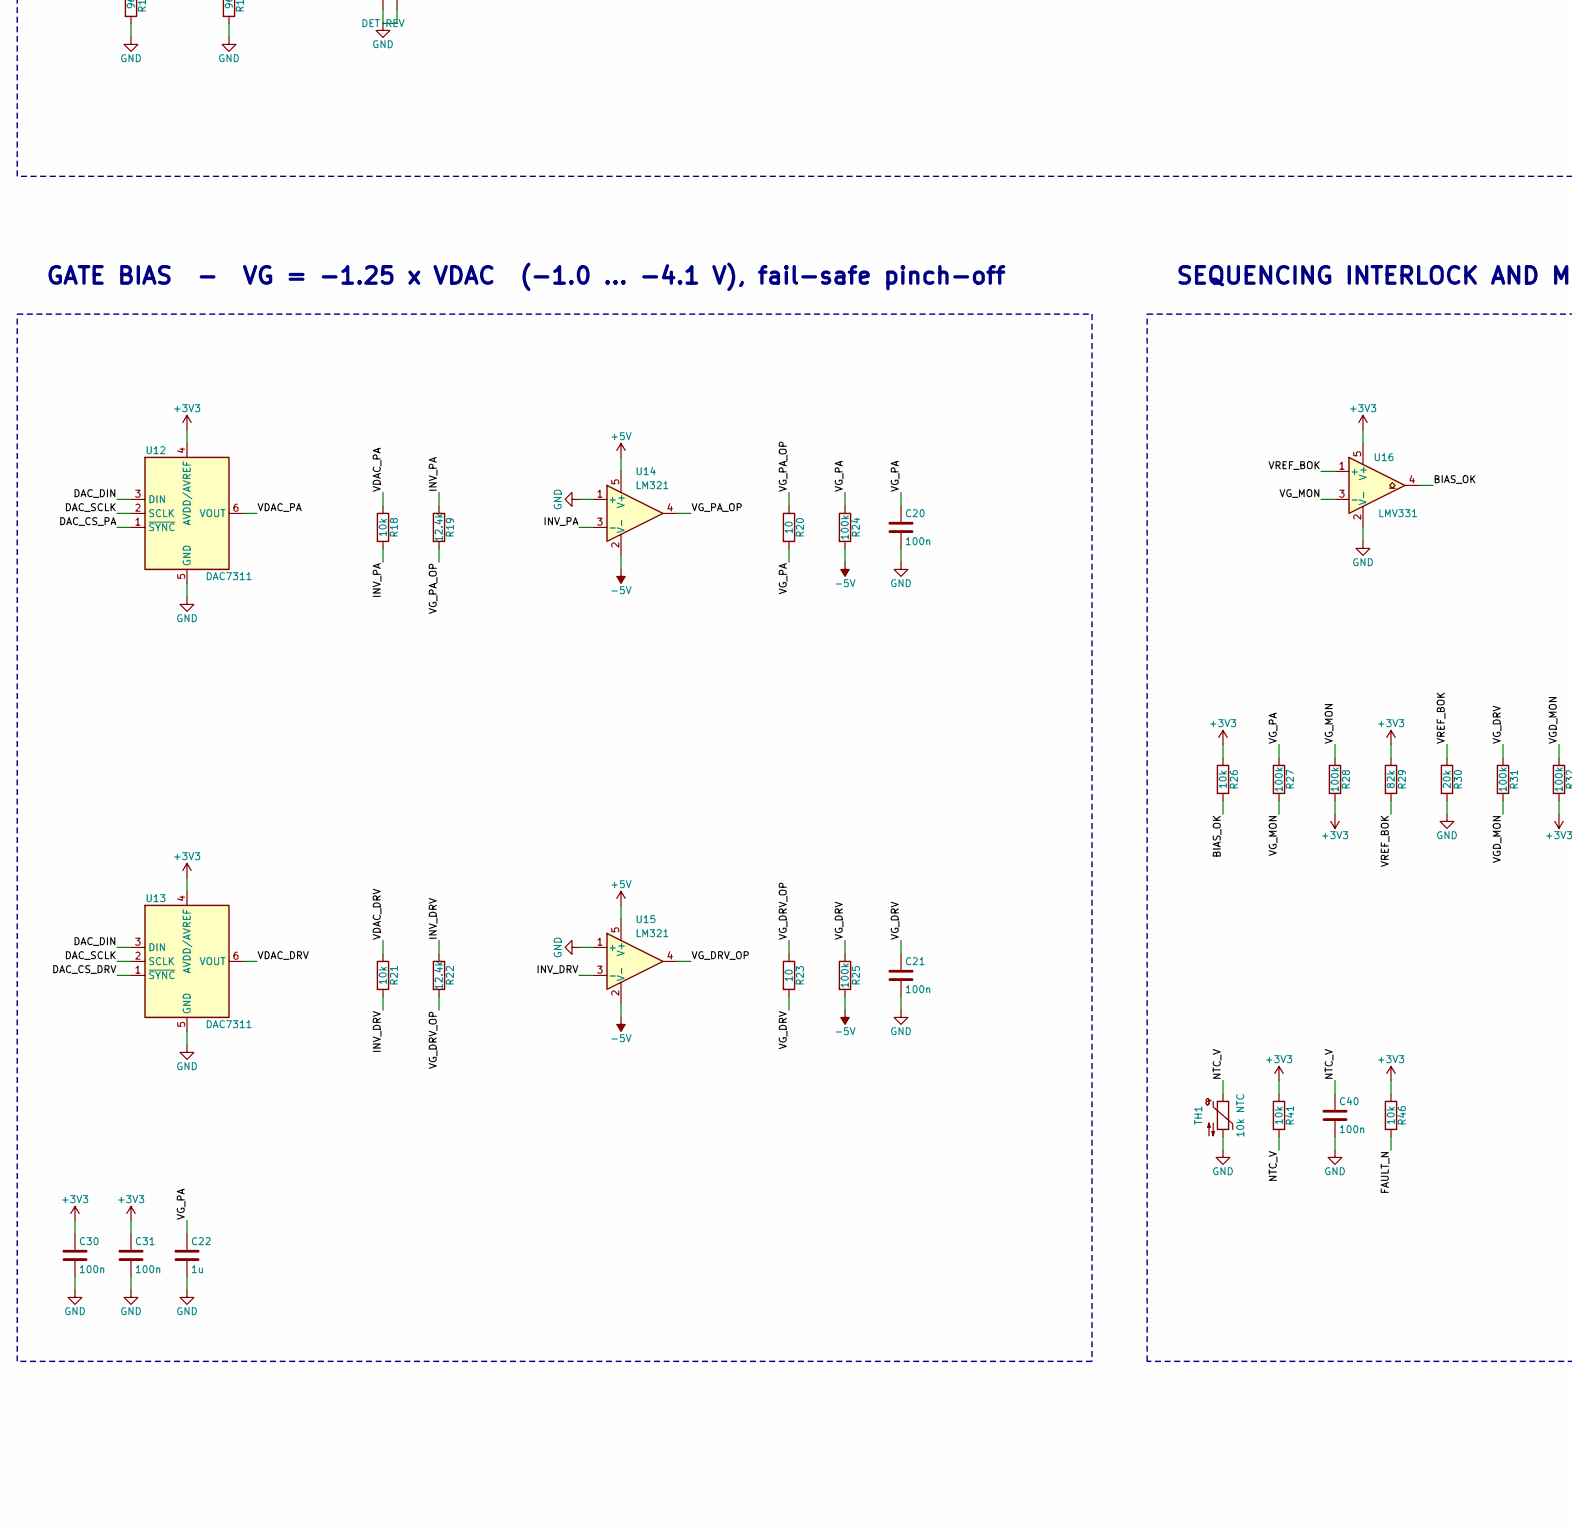
[picture p45: schematic SENTINEL_TRM.kicad_sch, SENTINEL-UHF T/R Module, 420-450 MHz, 300 W, part in row 2, column 1]

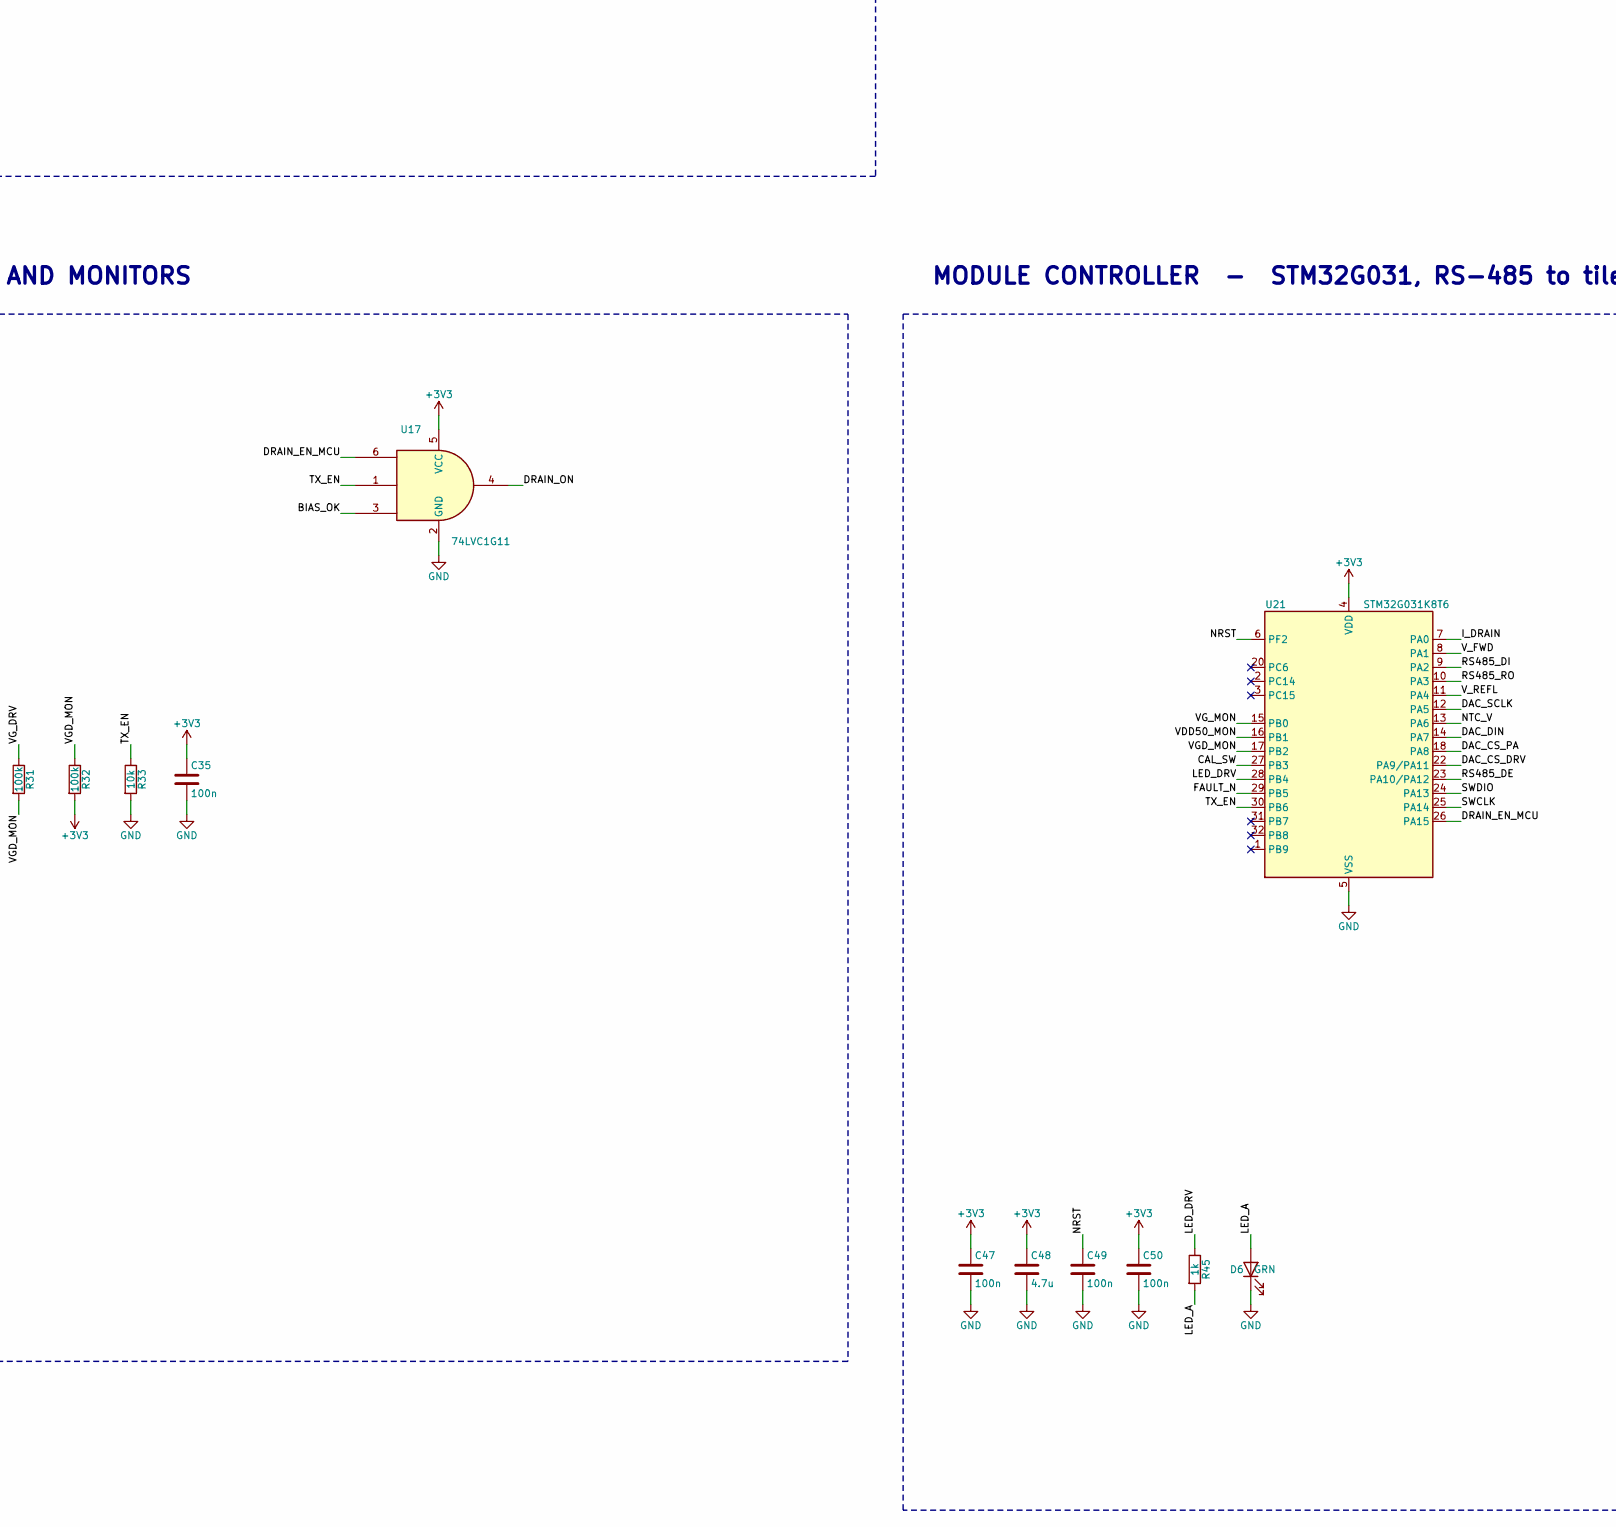
[picture p46: schematic SENTINEL_TRM.kicad_sch, SENTINEL-UHF T/R Module, 420-450 MHz, 300 W, part in row 2, column 2]

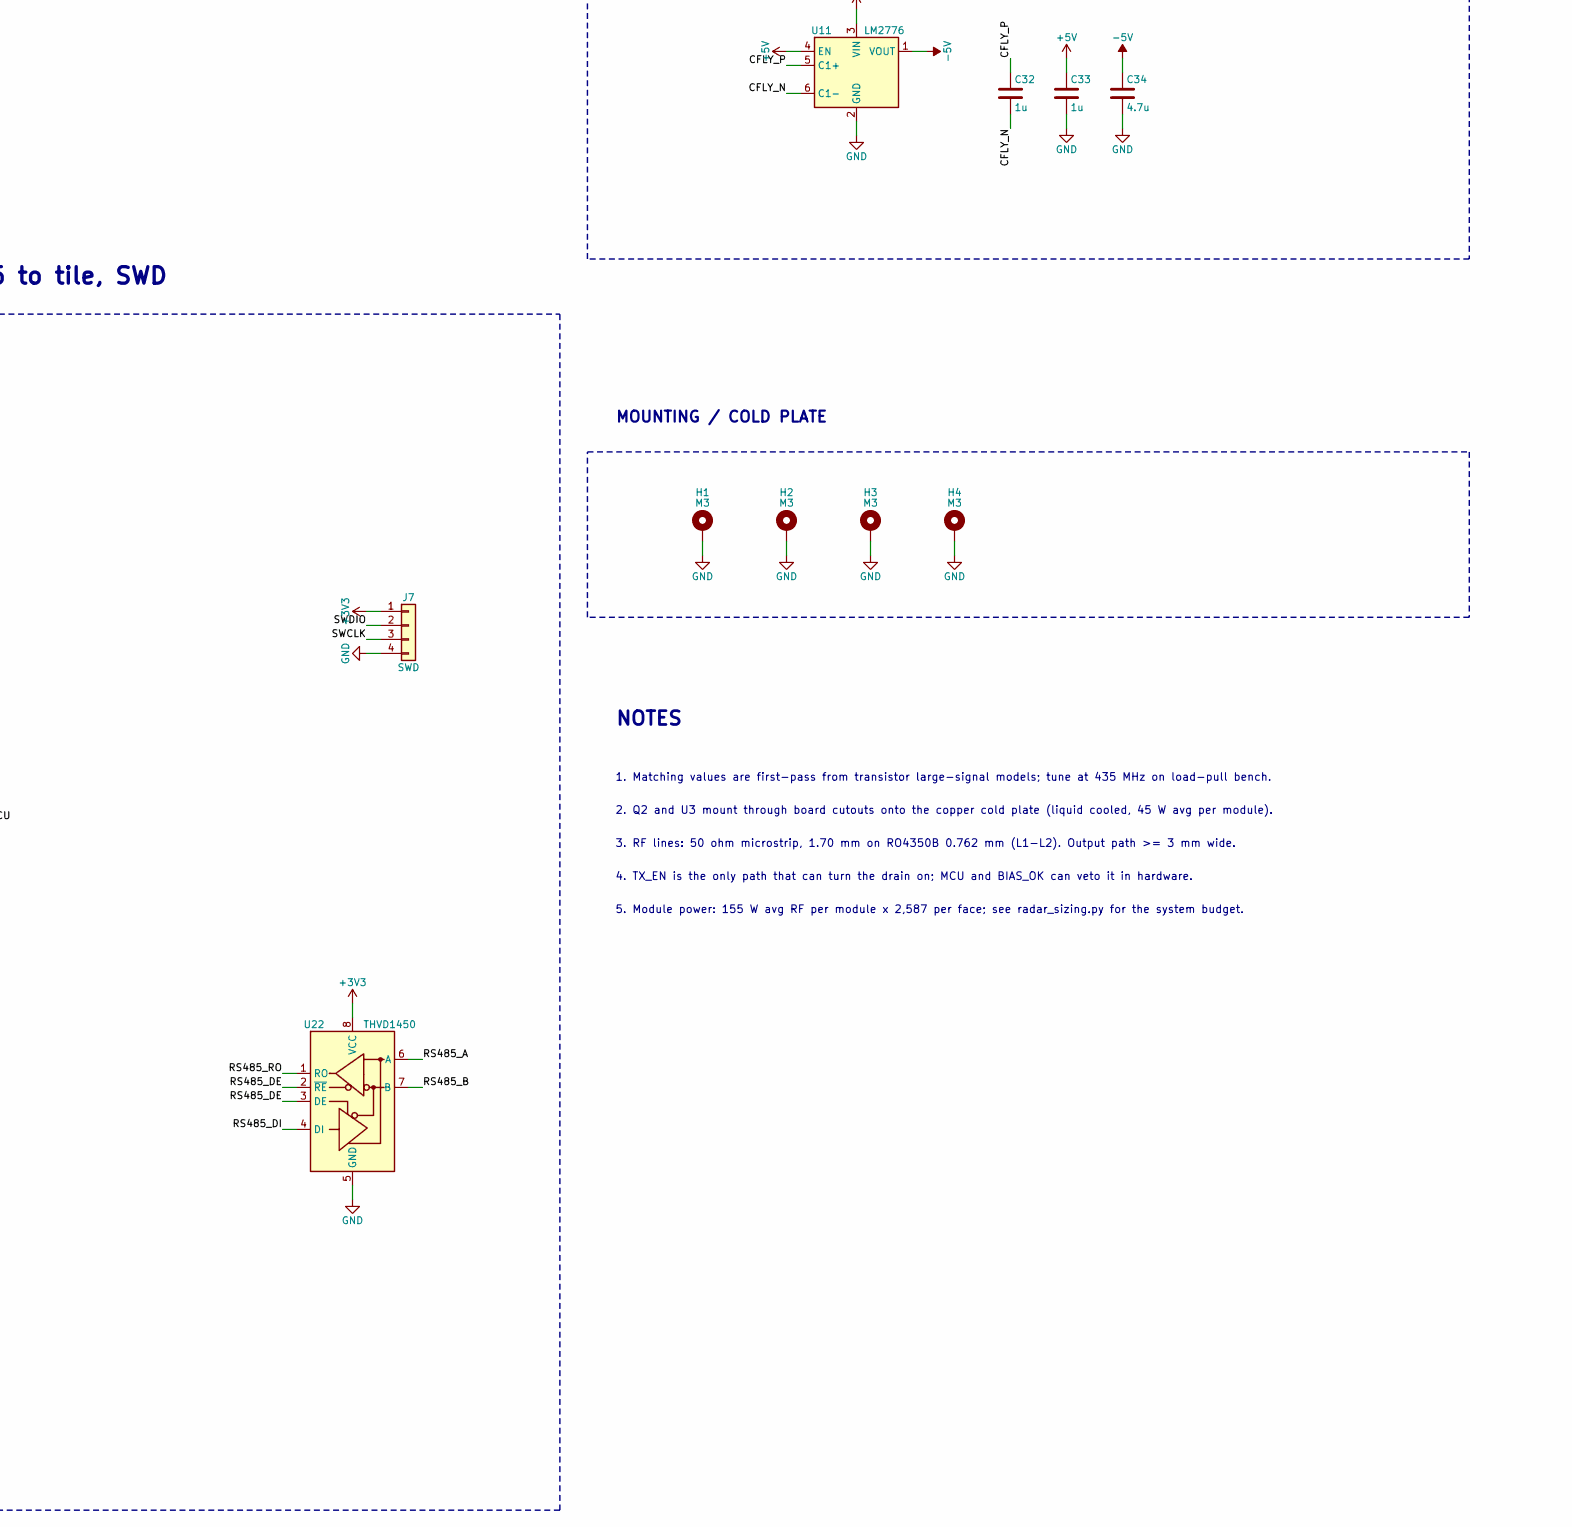
[picture p47: schematic SENTINEL_TRM.kicad_sch, SENTINEL-UHF T/R Module, 420-450 MHz, 300 W, part in row 2, column 3]

Parts:
C1, C3, C23, C24, C25, C26, C27, C28, C29: 100p; C_0603_1608Metric
C5: 33p; C_0603_1608Metric
C6: 8.2p; C_0603_1608Metric
C8: 1.5p; C_0805_2012Metric
C9: 47p; C_0805_2012Metric
C10: 10p; C_0805_2012Metric
C11: 22p; C_1206_3216Metric
C13: 1n 100V; C_1210_3225Metric
C14: 10u 100V; C_2220_5750Metric
C15, C16: 330u 63V; CP_Elec_10x10.5
C17: 100p; C_2220_5750Metric
C18: 6.8p; C_2220_5750Metric
C19: 3.3p; C_2220_5750Metric
C20, C21, C30, C31, C35, C36, C40, C41, C44, C47, C49, C50: 100n; C_0603_1608Metric
C22, C32, C33, C45, C46: 1u; C_0603_1608Metric
C34: 4.7u; C_0805_2012Metric
C37: 10n; C_0603_1608Metric
C38: 100u 100V; CP_Elec_10x10.5
C39: 1u 100V; C_1210_3225Metric
C42: 22u; C_1210_3225Metric
C43: 10u 50V; C_1210_3225Metric
C48: 4.7u; C_0603_1608Metric
D1: PIN; D_SMB
D2: Schottky; D_SOD-323
D3: 12V; D_SOD-323
D4: SMBJ58A; D_SMB
D5: SS16; D_SMA
D6: GRN; LED_0603_1608Metric
H1, H2, H3, H4: M3; MountingHole_3.2mm_M3_Pad
J1: TX_IN; SMA_Amphenol_132289_EdgeMount
J2: RX_OUT; SMA_Amphenol_132289_EdgeMount
J3: ANT; N_EdgeLaunch
J4: CAL; SMA_Amphenol_132289_EdgeMount
J5: BACKPLANE; PinHeader_2x08_P2.54mm_Vertical
J6: 50V IN; Molex_Mini-Fit_Jr_5566-02A_2x01_P4.20mm_Vertical
J7: SWD; PinHeader_1x04_P2.54mm_Vertical
L1, L9, L10: 390n; L_0603_1608Metric
L2: 220n; L_0805_2012Metric
L3: 120n; L_1210_3225Metric
L4: 18n; L_0805_2012Metric
L5: 56n; L_1210_3225Metric
L6: 47n; L_1812_4532Metric
L7: 8n; L_1812_4532Metric
L8: 100n; L_0603_1608Metric
L11: 22u; L_1210_3225Metric
Q1: GaN 10W; GaN_Flange_440166; MPN CG2H40010F class
Q2: GaN 300W; GaN_Flange_780; MPN UHF radar GaN, 300 W class
Q3: 2N7002; SOT-23
Q4: SUD50P10; TO-252-2
R1, R10: 33; R_0603_1608Metric
R3, R5: 292; R_0603_1608Metric
R4: 17.6; R_0603_1608Metric
R6: 22; R_0603_1608Metric
R7: 4.7; R_0603_1608Metric
R8: 10; R_0805_2012Metric
R9: 47; R_0603_1608Metric
R12, R14, R15, R17: 96; R_0603_1608Metric
R13, R16: 71; R_0603_1608Metric
R18, R21, R26, R33, R40, R41, R44, R46: 10k; R_0603_1608Metric
R19, R22: 12.4k; R_0603_1608Metric
R20, R23: 10; R_0603_1608Metric
R24, R25, R27, R28, R31, R32, R48: 100k; R_0603_1608Metric
R29: 82k; R_0603_1608Metric
R30: 20k; R_0603_1608Metric
R34: 100; R_0603_1608Metric
R35: 10k; R_1206_3216Metric
R36: 4.7k; R_0805_2012Metric
R37: 5m; R_2512_6332Metric
R38, R45: 1k; R_0603_1608Metric
R39: 180k; R_0603_1608Metric
R43: 56.2k; R_0603_1608Metric
TH1: 10k NTC; R_0603_1608Metric
U1: GB 20dB; SOT-89-3; MPN PHA-13LN+ class
U3: CIRC 400W; Circulator_DropIn_32mm
U4: -30dB; DirCoupler_SMD_12x6
U5: SPDT; SOT-363_SC-70-6
U6: DET FWD; SOT-23-6
U7: DET REV; SOT-23-6
U8: LNA; SOT-89-3
U9: BPF 420-450; BPF_SMD_5x5
U10: GB 20dB; SOT-89-3
U11: LM2776; SOT-23-6
U12, U13: DAC7311; SOT-363_SC-70-6
U14, U15: LM321; SOT-23-5
U16: LMV331; SOT-23-5
U17: 74LVC1G11; SOT-363_SC-70-6
U18: INA240A1; SOIC-8_3.9x4.9mm_P1.27mm
U19: LMR16006; SOT-23-6
U20: AP2112K-3.3; SOT-23-5
U21: STM32G031K8T6; LQFP-32_7x7mm_P0.8mm
U22: THVD1450; SOIC-8_3.9x4.9mm_P1.27mm

Connections:
+3V3: C30.1, C31.1, C35.1, C46.1, C47.1, C48.1, C50.1, J7.1, R26.1, R28.2, R29.1, R32.2, R41.1, R46.1, U5.6 (VDD), U12.4 (AVDD/AVREF), U13.4 (AVDD/AVREF), U16.5 (V+), U17.5 (VCC), U20.5 (VOUT), U21.4 (VDD), U22.8 (VCC)
+5V: C33.1, C36.1, C42.1, C45.1, L11.2, R1.1, R9.1, R10.1, R43.1, U6.3 (ENBL), U6.5 (VPOS), U7.3 (ENBL), U7.5 (VPOS), U11.3 (VIN), U11.4 (EN), U14.5 (V+), U15.5 (V+), U18.6 (V+), U20.1 (VIN), U20.3 (EN)
+12V: C43.1, C44.1, J5.1, J5.3, U19.4 (~SHDN), U19.5 (VIN)
-5V: C34.1, R24.2, R25.2, U11.1 (VOUT), U14.2 (V-), U15.2 (V-)
BIAS_OK: R26.2, U16.4, U17.3
BOOT: C41.1, U19.1 (CB)
CAL_PORT: C29.1, U5.3 (RF2)
CAL_SW: U5.4 (CTRL), U21.27 (PB3)
CFLY_N: C32.2, U11.6 (C1-)
CFLY_P: C32.1, U11.5 (C1+)
CPL_FWD: R12.1, R13.1, U4.3 (CPL)
CPL_REV: R15.1, R16.1, U4.4 (ISO)
DAC_CS_DRV: U13.1 (~SYNC), U21.22 (PA9/PA11)
DAC_CS_PA: U12.1 (~SYNC), U21.18 (PA8)
DAC_DIN: U12.3 (DIN), U13.3 (DIN), U21.14 (PA7)
DAC_SCLK: U12.2 (SCLK), U13.2 (SCLK), U21.12 (PA5)
DRAIN_EN_MCU: U17.6, U21.26 (PA15)
DRAIN_ON: R34.1, U17.4
FAULT_N: J5.11, R46.2, U21.29 (PB5)
FB_5V: R43.2, R44.1, U19.3 (FB)
GND: C6.2, C8.2, C10.2, C11.2, C13.2, C14.2, C15.2, C16.2, C18.2, C19.2, C20.2, C21.2, C22.2, C30.2, C31.2, C33.2, C34.2, C35.2, C36.2, C37.2, C38.2, C39.2, C40.2, C42.2, C43.2, C44.2, C45.2, C46.2, C47.2, C48.2, C49.2, C50.2, D1.1 (K), D2.1 (K), D4.1 (A1), D5.2 (A), D6.1 (K), H1.1, H2.1, H3.1, H4.1, J1.2 (Ext), J2.2 (Ext), J3.2 (Ext), J4.2 (Ext), J5.2, J5.4, J5.6, J5.8, J5.10, J5.12, J5.14, J5.16, J6.2, J7.4, L8.2, Q1.3 (S), Q2.3 (S), Q3.2 (S), R3.2, R5.2, R12.2, R14.2, R15.2, R17.2, R30.2, R33.2, R40.2, R44.2, R48.2, TH1.2, U1.2 (GND), U3.4 (GND), U4.5 (GND), U5.2 (GND), U6.2 (GND), U6.6 (GND), U7.2 (GND), U7.6 (GND), U8.2 (GND), U9.2 (GND), U10.2 (GND), U11.2 (GND), U12.5 (GND), U13.5 (GND), U14.1 (+), U15.1 (+), U16.2 (V-), U17.2 (GND), U18.2 (GND), U18.3 (REF2), U18.4 (GND), U18.7 (REF1), U19.2 (GND), U20.2 (GND), U21.5 (VSS), U22.5 (GND)
INV_DRV: R21.2, R22.1, U15.3 (-)
INV_PA: R18.2, R19.1, U14.3 (-)
I_DRAIN: C37.1, R38.2, U21.7 (PA0)
I_DRAIN_V: R38.1, U18.5
LED_A: D6.2 (A), R45.2
LED_DRV: R45.1, U21.28 (PB4)
NRST: C49.1, U21.6 (PF2)
NTC_V: C40.1, R41.2, TH1.1, U21.13 (PA6)
unnamed: C3.2, R3.1, R4.1
unnamed: C5.1, R4.2, R5.1
unnamed: C5.2, C6.1, L2.2, R7.1
unnamed: C9.2, C10.1, L4.1
unnamed: C17.2, C18.1, L7.1
unnamed: C28.1, R16.2, R17.1
unnamed: C23.2, C24.1, D2.2 (A)
unnamed: C1.1, J1.1 (In)
unnamed: C26.2, J2.1 (In)
unnamed: J3.1 (In), U4.2 (OUT)
unnamed: C29.2, J4.1 (In)
unnamed: L1.1, R1.2
unnamed: L2.1, R6.2
unnamed: L5.1, R8.2
unnamed: L9.1, R9.2
unnamed: L10.1, R10.2
unnamed: C8.1, C9.1, L3.2, Q1.2 (D)
unnamed: Q1.1 (G), R7.2
unnamed: C17.1, L6.2, Q2.2 (D)
unnamed: C11.1, L4.2, L5.2, Q2.1 (G)
unnamed: C1.2, U1.1 (RFIN)
unnamed: C3.1, L1.2, U1.3 (RFOUT)
unnamed: C19.1, L7.2, U3.1
unnamed: U3.2, U4.1 (IN)
unnamed: C27.1, U5.1 (RF1)
unnamed: R13.2, R14.1, U5.5 (RFC)
unnamed: C27.2, U6.1 (RFIN)
unnamed: C28.2, U7.1 (RFIN)
unnamed: C24.2, U8.1 (RFIN)
unnamed: C25.1, L9.2, U8.3 (RFOUT)
unnamed: C25.2, U9.1 (IN)
unnamed: U9.3 (OUT), U10.1 (RFIN)
unnamed: C26.1, L10.2, U10.3 (RFOUT)
PFET_G: D3.2 (A), Q4.1 (G), R35.1, R36.2
PFET_PULL: Q3.3 (D), R35.2
Q3_G: Q3.1 (G), R34.2, R48.1
RS485_A: J5.5, U22.6 (A)
RS485_B: J5.7, U22.7 (B)
RS485_DE: U21.23 (PA10/PA12), U22.2 (~RE), U22.3 (DE)
RS485_DI: U21.9 (PA2), U22.4 (DI)
RS485_RO: U21.10 (PA3), U22.1 (RO)
RX_CIRC: C23.1, D1.2 (A), L8.1, U3.3
SWCLK: J7.3, U21.25 (PA14)
SWDIO: J7.2, U21.24 (PA13)
SW_5V: C41.2, D5.1 (K), L11.1, U19.6 (SW)
TX_EN: J5.9, R33.1, U17.1, U21.30 (PB6)
VDAC_DRV: R21.1, U13.6 (VOUT)
VDAC_PA: R18.1, U12.6 (VOUT)
VDD50_MON: R39.2, R40.1, U21.16 (PB1)
VDD_50V: C38.1, C39.1, D4.2 (A2), J6.1, R37.1, R39.1, U18.8 (+)
VDD_50V_S: D3.1 (K), Q4.3 (S), R36.1, R37.2, U18.1 (-)
VD_SW: C13.1, C14.1, C15.1, C16.1, L3.1, L6.1, Q4.2 (D)
VGD_MON: R31.2, R32.1, U21.17 (PB2)
VG_DRV: C21.1, R6.1, R23.2, R25.1, R31.1
VG_DRV_OP: R22.2, R23.1, U15.4
VG_MON: R27.2, R28.1, U16.3 (-), U21.15 (PB0)
VG_PA: C20.1, C22.1, R8.1, R20.2, R24.1, R27.1
VG_PA_OP: R19.2, R20.1, U14.4
VREF_BOK: R29.2, R30.1, U16.1 (+)
V_FWD: U6.4 (VOUT), U21.8 (PA1)
V_REFL: U7.4 (VOUT), U21.11 (PA4)

Notes on the sheet:
TX CHAIN - 0 dBm in, 300 W (+54.8 dBm) peak out, 20 % max duty
RX CHAIN - limiter protected, NF 1.1 dB, G 34 dB
POWER MONITOR AND CALIBRATION PORT
DRAIN SUPPLY - 50 V, 10 A peak, pulsed drain switch + current sense
Drain switch: Vgs = -12 V (clamped), t_on ~ 25 us, t_off ~ 80 us.
POWER - 12 V aux in, 5 V buck, 3.3 V LDO, -5 V inverter
GATE BIAS - VG = -1.25 x VDAC (-1.0 ... -4.1 V), fail-safe pinch-off
SEQUENCING INTERLOCK AND MONITORS
MODULE CONTROLLER - STM32G031, RS-485 to tile, SWD
MOUNTING / COLD PLATE
NOTES
1. Matching values are first-pass from transistor large-signal models; tune at 435 MHz on load-pull bench.
2. Q2 and U3 mount through board cutouts onto the copper cold plate (liquid cooled, 45 W avg per module).
3. RF lines: 50 ohm microstrip, 1.70 mm on RO4350B 0.762 mm (L1-L2). Output path >= 3 mm wide.
4. TX_EN is the only path that can turn the drain on; MCU and BIAS_OK can veto it in hardware.
5. Module power: 155 W avg RF per module x 2,587 per face; see radar_sizing.py for the system budget.

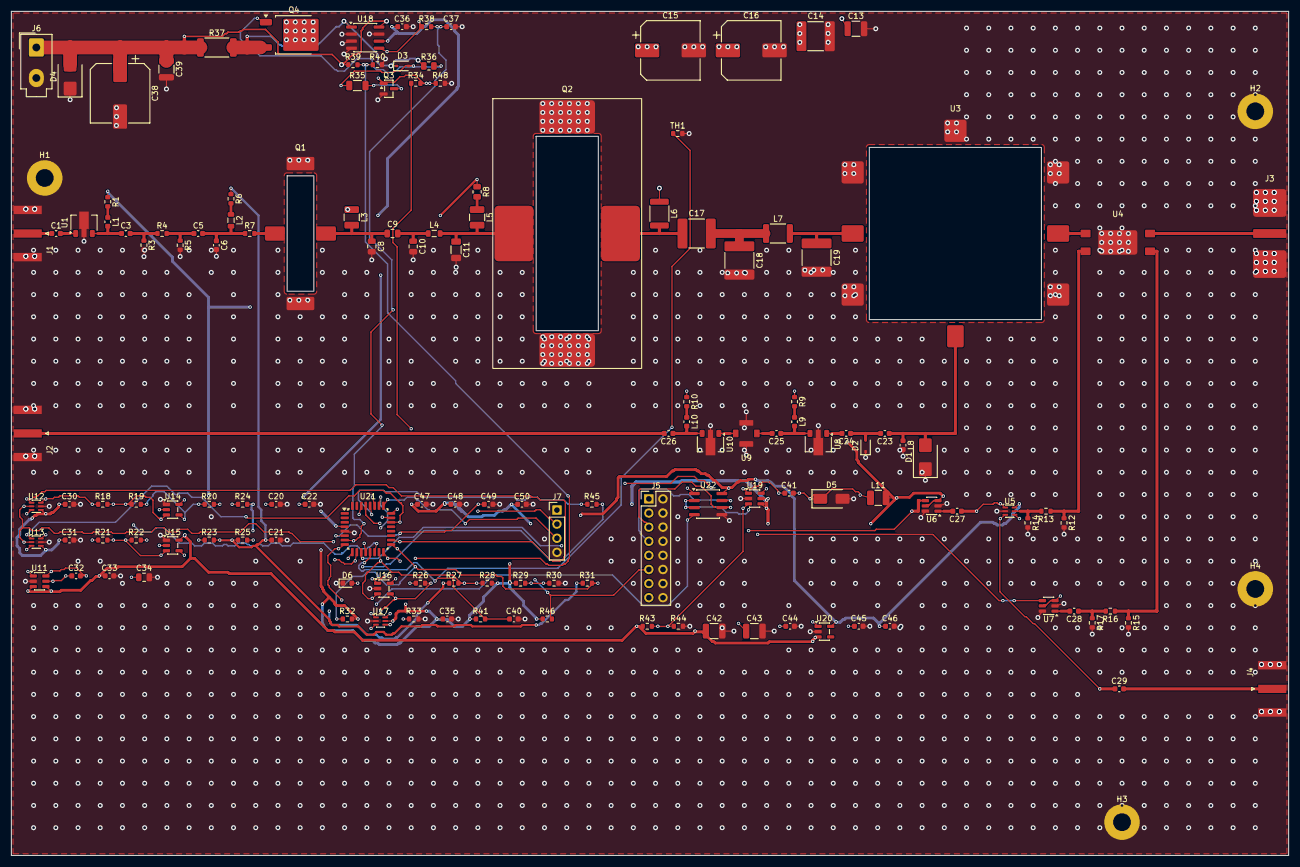
[picture p48: board SENTINEL_TRM.kicad_pcb from above]

Board: 4 copper layers, 230.0 x 152.0 mm, 144 parts (0 on the bottom side), 90 nets.
