ajisrawi/sentinel-uhf-radar/hardware/rfsoc_tile/SENTINEL_TILE.kicad_pcb

## KiCad design hardware/rfsoc_tile/SENTINEL_TILE.kicad_pcb (2026-10-20)

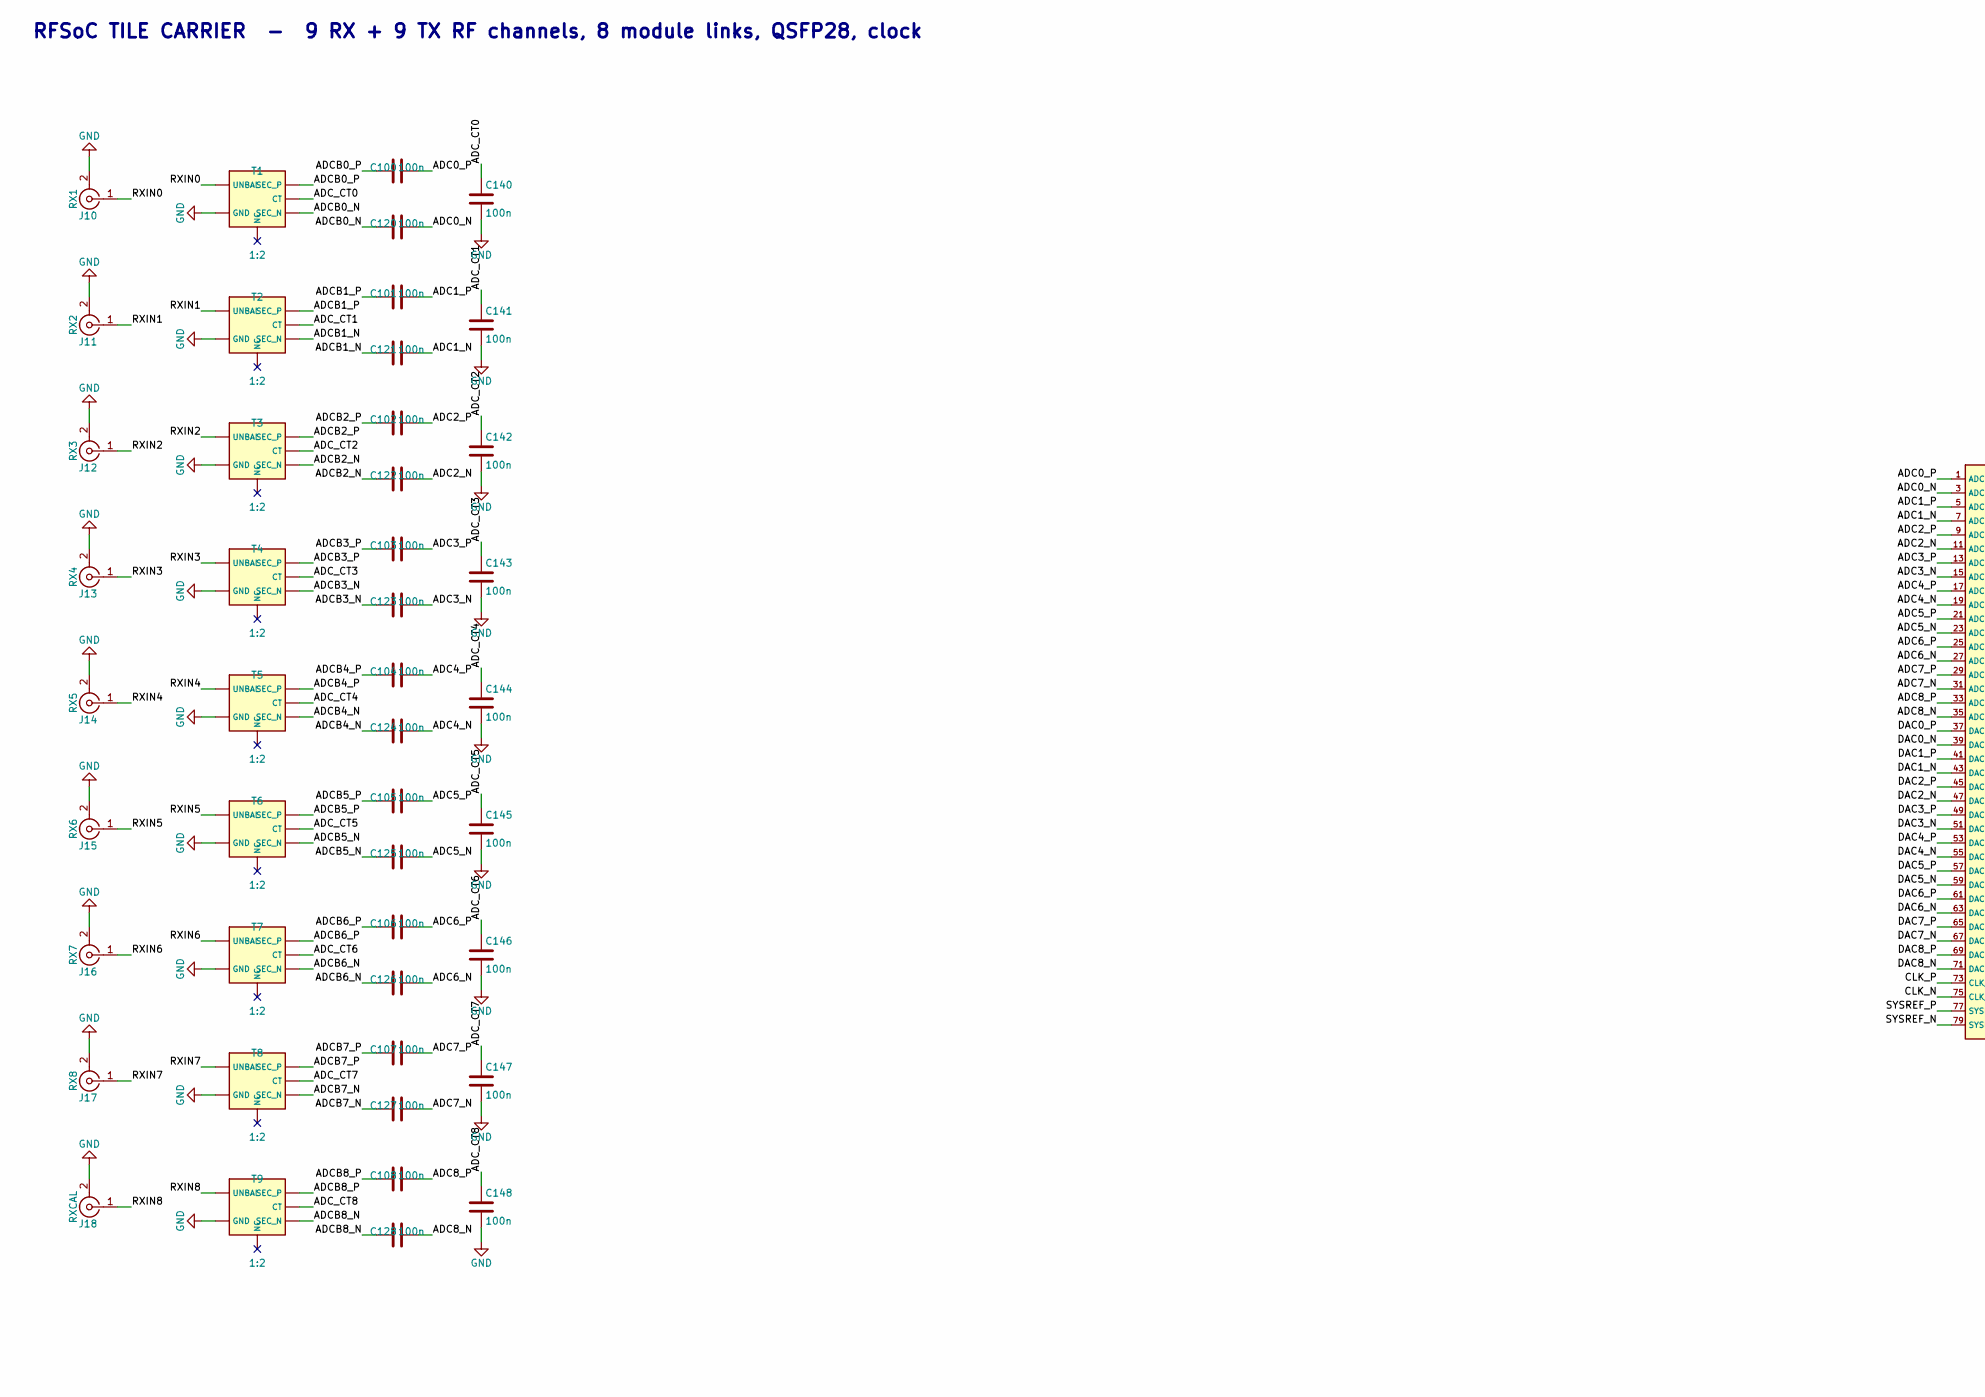
[picture p49: schematic SENTINEL_TILE.kicad_sch, SENTINEL-UHF RFSoC Digitiser Tile (SOM carrier), part in row 1, column 1]

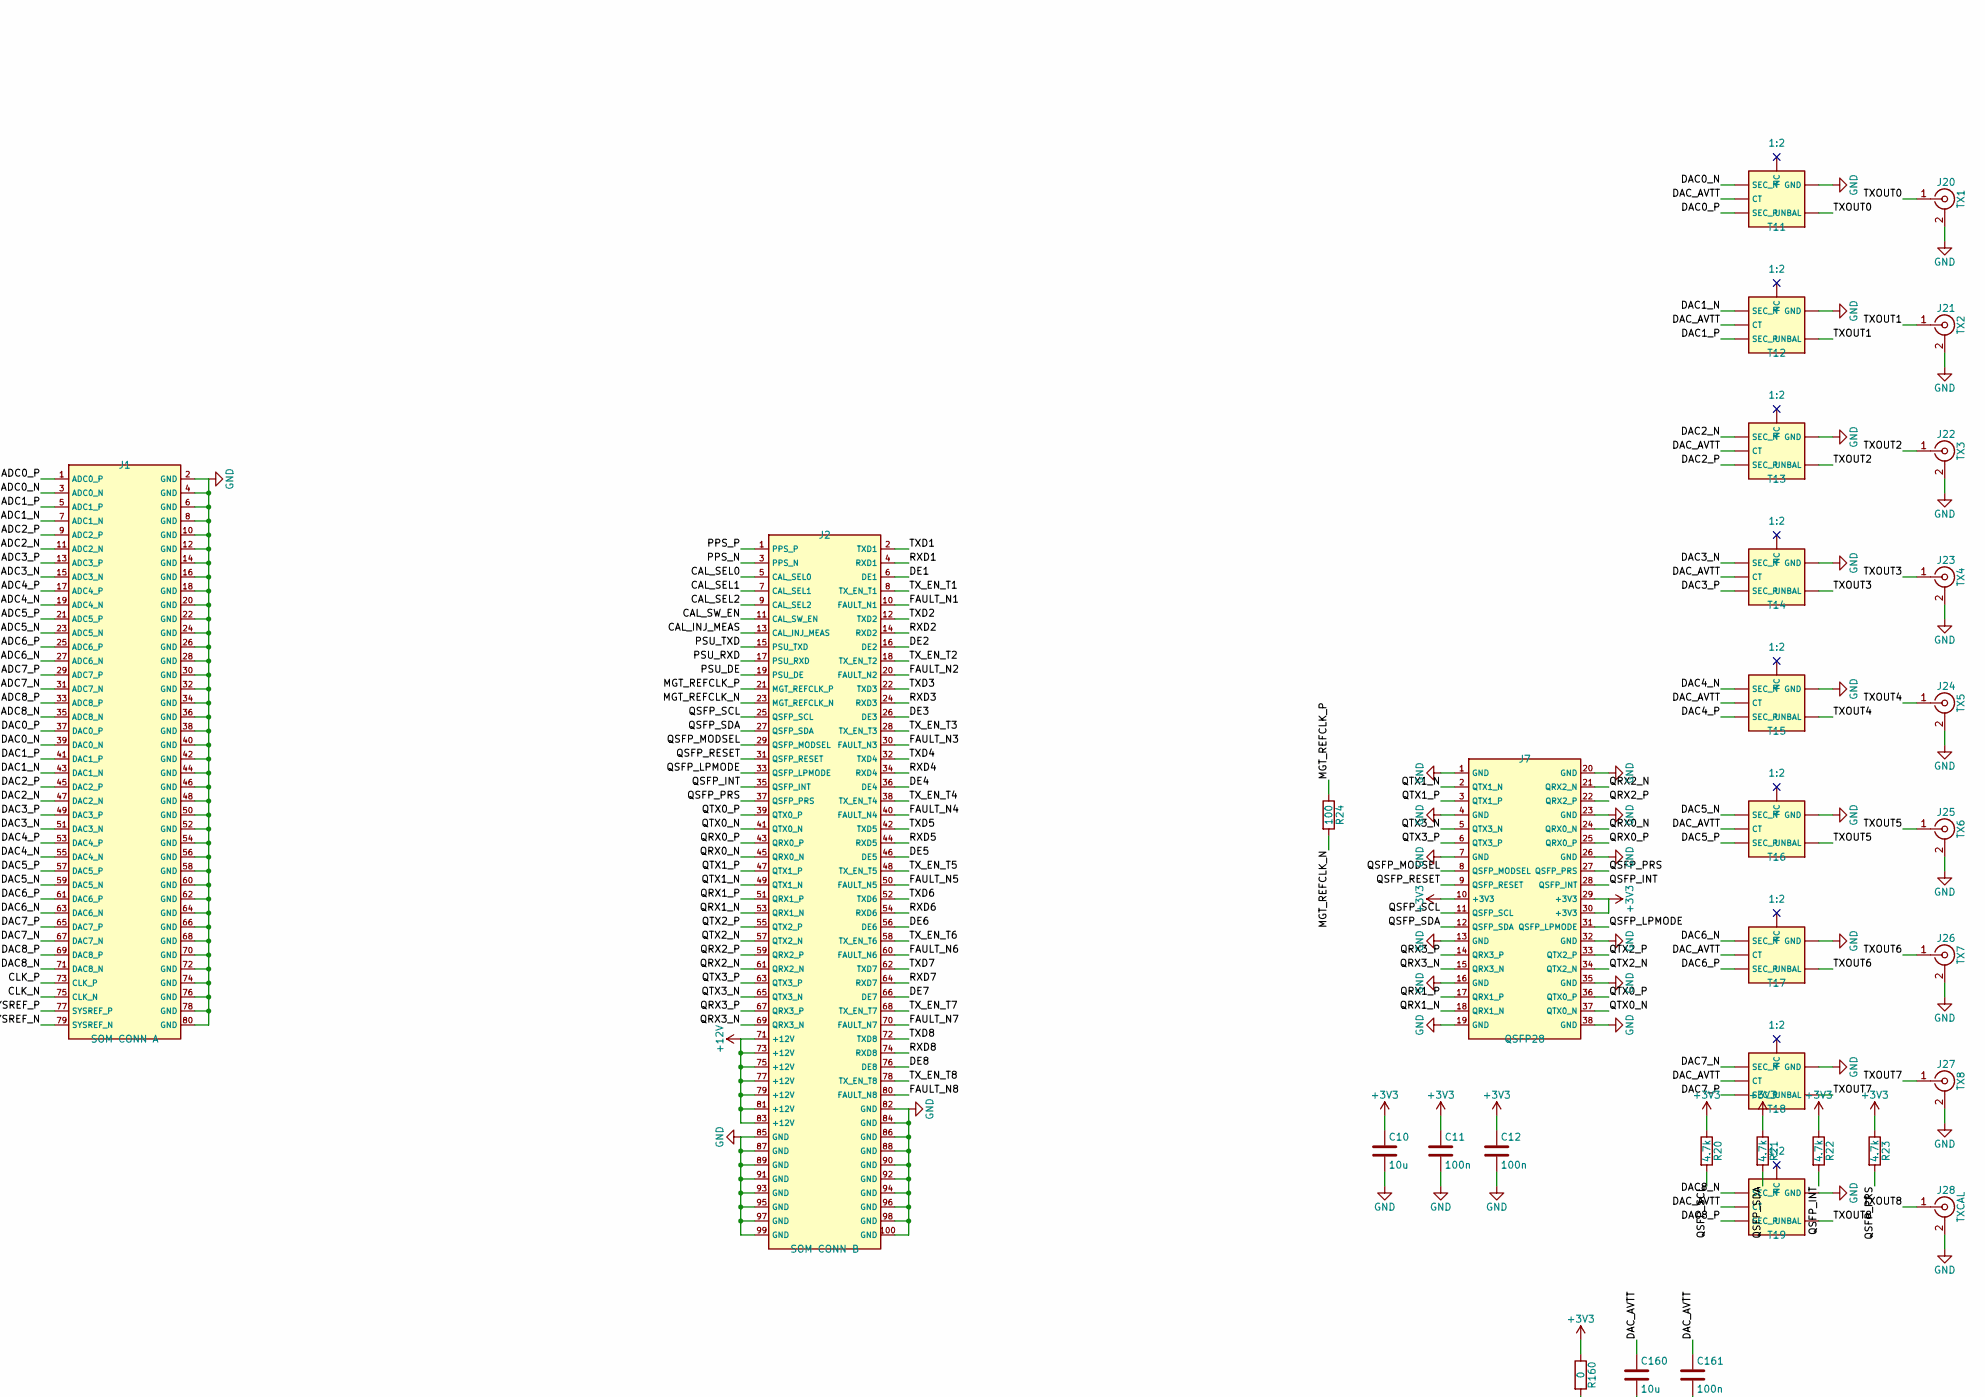
[picture p50: schematic SENTINEL_TILE.kicad_sch, SENTINEL-UHF RFSoC Digitiser Tile (SOM carrier), part in row 1, column 2]

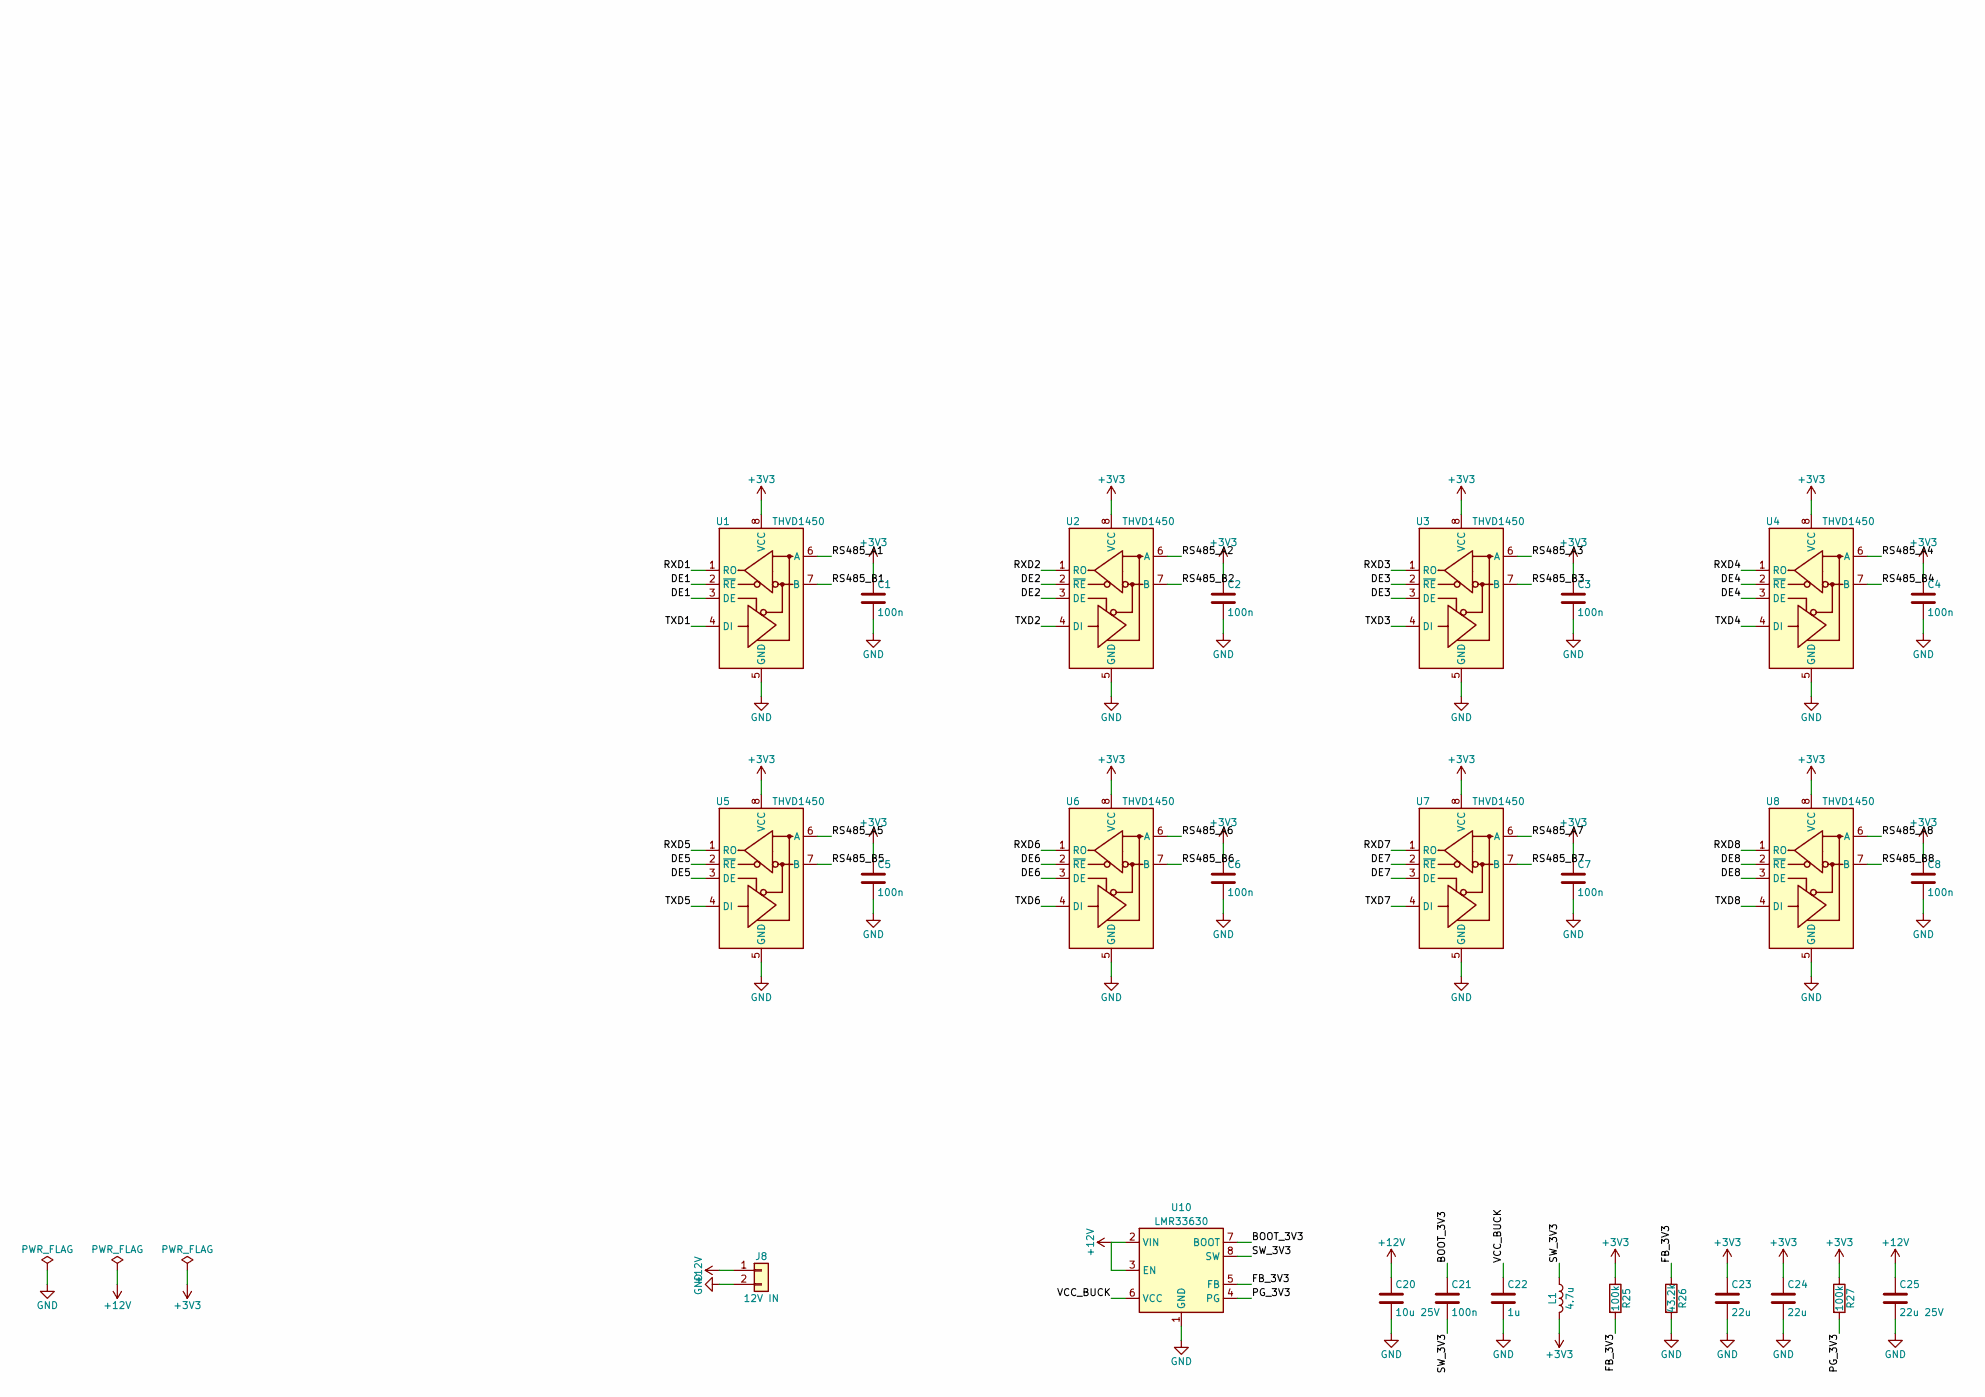
[picture p51: schematic SENTINEL_TILE.kicad_sch, SENTINEL-UHF RFSoC Digitiser Tile (SOM carrier), part in row 2, column 1]

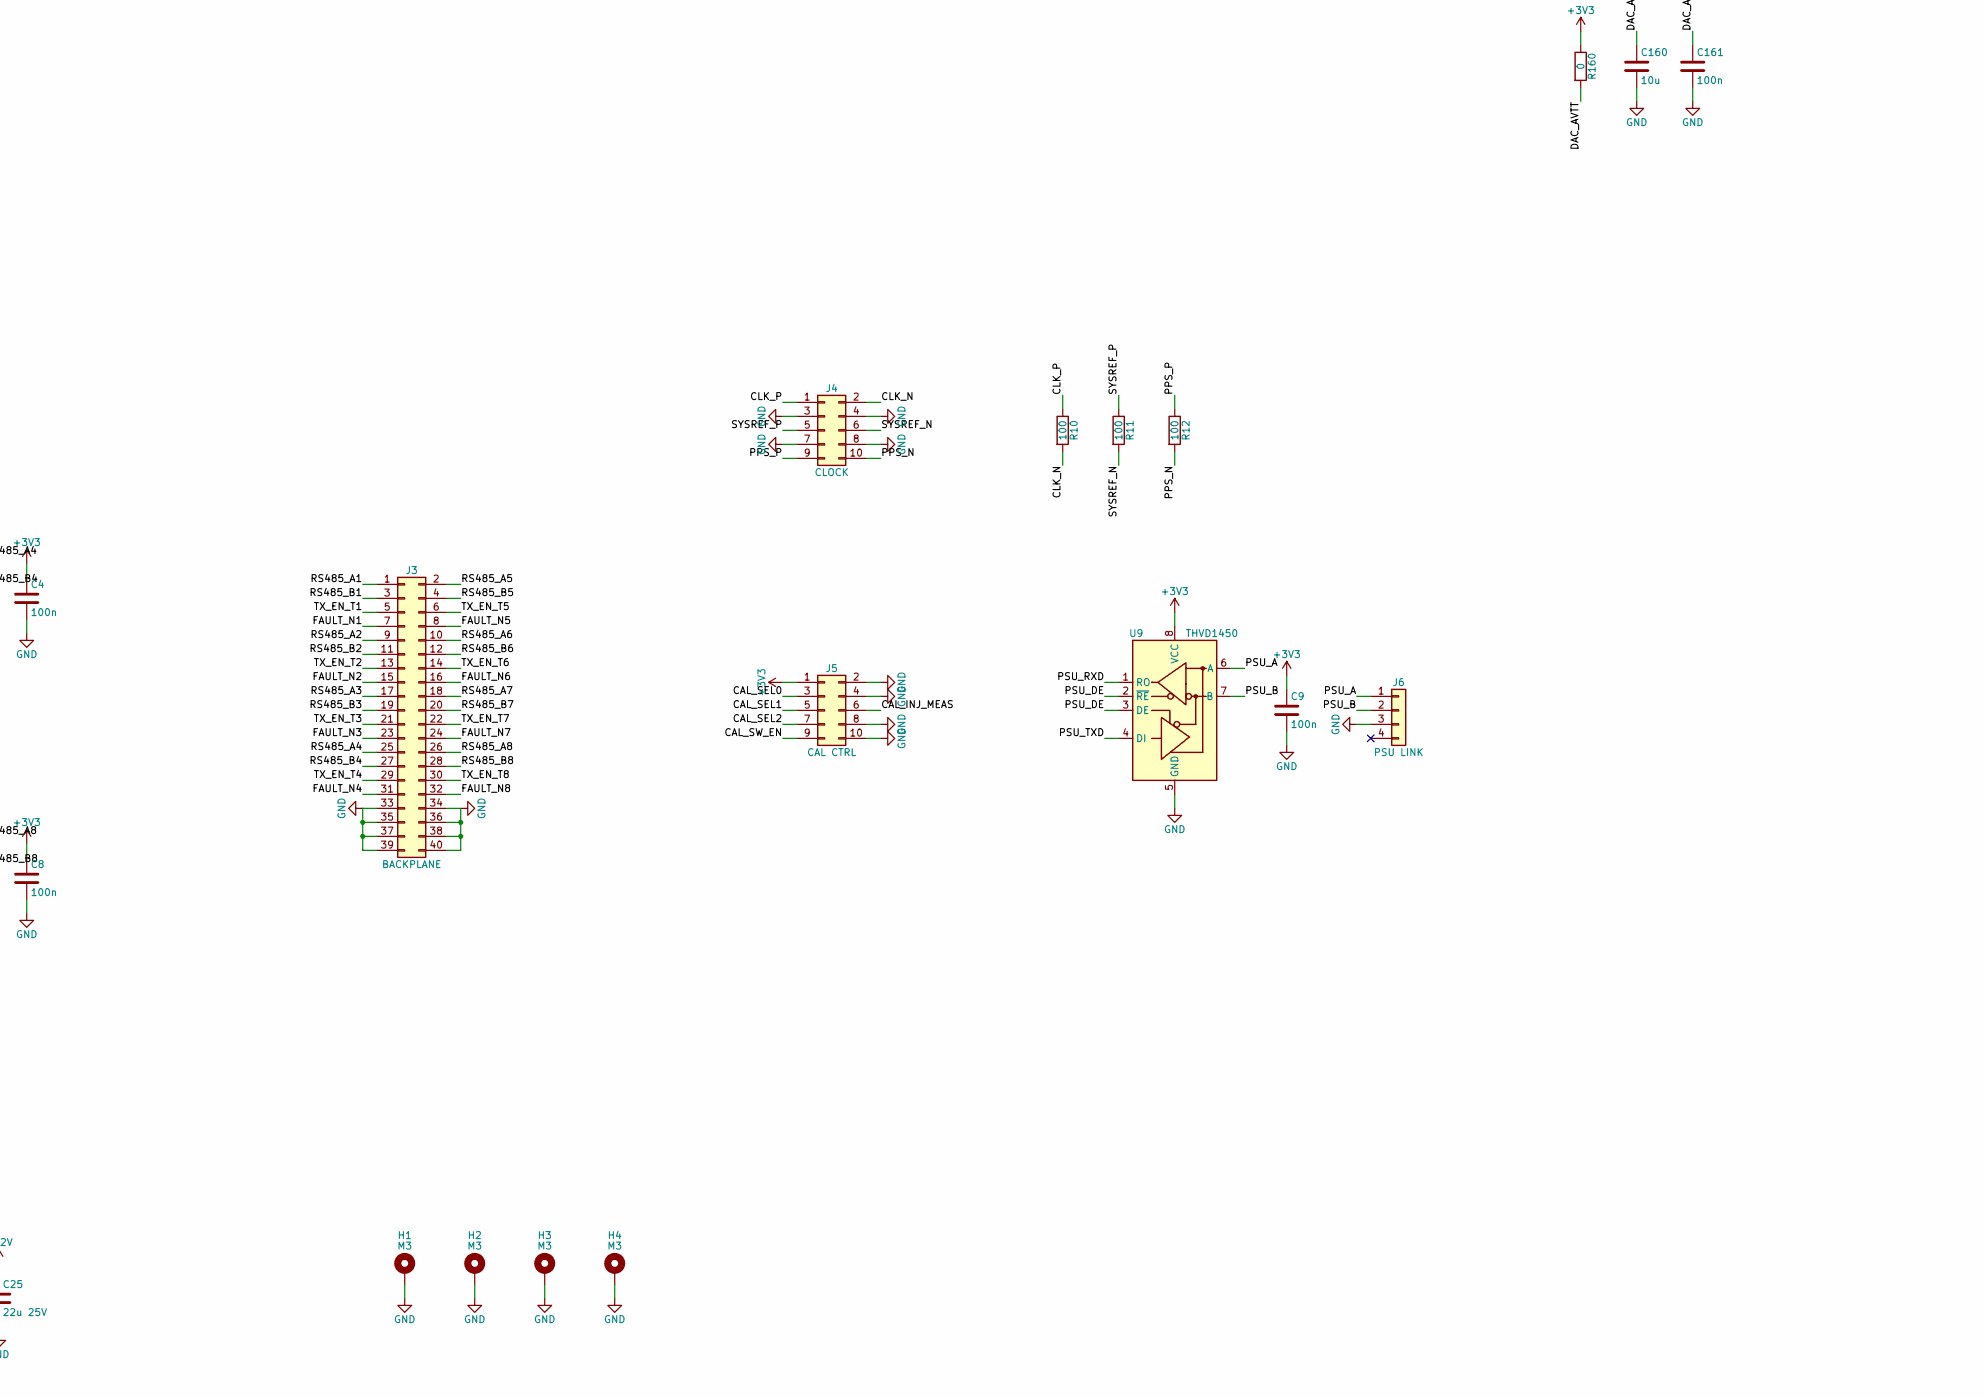
[picture p52: schematic SENTINEL_TILE.kicad_sch, SENTINEL-UHF RFSoC Digitiser Tile (SOM carrier), part in row 2, column 2]

Parts:
C1, C2, C3, C4, C5, C6, C7, C8, C9, C11, C12, C21, C100, C101, C102, C103, C104, C105, C106, C107, C108, C120, C121, C122, C123, C124, C125, C126, C127, C128, C140, C141, C142, C143, C144, C145, C146, C147, C148, C161: 100n; C_0603_1608Metric
C10, C160: 10u; C_1210_3225Metric
C20: 10u 25V; C_1210_3225Metric
C22: 1u; C_0603_1608Metric
C23, C24: 22u; C_1210_3225Metric
C25: 22u 25V; C_1210_3225Metric
H1, H2, H3, H4: M3; MountingHole_3.2mm_M3_Pad
J1: SOM CONN A; SOM_B2B_2x40_P0.8
J2: SOM CONN B; SOM_B2B_2x50_P0.8
J3: BACKPLANE; PinHeader_2x20_P2.54mm_Vertical
J4: CLOCK; PinHeader_2x05_P2.54mm_Vertical
J5: CAL CTRL; PinHeader_2x05_P2.54mm_Vertical
J6: PSU LINK; PinHeader_1x04_P2.54mm_Vertical
J7: QSFP28; QSFP28_Host_38P
J8: 12V IN; Molex_Mini-Fit_Jr_5566-02A_2x01_P4.20mm_Vertical
J10: RX1; SMA_Amphenol_132289_EdgeMount
J11: RX2; SMA_Amphenol_132289_EdgeMount
J12: RX3; SMA_Amphenol_132289_EdgeMount
J13: RX4; SMA_Amphenol_132289_EdgeMount
J14: RX5; SMA_Amphenol_132289_EdgeMount
J15: RX6; SMA_Amphenol_132289_EdgeMount
J16: RX7; SMA_Amphenol_132289_EdgeMount
J17: RX8; SMA_Amphenol_132289_EdgeMount
J18: RXCAL; SMA_Amphenol_132289_EdgeMount
J20: TX1; SMA_Amphenol_132289_EdgeMount
J21: TX2; SMA_Amphenol_132289_EdgeMount
J22: TX3; SMA_Amphenol_132289_EdgeMount
J23: TX4; SMA_Amphenol_132289_EdgeMount
J24: TX5; SMA_Amphenol_132289_EdgeMount
J25: TX6; SMA_Amphenol_132289_EdgeMount
J26: TX7; SMA_Amphenol_132289_EdgeMount
J27: TX8; SMA_Amphenol_132289_EdgeMount
J28: TXCAL; SMA_Amphenol_132289_EdgeMount
L1: 4.7u; L_1210_3225Metric
R10, R11, R12, R24: 100; R_0603_1608Metric
R20, R21, R22, R23: 4.7k; R_0603_1608Metric
R25, R27: 100k; R_0603_1608Metric
R26: 43.2k; R_0603_1608Metric
R160: 0; R_0805_2012Metric
T1, T2, T3, T4, T5, T6, T7, T8, T9, T11, T12, T13, T14, T15, T16, T17, T18, T19: 1:2; Balun_SMD_6P_3.8x3.8
U1, U2, U3, U4, U5, U6, U7, U8, U9: THVD1450; SOIC-8_3.9x4.9mm_P1.27mm
U10: LMR33630; Texas_HSOP-8-1EP_3.9x4.9mm_P1.27mm_ThermalVias

Connections:
+3V3: C1.1, C2.1, C3.1, C4.1, C5.1, C6.1, C7.1, C8.1, C9.1, C10.1, C11.1, C12.1, C23.1, C24.1, J5.1, J7.10 (+3V3), J7.29 (+3V3), J7.30 (+3V3), L1.2, R20.1, R21.1, R22.1, R23.1, R25.1, R27.1, R160.1, U1.8 (VCC), U2.8 (VCC), U3.8 (VCC), U4.8 (VCC), U5.8 (VCC), U6.8 (VCC), U7.8 (VCC), U8.8 (VCC), U9.8 (VCC)
+12V: C20.1, C25.1, J2.71 (+12V), J2.73 (+12V), J2.75 (+12V), J2.77 (+12V), J2.79 (+12V), J2.81 (+12V), J2.83 (+12V), J8.1, U10.2 (VIN), U10.3 (EN)
ADC0_N: C120.2, J1.3 (ADC0_N)
ADC0_P: C100.2, J1.1 (ADC0_P)
ADC1_N: C121.2, J1.7 (ADC1_N)
ADC1_P: C101.2, J1.5 (ADC1_P)
ADC2_N: C122.2, J1.11 (ADC2_N)
ADC2_P: C102.2, J1.9 (ADC2_P)
ADC3_N: C123.2, J1.15 (ADC3_N)
ADC3_P: C103.2, J1.13 (ADC3_P)
ADC4_N: C124.2, J1.19 (ADC4_N)
ADC4_P: C104.2, J1.17 (ADC4_P)
ADC5_N: C125.2, J1.23 (ADC5_N)
ADC5_P: C105.2, J1.21 (ADC5_P)
ADC6_N: C126.2, J1.27 (ADC6_N)
ADC6_P: C106.2, J1.25 (ADC6_P)
ADC7_N: C127.2, J1.31 (ADC7_N)
ADC7_P: C107.2, J1.29 (ADC7_P)
ADC8_N: C128.2, J1.35 (ADC8_N)
ADC8_P: C108.2, J1.33 (ADC8_P)
ADCB0_N: C120.1, T1.4 (SEC_N)
ADCB0_P: C100.1, T1.3 (SEC_P)
ADCB1_N: C121.1, T2.4 (SEC_N)
ADCB1_P: C101.1, T2.3 (SEC_P)
ADCB2_N: C122.1, T3.4 (SEC_N)
ADCB2_P: C102.1, T3.3 (SEC_P)
ADCB3_N: C123.1, T4.4 (SEC_N)
ADCB3_P: C103.1, T4.3 (SEC_P)
ADCB4_N: C124.1, T5.4 (SEC_N)
ADCB4_P: C104.1, T5.3 (SEC_P)
ADCB5_N: C125.1, T6.4 (SEC_N)
ADCB5_P: C105.1, T6.3 (SEC_P)
ADCB6_N: C126.1, T7.4 (SEC_N)
ADCB6_P: C106.1, T7.3 (SEC_P)
ADCB7_N: C127.1, T8.4 (SEC_N)
ADCB7_P: C107.1, T8.3 (SEC_P)
ADCB8_N: C128.1, T9.4 (SEC_N)
ADCB8_P: C108.1, T9.3 (SEC_P)
ADC_CT0: C140.1, T1.5 (CT)
ADC_CT1: C141.1, T2.5 (CT)
ADC_CT2: C142.1, T3.5 (CT)
ADC_CT3: C143.1, T4.5 (CT)
ADC_CT4: C144.1, T5.5 (CT)
ADC_CT5: C145.1, T6.5 (CT)
ADC_CT6: C146.1, T7.5 (CT)
ADC_CT7: C147.1, T8.5 (CT)
ADC_CT8: C148.1, T9.5 (CT)
BOOT_3V3: C21.1, U10.7 (BOOT)
CAL_INJ_MEAS: J2.13 (CAL_INJ_MEAS), J5.6
CAL_SEL0: J2.5 (CAL_SEL0), J5.3
CAL_SEL1: J2.7 (CAL_SEL1), J5.5
CAL_SEL2: J2.9 (CAL_SEL2), J5.7
CAL_SW_EN: J2.11 (CAL_SW_EN), J5.9
CLK_N: J1.75 (CLK_N), J4.2, R10.2
CLK_P: J1.73 (CLK_P), J4.1, R10.1
DAC0_N: J1.39 (DAC0_N), T11.4 (SEC_N)
DAC0_P: J1.37 (DAC0_P), T11.3 (SEC_P)
DAC1_N: J1.43 (DAC1_N), T12.4 (SEC_N)
DAC1_P: J1.41 (DAC1_P), T12.3 (SEC_P)
DAC2_N: J1.47 (DAC2_N), T13.4 (SEC_N)
DAC2_P: J1.45 (DAC2_P), T13.3 (SEC_P)
DAC3_N: J1.51 (DAC3_N), T14.4 (SEC_N)
DAC3_P: J1.49 (DAC3_P), T14.3 (SEC_P)
DAC4_N: J1.55 (DAC4_N), T15.4 (SEC_N)
DAC4_P: J1.53 (DAC4_P), T15.3 (SEC_P)
DAC5_N: J1.59 (DAC5_N), T16.4 (SEC_N)
DAC5_P: J1.57 (DAC5_P), T16.3 (SEC_P)
DAC6_N: J1.63 (DAC6_N), T17.4 (SEC_N)
DAC6_P: J1.61 (DAC6_P), T17.3 (SEC_P)
DAC7_N: J1.67 (DAC7_N), T18.4 (SEC_N)
DAC7_P: J1.65 (DAC7_P), T18.3 (SEC_P)
DAC8_N: J1.71 (DAC8_N), T19.4 (SEC_N)
DAC8_P: J1.69 (DAC8_P), T19.3 (SEC_P)
DAC_AVTT: C160.1, C161.1, R160.2, T11.5 (CT), T12.5 (CT), T13.5 (CT), T14.5 (CT), T15.5 (CT), T16.5 (CT), T17.5 (CT), T18.5 (CT), T19.5 (CT)
DE1: J2.6 (DE1), U1.2 (~RE), U1.3 (DE)
DE2: J2.16 (DE2), U2.2 (~RE), U2.3 (DE)
DE3: J2.26 (DE3), U3.2 (~RE), U3.3 (DE)
DE4: J2.36 (DE4), U4.2 (~RE), U4.3 (DE)
DE5: J2.46 (DE5), U5.2 (~RE), U5.3 (DE)
DE6: J2.56 (DE6), U6.2 (~RE), U6.3 (DE)
DE7: J2.66 (DE7), U7.2 (~RE), U7.3 (DE)
DE8: J2.76 (DE8), U8.2 (~RE), U8.3 (DE)
FAULT_N1: J2.10 (FAULT_N1), J3.7
FAULT_N2: J2.20 (FAULT_N2), J3.15
FAULT_N3: J2.30 (FAULT_N3), J3.23
FAULT_N4: J2.40 (FAULT_N4), J3.31
FAULT_N5: J2.50 (FAULT_N5), J3.8
FAULT_N6: J2.60 (FAULT_N6), J3.16
FAULT_N7: J2.70 (FAULT_N7), J3.24
FAULT_N8: J2.80 (FAULT_N8), J3.32
FB_3V3: R25.2, R26.1, U10.5 (FB)
GND: C1.2, C2.2, C3.2, C4.2, C5.2, C6.2, C7.2, C8.2, C9.2, C10.2, C11.2, C12.2, C20.2, C22.2, C23.2, C24.2, C25.2, C140.2, C141.2, C142.2, C143.2, C144.2, C145.2, C146.2, C147.2, C148.2, C160.2, C161.2, H1.1, H2.1, H3.1, H4.1, J1.2 (GND), J1.4 (GND), J1.6 (GND), J1.8 (GND), J1.10 (GND), J1.12 (GND), J1.14 (GND), J1.16 (GND), J1.18 (GND), J1.20 (GND), J1.22 (GND), J1.24 (GND), J1.26 (GND), J1.28 (GND), J1.30 (GND), J1.32 (GND), J1.34 (GND), J1.36 (GND), J1.38 (GND), J1.40 (GND), J1.42 (GND), J1.44 (GND), J1.46 (GND), J1.48 (GND), J1.50 (GND), J1.52 (GND), J1.54 (GND), J1.56 (GND), J1.58 (GND), J1.60 (GND), J1.62 (GND), J1.64 (GND), J1.66 (GND), J1.68 (GND), J1.70 (GND), J1.72 (GND), J1.74 (GND), J1.76 (GND), J1.78 (GND), J1.80 (GND), J2.82 (GND), J2.84 (GND), J2.85 (GND), J2.86 (GND), J2.87 (GND), J2.88 (GND), J2.89 (GND), J2.90 (GND), J2.91 (GND), J2.92 (GND), J2.93 (GND), J2.94 (GND), J2.95 (GND), J2.96 (GND), J2.97 (GND), J2.98 (GND), J2.99 (GND), J2.100 (GND), J3.33, J3.34, J3.35, J3.36, J3.37, J3.38, J3.39, J3.40, J4.3, J4.4, J4.7, J4.8, J5.2, J5.4, J5.8, J5.10, J6.3, J7.1 (GND), J7.4 (GND), J7.7 (GND), J7.13 (GND), J7.16 (GND), J7.19 (GND), J7.20 (GND), J7.23 (GND), J7.26 (GND), J7.32 (GND), J7.35 (GND), J7.38 (GND), J8.2, J10.2 (Ext), J11.2 (Ext), J12.2 (Ext), J13.2 (Ext), J14.2 (Ext), J15.2 (Ext), J16.2 (Ext), J17.2 (Ext), J18.2 (Ext), J20.2 (Ext), J21.2 (Ext), J22.2 (Ext), J23.2 (Ext), J24.2 (Ext), J25.2 (Ext), J26.2 (Ext), J27.2 (Ext), J28.2 (Ext), R26.2, T1.2 (GND), T2.2 (GND), T3.2 (GND), T4.2 (GND), T5.2 (GND), T6.2 (GND), T7.2 (GND), T8.2 (GND), T9.2 (GND), T11.2 (GND), T12.2 (GND), T13.2 (GND), T14.2 (GND), T15.2 (GND), T16.2 (GND), T17.2 (GND), T18.2 (GND), T19.2 (GND), U1.5 (GND), U2.5 (GND), U3.5 (GND), U4.5 (GND), U5.5 (GND), U6.5 (GND), U7.5 (GND), U8.5 (GND), U9.5 (GND), U10.1 (GND), U10.9 (GND)
MGT_REFCLK_N: J2.23 (MGT_REFCLK_N), R24.2
MGT_REFCLK_P: J2.21 (MGT_REFCLK_P), R24.1
PG_3V3: R27.2, U10.4 (PG)
PPS_N: J2.3 (PPS_N), J4.10, R12.2
PPS_P: J2.1 (PPS_P), J4.9, R12.1
PSU_A: J6.1, U9.6 (A)
PSU_B: J6.2, U9.7 (B)
PSU_DE: J2.19 (PSU_DE), U9.2 (~RE), U9.3 (DE)
PSU_RXD: J2.17 (PSU_RXD), U9.1 (RO)
PSU_TXD: J2.15 (PSU_TXD), U9.4 (DI)
QRX0_N: J2.45 (QRX0_N), J7.24 (QRX0_N)
QRX0_P: J2.43 (QRX0_P), J7.25 (QRX0_P)
QRX1_N: J2.53 (QRX1_N), J7.18 (QRX1_N)
QRX1_P: J2.51 (QRX1_P), J7.17 (QRX1_P)
QRX2_N: J2.61 (QRX2_N), J7.21 (QRX2_N)
QRX2_P: J2.59 (QRX2_P), J7.22 (QRX2_P)
QRX3_N: J2.69 (QRX3_N), J7.15 (QRX3_N)
QRX3_P: J2.67 (QRX3_P), J7.14 (QRX3_P)
QSFP_INT: J2.35 (QSFP_INT), J7.28 (QSFP_INT), R22.2
QSFP_LPMODE: J2.33 (QSFP_LPMODE), J7.31 (QSFP_LPMODE)
QSFP_MODSEL: J2.29 (QSFP_MODSEL), J7.8 (QSFP_MODSEL)
QSFP_PRS: J2.37 (QSFP_PRS), J7.27 (QSFP_PRS), R23.2
QSFP_RESET: J2.31 (QSFP_RESET), J7.9 (QSFP_RESET)
QSFP_SCL: J2.25 (QSFP_SCL), J7.11 (QSFP_SCL), R20.2
QSFP_SDA: J2.27 (QSFP_SDA), J7.12 (QSFP_SDA), R21.2
QTX0_N: J2.41 (QTX0_N), J7.37 (QTX0_N)
QTX0_P: J2.39 (QTX0_P), J7.36 (QTX0_P)
QTX1_N: J2.49 (QTX1_N), J7.2 (QTX1_N)
QTX1_P: J2.47 (QTX1_P), J7.3 (QTX1_P)
QTX2_N: J2.57 (QTX2_N), J7.34 (QTX2_N)
QTX2_P: J2.55 (QTX2_P), J7.33 (QTX2_P)
QTX3_N: J2.65 (QTX3_N), J7.5 (QTX3_N)
QTX3_P: J2.63 (QTX3_P), J7.6 (QTX3_P)
RS485_A1: J3.1, U1.6 (A)
RS485_A2: J3.9, U2.6 (A)
RS485_A3: J3.17, U3.6 (A)
RS485_A4: J3.25, U4.6 (A)
RS485_A5: J3.2, U5.6 (A)
RS485_A6: J3.10, U6.6 (A)
RS485_A7: J3.18, U7.6 (A)
RS485_A8: J3.26, U8.6 (A)
RS485_B1: J3.3, U1.7 (B)
RS485_B2: J3.11, U2.7 (B)
RS485_B3: J3.19, U3.7 (B)
RS485_B4: J3.27, U4.7 (B)
RS485_B5: J3.4, U5.7 (B)
RS485_B6: J3.12, U6.7 (B)
RS485_B7: J3.20, U7.7 (B)
RS485_B8: J3.28, U8.7 (B)
RXD1: J2.4 (RXD1), U1.1 (RO)
RXD2: J2.14 (RXD2), U2.1 (RO)
RXD3: J2.24 (RXD3), U3.1 (RO)
RXD4: J2.34 (RXD4), U4.1 (RO)
RXD5: J2.44 (RXD5), U5.1 (RO)
RXD6: J2.54 (RXD6), U6.1 (RO)
RXD7: J2.64 (RXD7), U7.1 (RO)
RXD8: J2.74 (RXD8), U8.1 (RO)
RXIN0: J10.1 (In), T1.1 (UNBAL)
RXIN1: J11.1 (In), T2.1 (UNBAL)
RXIN2: J12.1 (In), T3.1 (UNBAL)
RXIN3: J13.1 (In), T4.1 (UNBAL)
RXIN4: J14.1 (In), T5.1 (UNBAL)
RXIN5: J15.1 (In), T6.1 (UNBAL)
RXIN6: J16.1 (In), T7.1 (UNBAL)
RXIN7: J17.1 (In), T8.1 (UNBAL)
RXIN8: J18.1 (In), T9.1 (UNBAL)
SW_3V3: C21.2, L1.1, U10.8 (SW)
SYSREF_N: J1.79 (SYSREF_N), J4.6, R11.2
SYSREF_P: J1.77 (SYSREF_P), J4.5, R11.1
TXD1: J2.2 (TXD1), U1.4 (DI)
TXD2: J2.12 (TXD2), U2.4 (DI)
TXD3: J2.22 (TXD3), U3.4 (DI)
TXD4: J2.32 (TXD4), U4.4 (DI)
TXD5: J2.42 (TXD5), U5.4 (DI)
TXD6: J2.52 (TXD6), U6.4 (DI)
TXD7: J2.62 (TXD7), U7.4 (DI)
TXD8: J2.72 (TXD8), U8.4 (DI)
TXOUT0: J20.1 (In), T11.1 (UNBAL)
TXOUT1: J21.1 (In), T12.1 (UNBAL)
TXOUT2: J22.1 (In), T13.1 (UNBAL)
TXOUT3: J23.1 (In), T14.1 (UNBAL)
TXOUT4: J24.1 (In), T15.1 (UNBAL)
TXOUT5: J25.1 (In), T16.1 (UNBAL)
TXOUT6: J26.1 (In), T17.1 (UNBAL)
TXOUT7: J27.1 (In), T18.1 (UNBAL)
TXOUT8: J28.1 (In), T19.1 (UNBAL)
TX_EN_T1: J2.8 (TX_EN_T1), J3.5
TX_EN_T2: J2.18 (TX_EN_T2), J3.13
TX_EN_T3: J2.28 (TX_EN_T3), J3.21
TX_EN_T4: J2.38 (TX_EN_T4), J3.29
TX_EN_T5: J2.48 (TX_EN_T5), J3.6
TX_EN_T6: J2.58 (TX_EN_T6), J3.14
TX_EN_T7: J2.68 (TX_EN_T7), J3.22
TX_EN_T8: J2.78 (TX_EN_T8), J3.30
VCC_BUCK: C22.1, U10.6 (VCC)

Notes on the sheet:
RFSoC TILE CARRIER - 9 RX + 9 TX RF channels, 8 module links, QSFP28, clock

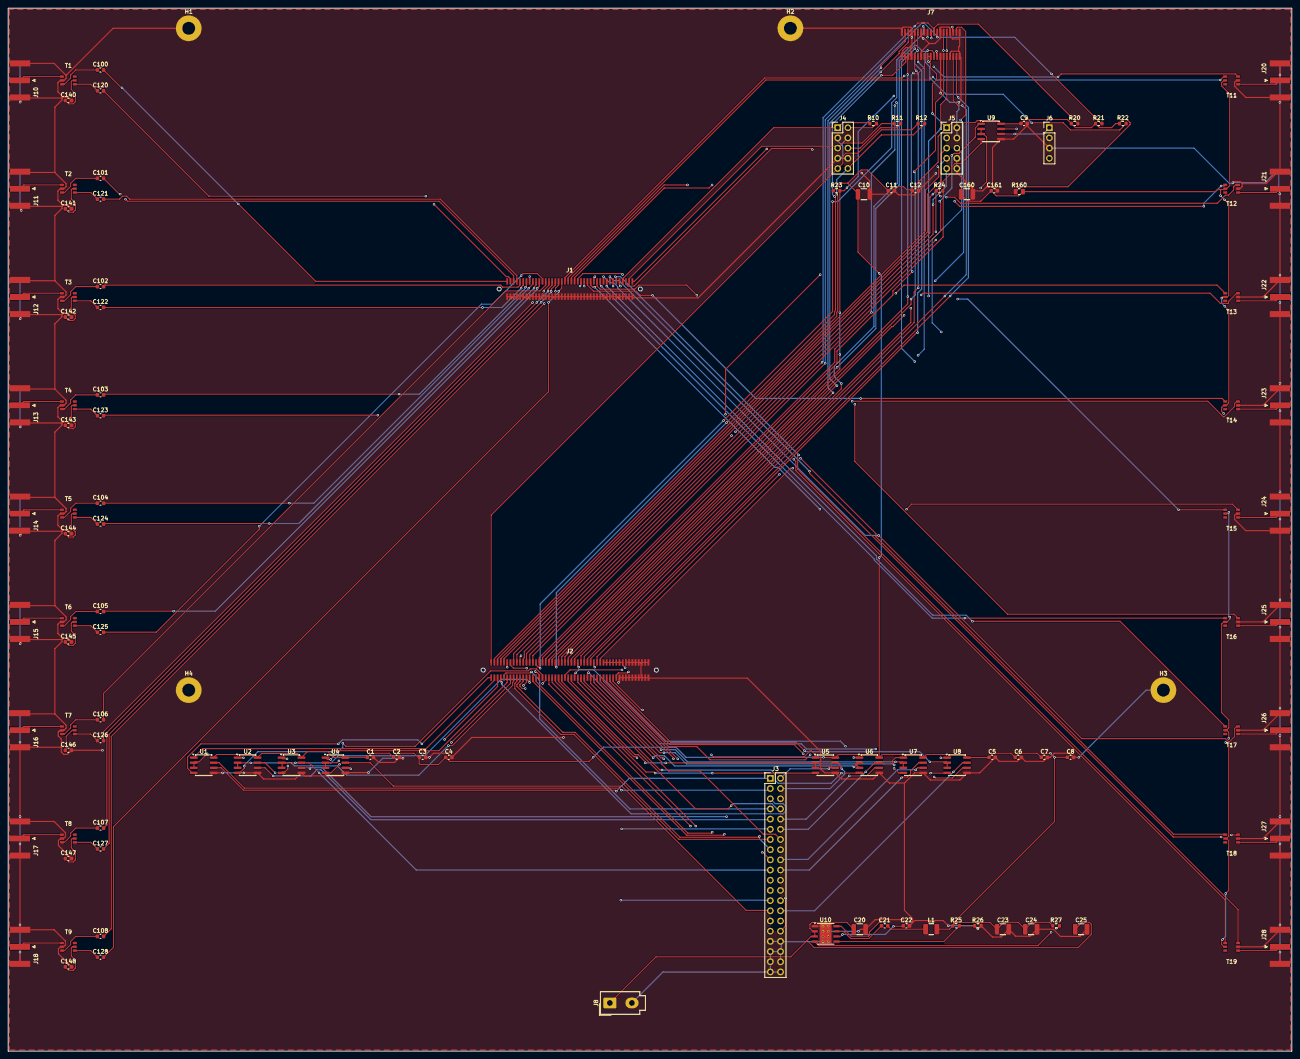
[picture p53: board SENTINEL_TILE.kicad_pcb from above]

Board: 4 copper layers, 320.0 x 260.0 mm, 118 parts (0 on the bottom side), 187 nets.
