ajisrawi/sentinel-uhf-radar/hardware/clock_board/SENTINEL_CLOCK.kicad_pcb

## KiCad design hardware/clock_board/SENTINEL_CLOCK.kicad_pcb (2026-10-19)

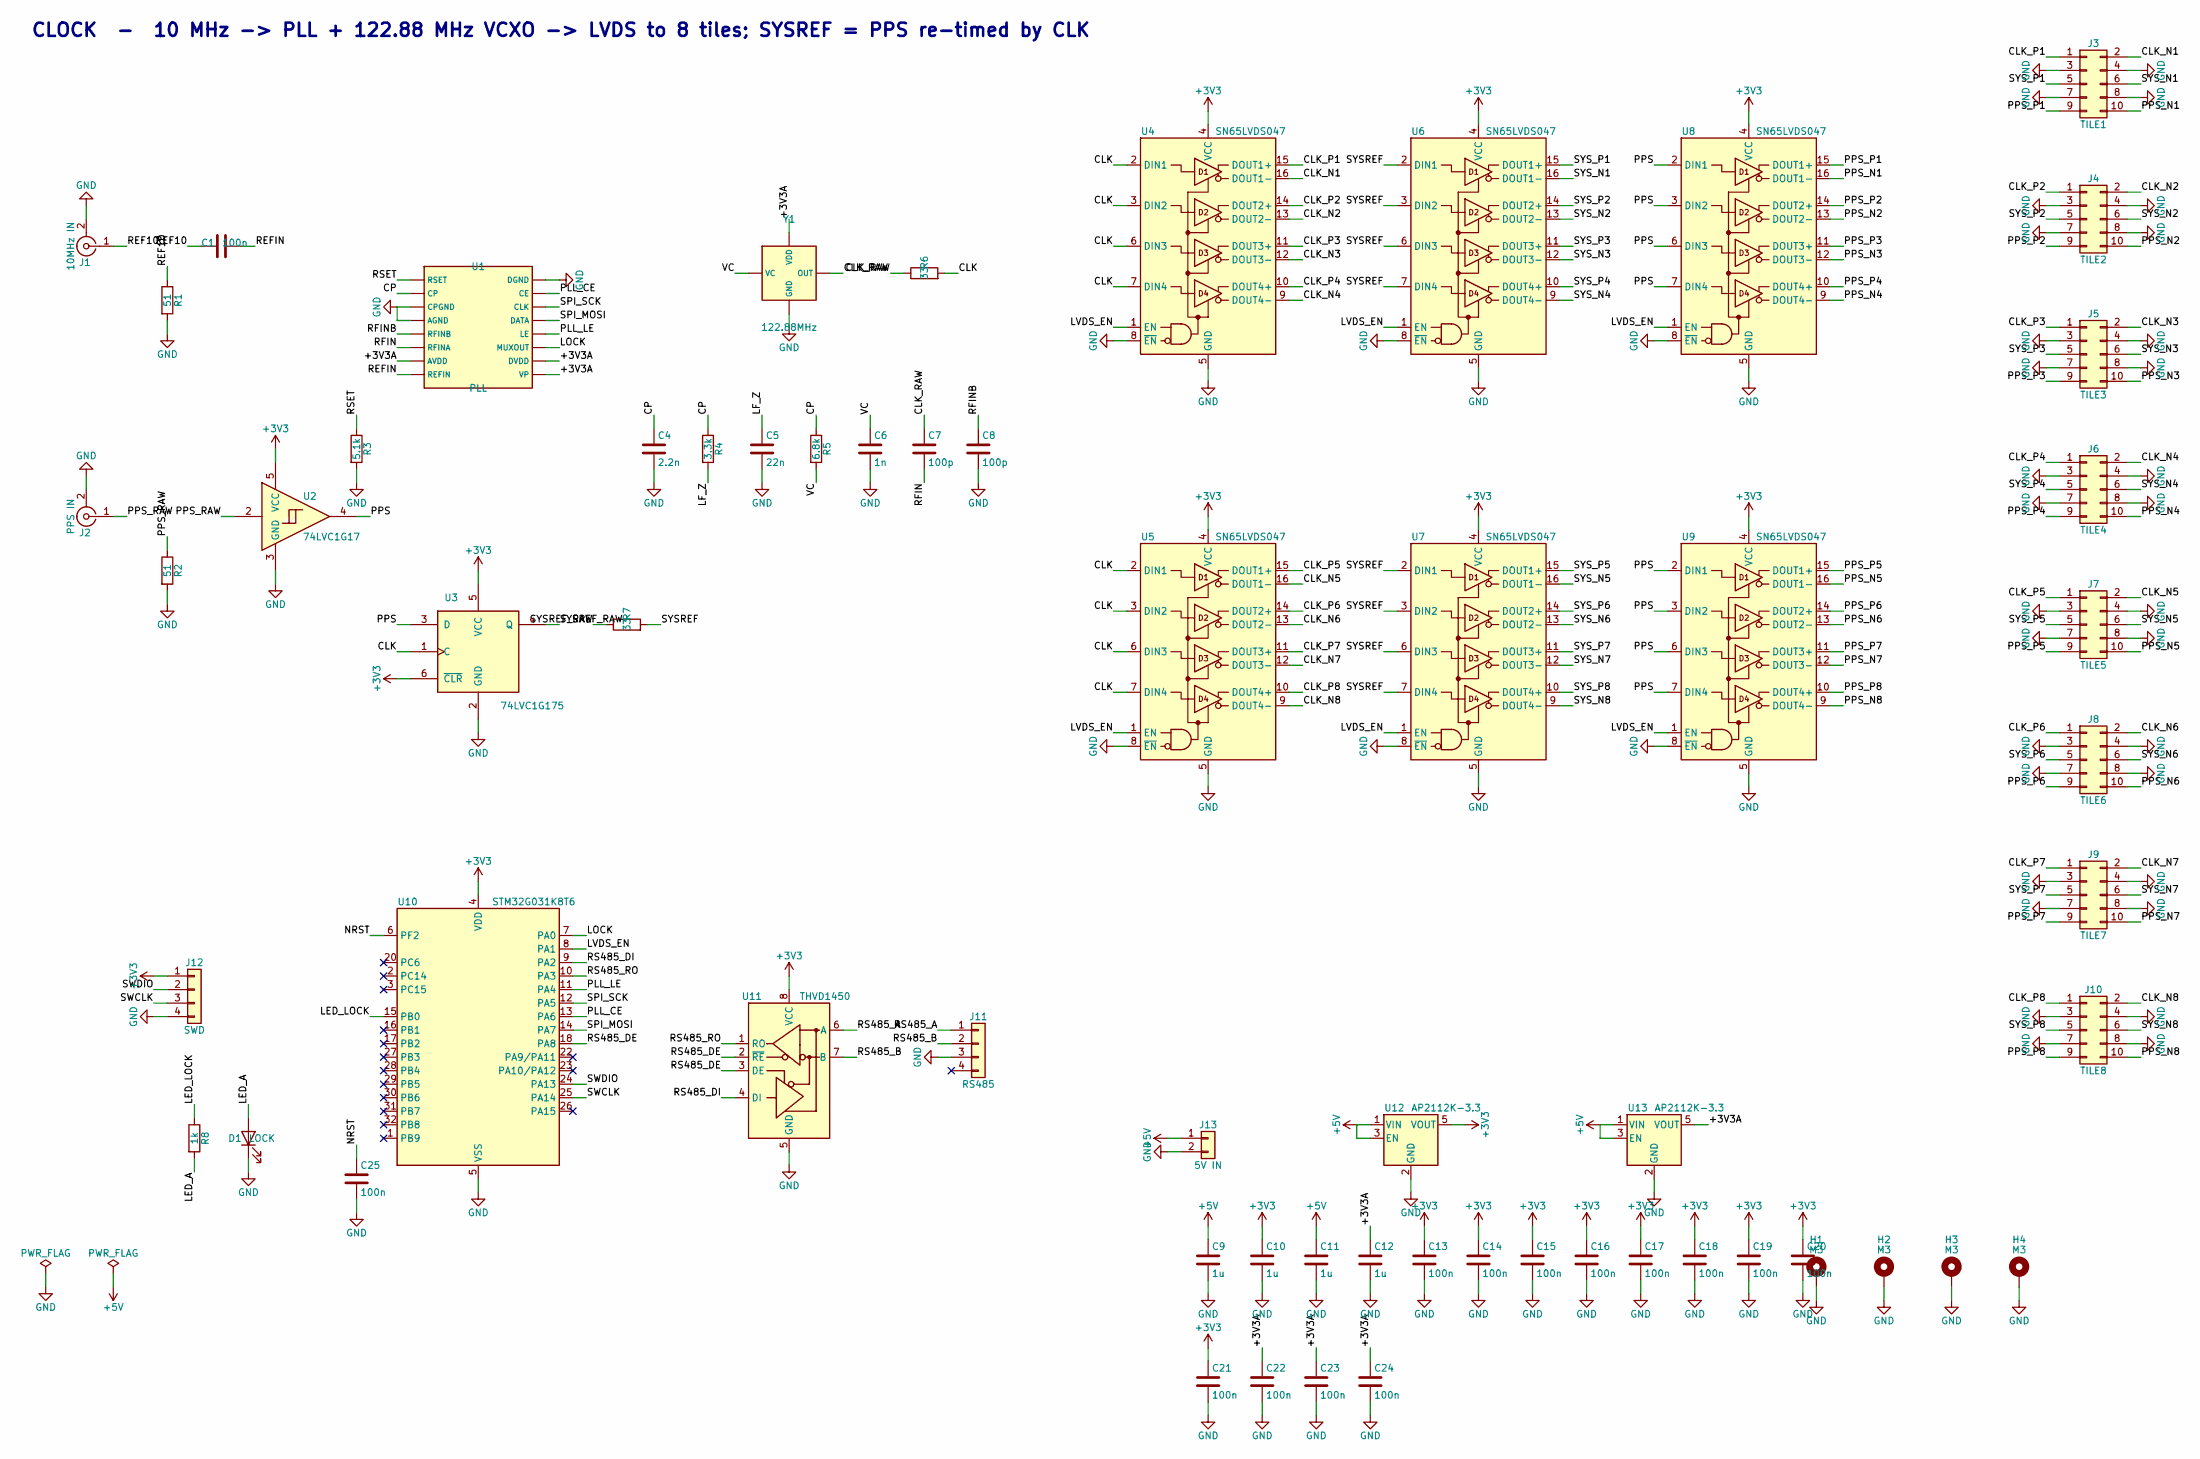
[picture p54: schematic SENTINEL_CLOCK.kicad_sch, SENTINEL-UHF Clock & Timing Distribution (8 tiles)]

Parts:
C1, C13, C14, C15, C16, C17, C18, C19, C20, C21, C22, C23, C24, C25: 100n; C_0603_1608Metric
C4: 2.2n; C_0603_1608Metric
C5: 22n; C_0603_1608Metric
C6: 1n; C_0603_1608Metric
C7, C8: 100p; C_0603_1608Metric
C9, C10, C11, C12: 1u; C_0603_1608Metric
D1: LOCK; LED_0603_1608Metric
H1, H2, H3, H4: M3; MountingHole_3.2mm_M3_Pad
J1: 10MHz IN; SMA_Amphenol_132289_EdgeMount
J2: PPS IN; SMA_Amphenol_132289_EdgeMount
J3: TILE1; PinHeader_2x05_P2.54mm_Vertical
J4: TILE2; PinHeader_2x05_P2.54mm_Vertical
J5: TILE3; PinHeader_2x05_P2.54mm_Vertical
J6: TILE4; PinHeader_2x05_P2.54mm_Vertical
J7: TILE5; PinHeader_2x05_P2.54mm_Vertical
J8: TILE6; PinHeader_2x05_P2.54mm_Vertical
J9: TILE7; PinHeader_2x05_P2.54mm_Vertical
J10: TILE8; PinHeader_2x05_P2.54mm_Vertical
J11: RS485; PinHeader_1x04_P2.54mm_Vertical
J12: SWD; PinHeader_1x04_P2.54mm_Vertical
J13: 5V IN; Molex_Mini-Fit_Jr_5566-02A_2x01_P4.20mm_Vertical
R1, R2: 51; R_0603_1608Metric
R3: 5.1k; R_0603_1608Metric
R4: 3.3k; R_0603_1608Metric
R5: 6.8k; R_0603_1608Metric
R6, R7: 33; R_0603_1608Metric
R8: 1k; R_0603_1608Metric
U1: PLL; TSSOP-16_4.4x5mm_P0.65mm
U2: 74LVC1G17; SOT-23-5
U3: 74LVC1G175; SOT-363_SC-70-6
U4, U5, U6, U7, U8, U9: SN65LVDS047; SOIC-16_3.9x9.9mm_P1.27mm
U10: STM32G031K8T6; LQFP-32_7x7mm_P0.8mm
U11: THVD1450; SOIC-8_3.9x4.9mm_P1.27mm
U12, U13: AP2112K-3.3; SOT-23-5
Y1: 122.88MHz; Oscillator_SMD_EuroQuartz_XO53-4Pin_5.0x3.2mm

Connections:
+3V3: C10.1, C13.1, C14.1, C15.1, C16.1, C17.1, C18.1, C19.1, C20.1, C21.1, J12.1, U2.5 (VCC), U3.5 (VCC), U3.6 (~CLR), U4.4 (VCC), U5.4 (VCC), U6.4 (VCC), U7.4 (VCC), U8.4 (VCC), U9.4 (VCC), U10.4 (VDD), U11.8 (VCC), U12.5 (VOUT)
+3V3A: C12.1, C22.1, C23.1, C24.1, U1.7 (AVDD), U1.15 (DVDD), U1.16 (VP), U13.5 (VOUT), Y1.4 (VDD)
+5V: C9.1, C11.1, J13.1, U12.1 (VIN), U12.3 (EN), U13.1 (VIN), U13.3 (EN)
CLK: R6.2, U3.1 (C), U4.2 (DIN1), U4.3 (DIN2), U4.6 (DIN3), U4.7 (DIN4), U5.2 (DIN1), U5.3 (DIN2), U5.6 (DIN3), U5.7 (DIN4)
CLK_N1: J3.2, U4.16 (DOUT1-)
CLK_N2: J4.2, U4.13 (DOUT2-)
CLK_N3: J5.2, U4.12 (DOUT3-)
CLK_N4: J6.2, U4.9 (DOUT4-)
CLK_N5: J7.2, U5.16 (DOUT1-)
CLK_N6: J8.2, U5.13 (DOUT2-)
CLK_N7: J9.2, U5.12 (DOUT3-)
CLK_N8: J10.2, U5.9 (DOUT4-)
CLK_P1: J3.1, U4.15 (DOUT1+)
CLK_P2: J4.1, U4.14 (DOUT2+)
CLK_P3: J5.1, U4.11 (DOUT3+)
CLK_P4: J6.1, U4.10 (DOUT4+)
CLK_P5: J7.1, U5.15 (DOUT1+)
CLK_P6: J8.1, U5.14 (DOUT2+)
CLK_P7: J9.1, U5.11 (DOUT3+)
CLK_P8: J10.1, U5.10 (DOUT4+)
CLK_RAW: C7.1, R6.1, Y1.3 (OUT)
CP: C4.1, R4.1, R5.1, U1.2 (CP)
GND: C4.2, C5.2, C6.2, C8.2, C9.2, C10.2, C11.2, C12.2, C13.2, C14.2, C15.2, C16.2, C17.2, C18.2, C19.2, C20.2, C21.2, C22.2, C23.2, C24.2, C25.2, D1.1 (K), H1.1, H2.1, H3.1, H4.1, J1.2 (Ext), J2.2 (Ext), J3.3, J3.4, J3.7, J3.8, J4.3, J4.4, J4.7, J4.8, J5.3, J5.4, J5.7, J5.8, J6.3, J6.4, J6.7, J6.8, J7.3, J7.4, J7.7, J7.8, J8.3, J8.4, J8.7, J8.8, J9.3, J9.4, J9.7, J9.8, J10.3, J10.4, J10.7, J10.8, J11.3, J12.4, J13.2, R1.2, R2.2, R3.2, U1.3 (CPGND), U1.4 (AGND), U1.9 (DGND), U2.3 (GND), U3.2 (GND), U4.5 (GND), U4.8 (~EN), U5.5 (GND), U5.8 (~EN), U6.5 (GND), U6.8 (~EN), U7.5 (GND), U7.8 (~EN), U8.5 (GND), U8.8 (~EN), U9.5 (GND), U9.8 (~EN), U10.5 (VSS), U11.5 (GND), U12.2 (GND), U13.2 (GND), Y1.2 (GND)
LED_A: D1.2 (A), R8.2
LED_LOCK: R8.1, U10.15 (PB0)
LF_Z: C5.1, R4.2
LOCK: U1.14 (MUXOUT), U10.7 (PA0)
LVDS_EN: U4.1 (EN), U5.1 (EN), U6.1 (EN), U7.1 (EN), U8.1 (EN), U9.1 (EN), U10.8 (PA1)
NRST: C25.1, U10.6 (PF2)
PLL_CE: U1.10 (CE), U10.13 (PA6)
PLL_LE: U1.13 (LE), U10.11 (PA4)
PPS: U2.4, U3.3 (D), U8.2 (DIN1), U8.3 (DIN2), U8.6 (DIN3), U8.7 (DIN4), U9.2 (DIN1), U9.3 (DIN2), U9.6 (DIN3), U9.7 (DIN4)
PPS_N1: J3.10, U8.16 (DOUT1-)
PPS_N2: J4.10, U8.13 (DOUT2-)
PPS_N3: J5.10, U8.12 (DOUT3-)
PPS_N4: J6.10, U8.9 (DOUT4-)
PPS_N5: J7.10, U9.16 (DOUT1-)
PPS_N6: J8.10, U9.13 (DOUT2-)
PPS_N7: J9.10, U9.12 (DOUT3-)
PPS_N8: J10.10, U9.9 (DOUT4-)
PPS_P1: J3.9, U8.15 (DOUT1+)
PPS_P2: J4.9, U8.14 (DOUT2+)
PPS_P3: J5.9, U8.11 (DOUT3+)
PPS_P4: J6.9, U8.10 (DOUT4+)
PPS_P5: J7.9, U9.15 (DOUT1+)
PPS_P6: J8.9, U9.14 (DOUT2+)
PPS_P7: J9.9, U9.11 (DOUT3+)
PPS_P8: J10.9, U9.10 (DOUT4+)
PPS_RAW: J2.1 (In), R2.1, U2.2
REF10: C1.1, J1.1 (In), R1.1
REFIN: C1.2, U1.8 (REFIN)
RFIN: C7.2, U1.6 (RFINA)
RFINB: C8.1, U1.5 (RFINB)
RS485_A: J11.1, U11.6 (A)
RS485_B: J11.2, U11.7 (B)
RS485_DE: U10.18 (PA8), U11.2 (~RE), U11.3 (DE)
RS485_DI: U10.9 (PA2), U11.4 (DI)
RS485_RO: U10.10 (PA3), U11.1 (RO)
RSET: R3.1, U1.1 (RSET)
SPI_MOSI: U1.12 (DATA), U10.14 (PA7)
SPI_SCK: U1.11 (CLK), U10.12 (PA5)
SWCLK: J12.3, U10.25 (PA14)
SWDIO: J12.2, U10.24 (PA13)
SYSREF: R7.2, U6.2 (DIN1), U6.3 (DIN2), U6.6 (DIN3), U6.7 (DIN4), U7.2 (DIN1), U7.3 (DIN2), U7.6 (DIN3), U7.7 (DIN4)
SYSREF_RAW: R7.1, U3.4 (Q)
SYS_N1: J3.6, U6.16 (DOUT1-)
SYS_N2: J4.6, U6.13 (DOUT2-)
SYS_N3: J5.6, U6.12 (DOUT3-)
SYS_N4: J6.6, U6.9 (DOUT4-)
SYS_N5: J7.6, U7.16 (DOUT1-)
SYS_N6: J8.6, U7.13 (DOUT2-)
SYS_N7: J9.6, U7.12 (DOUT3-)
SYS_N8: J10.6, U7.9 (DOUT4-)
SYS_P1: J3.5, U6.15 (DOUT1+)
SYS_P2: J4.5, U6.14 (DOUT2+)
SYS_P3: J5.5, U6.11 (DOUT3+)
SYS_P4: J6.5, U6.10 (DOUT4+)
SYS_P5: J7.5, U7.15 (DOUT1+)
SYS_P6: J8.5, U7.14 (DOUT2+)
SYS_P7: J9.5, U7.11 (DOUT3+)
SYS_P8: J10.5, U7.10 (DOUT4+)
VC: C6.1, R5.2, Y1.1 (VC)

Notes on the sheet:
CLOCK - 10 MHz -> PLL + 122.88 MHz VCXO -> LVDS to 8 tiles; SYSREF = PPS re-timed by CLK

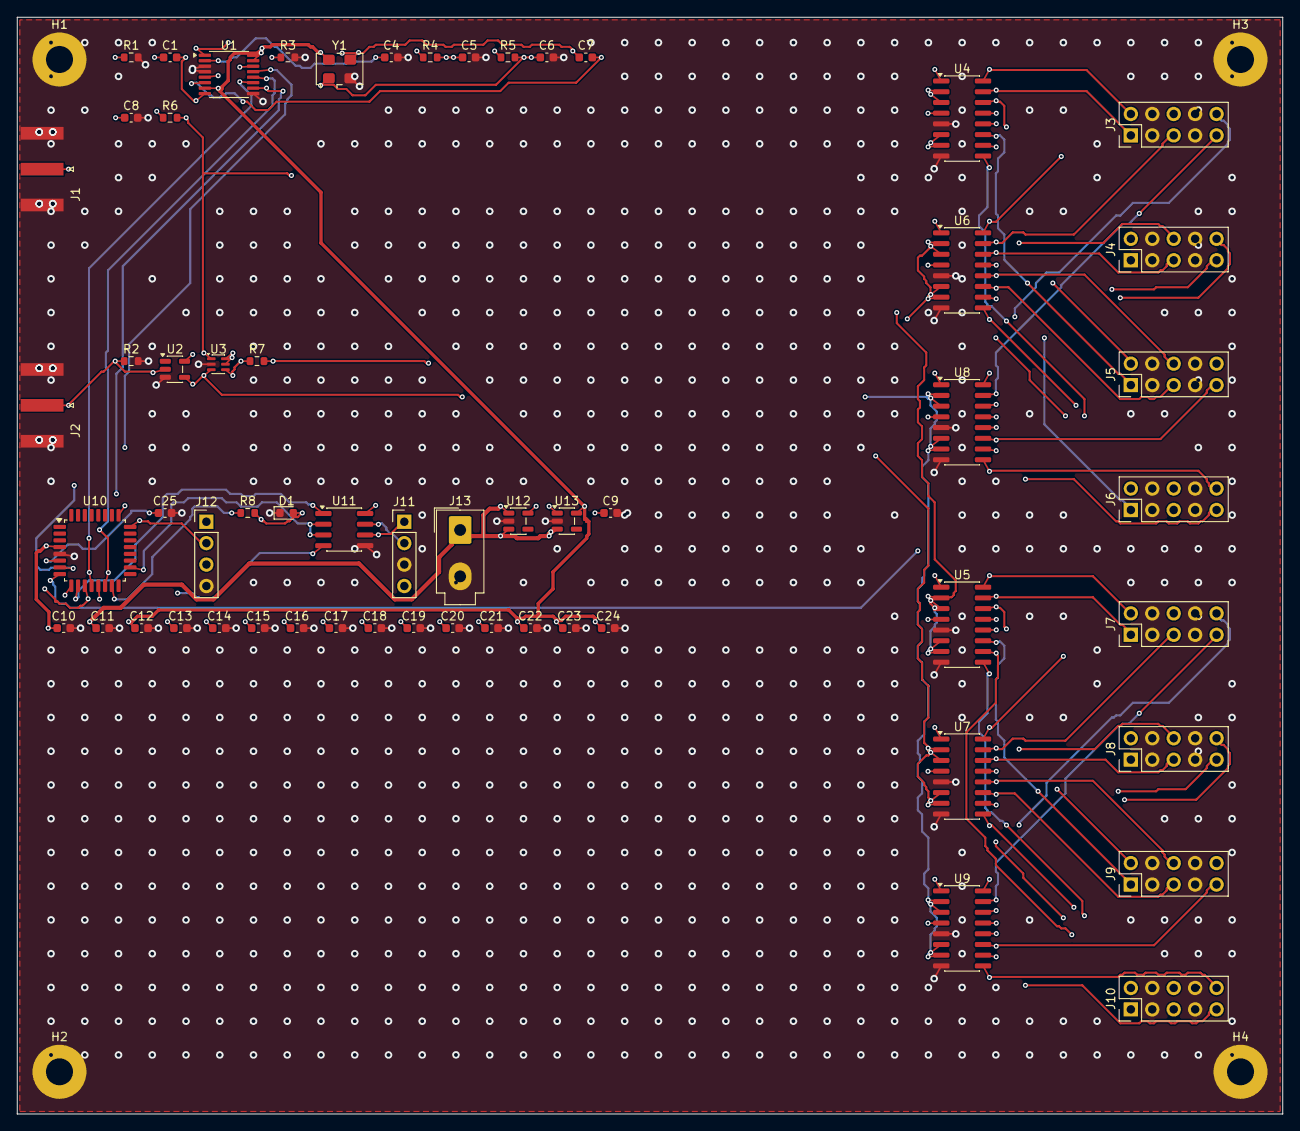
[picture p55: board SENTINEL_CLOCK.kicad_pcb from above]

Board: 4 copper layers, 150.0 x 130.0 mm, 63 parts (0 on the bottom side), 82 nets.
