ajisrawi/sentinel-uhf-radar/hardware/backplane/SENTINEL_BACKPLANE.kicad_pcb

## KiCad design hardware/backplane/SENTINEL_BACKPLANE.kicad_pcb (2026-10-19)

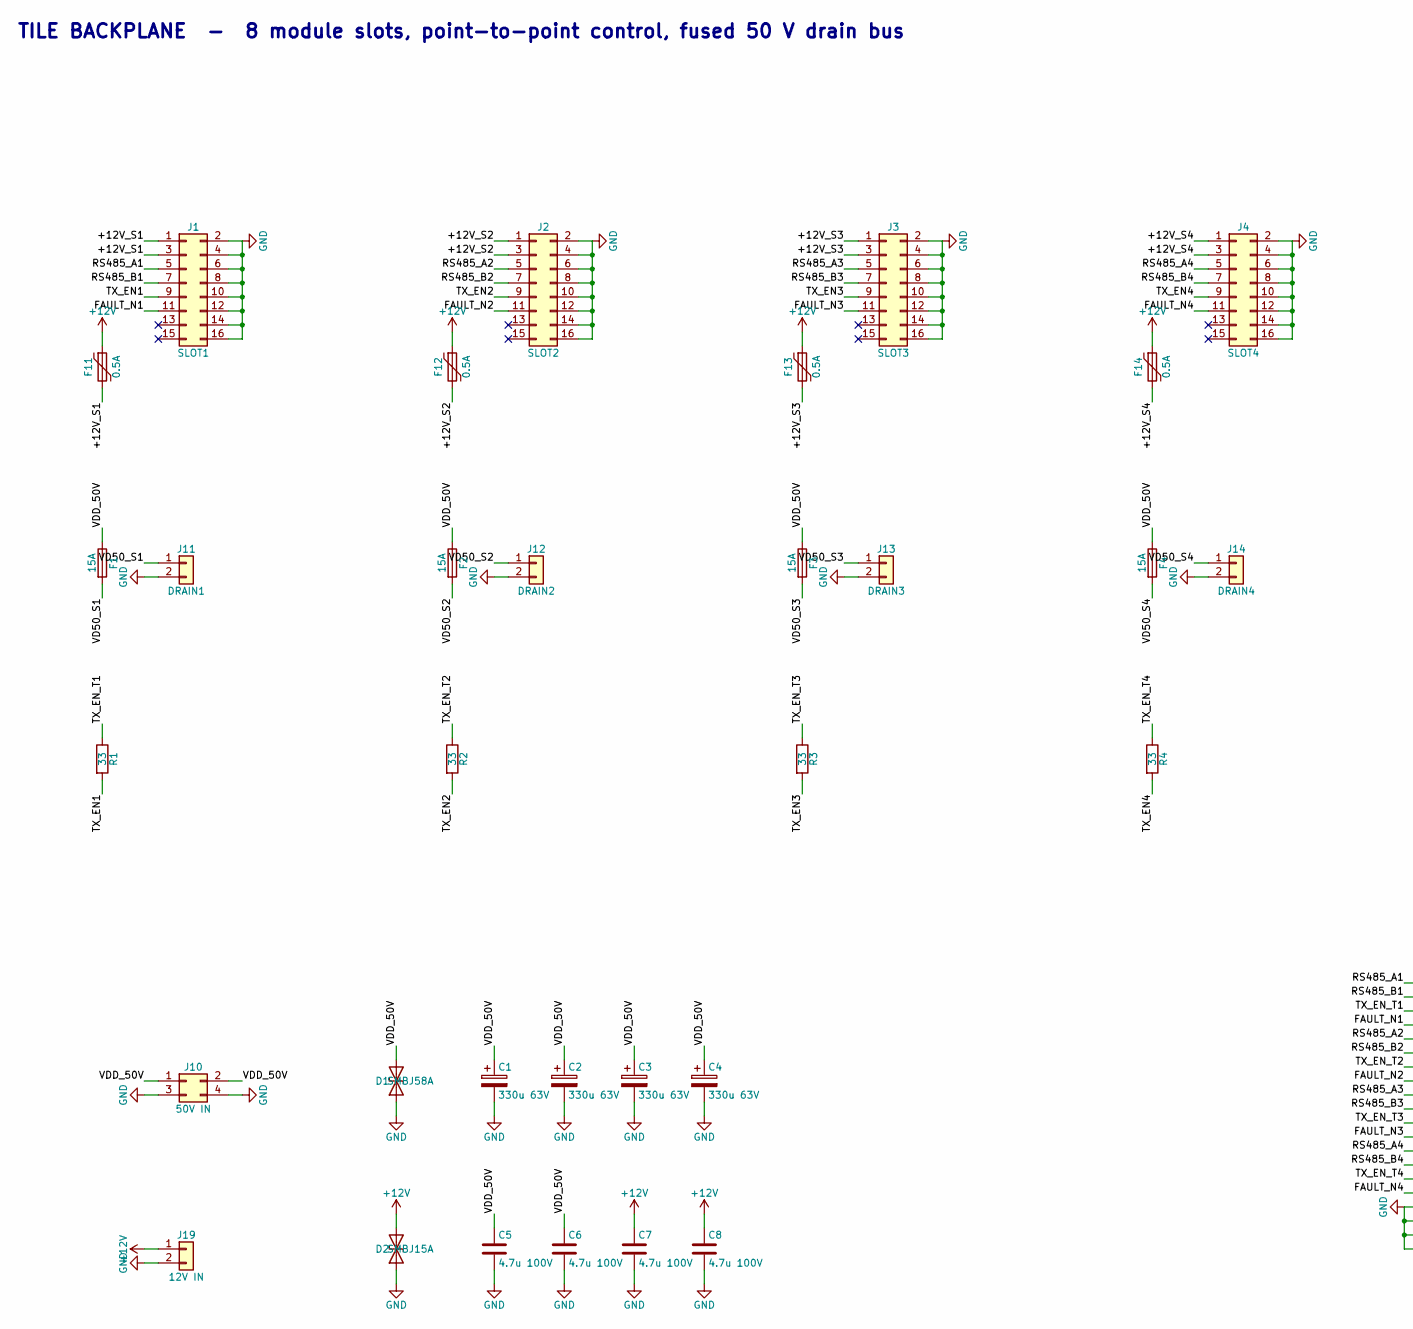
[picture p56: schematic SENTINEL_BACKPLANE.kicad_sch, SENTINEL-UHF Tile Backplane (8 T/R modules), part in row 1, column 1]

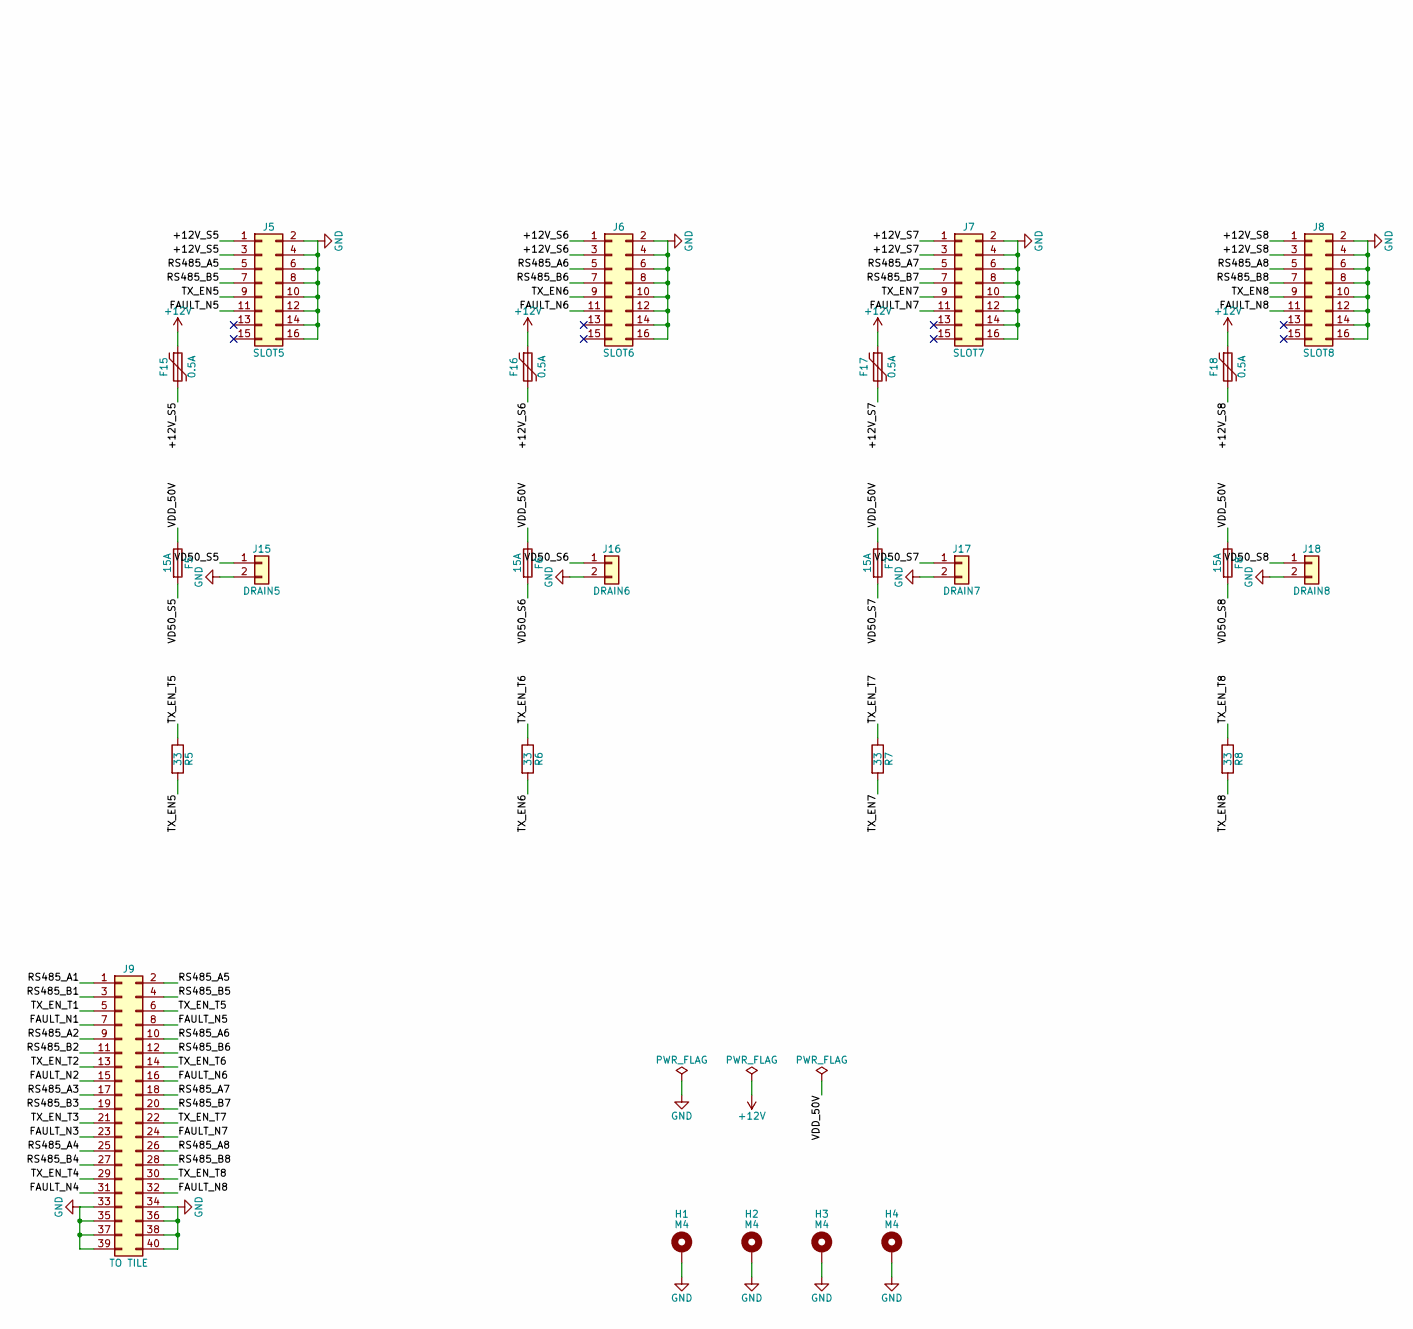
[picture p57: schematic SENTINEL_BACKPLANE.kicad_sch, SENTINEL-UHF Tile Backplane (8 T/R modules), part in row 1, column 2]

Parts:
C1, C2, C3, C4: 330u 63V; CP_Elec_10x10.5
C5, C6, C7, C8: 4.7u 100V; C_1210_3225Metric
D1: SMBJ58A; D_SMB
D2: SMBJ15A; D_SMB
F1, F2, F3, F4, F5, F6, F7, F8: 15A; Fuse_456_SMD
F11, F12, F13, F14, F15, F16, F17, F18: 0.5A; Fuse_1812_4532Metric
H1, H2, H3, H4: M4; MountingHole_3.2mm_M3_Pad
J1: SLOT1; PinHeader_2x08_P2.54mm_Vertical
J2: SLOT2; PinHeader_2x08_P2.54mm_Vertical
J3: SLOT3; PinHeader_2x08_P2.54mm_Vertical
J4: SLOT4; PinHeader_2x08_P2.54mm_Vertical
J5: SLOT5; PinHeader_2x08_P2.54mm_Vertical
J6: SLOT6; PinHeader_2x08_P2.54mm_Vertical
J7: SLOT7; PinHeader_2x08_P2.54mm_Vertical
J8: SLOT8; PinHeader_2x08_P2.54mm_Vertical
J9: TO TILE; PinHeader_2x20_P2.54mm_Vertical
J10: 50V IN; Molex_Mini-Fit_Jr_5566-04A_2x02_P4.20mm_Vertical
J11: DRAIN1; Molex_Mini-Fit_Jr_5566-02A_2x01_P4.20mm_Vertical
J12: DRAIN2; Molex_Mini-Fit_Jr_5566-02A_2x01_P4.20mm_Vertical
J13: DRAIN3; Molex_Mini-Fit_Jr_5566-02A_2x01_P4.20mm_Vertical
J14: DRAIN4; Molex_Mini-Fit_Jr_5566-02A_2x01_P4.20mm_Vertical
J15: DRAIN5; Molex_Mini-Fit_Jr_5566-02A_2x01_P4.20mm_Vertical
J16: DRAIN6; Molex_Mini-Fit_Jr_5566-02A_2x01_P4.20mm_Vertical
J17: DRAIN7; Molex_Mini-Fit_Jr_5566-02A_2x01_P4.20mm_Vertical
J18: DRAIN8; Molex_Mini-Fit_Jr_5566-02A_2x01_P4.20mm_Vertical
J19: 12V IN; Molex_Mini-Fit_Jr_5566-02A_2x01_P4.20mm_Vertical
R1, R2, R3, R4, R5, R6, R7, R8: 33; R_0603_1608Metric

Connections:
+12V: C7.1, C8.1, D2.2 (A2), F11.1, F12.1, F13.1, F14.1, F15.1, F16.1, F17.1, F18.1, J19.1
+12V_S1: F11.2, J1.1, J1.3
+12V_S2: F12.2, J2.1, J2.3
+12V_S3: F13.2, J3.1, J3.3
+12V_S4: F14.2, J4.1, J4.3
+12V_S5: F15.2, J5.1, J5.3
+12V_S6: F16.2, J6.1, J6.3
+12V_S7: F17.2, J7.1, J7.3
+12V_S8: F18.2, J8.1, J8.3
FAULT_N1: J1.11, J9.7
FAULT_N2: J2.11, J9.15
FAULT_N3: J3.11, J9.23
FAULT_N4: J4.11, J9.31
FAULT_N5: J5.11, J9.8
FAULT_N6: J6.11, J9.16
FAULT_N7: J7.11, J9.24
FAULT_N8: J8.11, J9.32
GND: C1.2, C2.2, C3.2, C4.2, C5.2, C6.2, C7.2, C8.2, D1.1 (A1), D2.1 (A1), H1.1, H2.1, H3.1, H4.1, J1.2, J1.4, J1.6, J1.8, J1.10, J1.12, J1.14, J1.16, J2.2, J2.4, J2.6, J2.8, J2.10, J2.12, J2.14, J2.16, J3.2, J3.4, J3.6, J3.8, J3.10, J3.12, J3.14, J3.16, J4.2, J4.4, J4.6, J4.8, J4.10, J4.12, J4.14, J4.16, J5.2, J5.4, J5.6, J5.8, J5.10, J5.12, J5.14, J5.16, J6.2, J6.4, J6.6, J6.8, J6.10, J6.12, J6.14, J6.16, J7.2, J7.4, J7.6, J7.8, J7.10, J7.12, J7.14, J7.16, J8.2, J8.4, J8.6, J8.8, J8.10, J8.12, J8.14, J8.16, J9.33, J9.34, J9.35, J9.36, J9.37, J9.38, J9.39, J9.40, J10.3, J10.4, J11.2, J12.2, J13.2, J14.2, J15.2, J16.2, J17.2, J18.2, J19.2
RS485_A1: J1.5, J9.1
RS485_A2: J2.5, J9.9
RS485_A3: J3.5, J9.17
RS485_A4: J4.5, J9.25
RS485_A5: J5.5, J9.2
RS485_A6: J6.5, J9.10
RS485_A7: J7.5, J9.18
RS485_A8: J8.5, J9.26
RS485_B1: J1.7, J9.3
RS485_B2: J2.7, J9.11
RS485_B3: J3.7, J9.19
RS485_B4: J4.7, J9.27
RS485_B5: J5.7, J9.4
RS485_B6: J6.7, J9.12
RS485_B7: J7.7, J9.20
RS485_B8: J8.7, J9.28
TX_EN1: J1.9, R1.2
TX_EN2: J2.9, R2.2
TX_EN3: J3.9, R3.2
TX_EN4: J4.9, R4.2
TX_EN5: J5.9, R5.2
TX_EN6: J6.9, R6.2
TX_EN7: J7.9, R7.2
TX_EN8: J8.9, R8.2
TX_EN_T1: J9.5, R1.1
TX_EN_T2: J9.13, R2.1
TX_EN_T3: J9.21, R3.1
TX_EN_T4: J9.29, R4.1
TX_EN_T5: J9.6, R5.1
TX_EN_T6: J9.14, R6.1
TX_EN_T7: J9.22, R7.1
TX_EN_T8: J9.30, R8.1
VD50_S1: F1.2, J11.1
VD50_S2: F2.2, J12.1
VD50_S3: F3.2, J13.1
VD50_S4: F4.2, J14.1
VD50_S5: F5.2, J15.1
VD50_S6: F6.2, J16.1
VD50_S7: F7.2, J17.1
VD50_S8: F8.2, J18.1
VDD_50V: C1.1, C2.1, C3.1, C4.1, C5.1, C6.1, D1.2 (A2), F1.1, F2.1, F3.1, F4.1, F5.1, F6.1, F7.1, F8.1, J10.1, J10.2

Notes on the sheet:
TILE BACKPLANE - 8 module slots, point-to-point control, fused 50 V drain bus

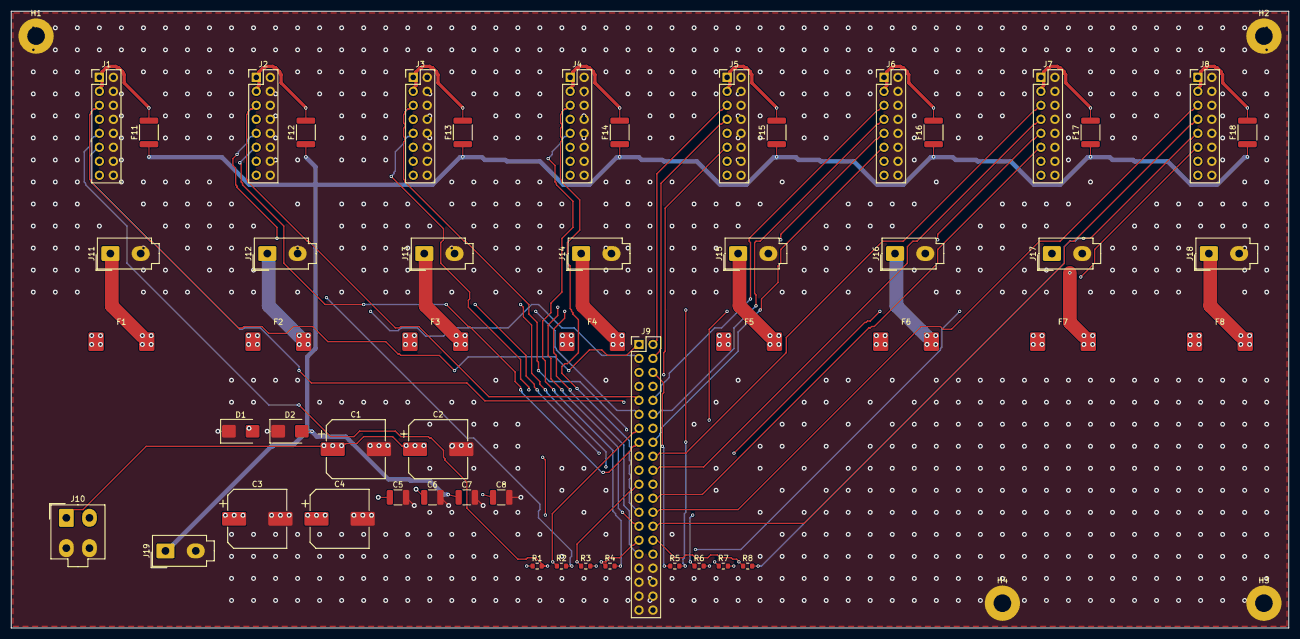
[picture p58: board SENTINEL_BACKPLANE.kicad_pcb from above]

Board: 4 copper layers, 232.0 x 112.0 mm, 57 parts (0 on the bottom side), 59 nets.
