ajisrawi/sentinel-uhf-radar/hardware/cal_board/SENTINEL_CAL.kicad_pcb

## KiCad design hardware/cal_board/SENTINEL_CAL.kicad_pcb (2026-10-18)

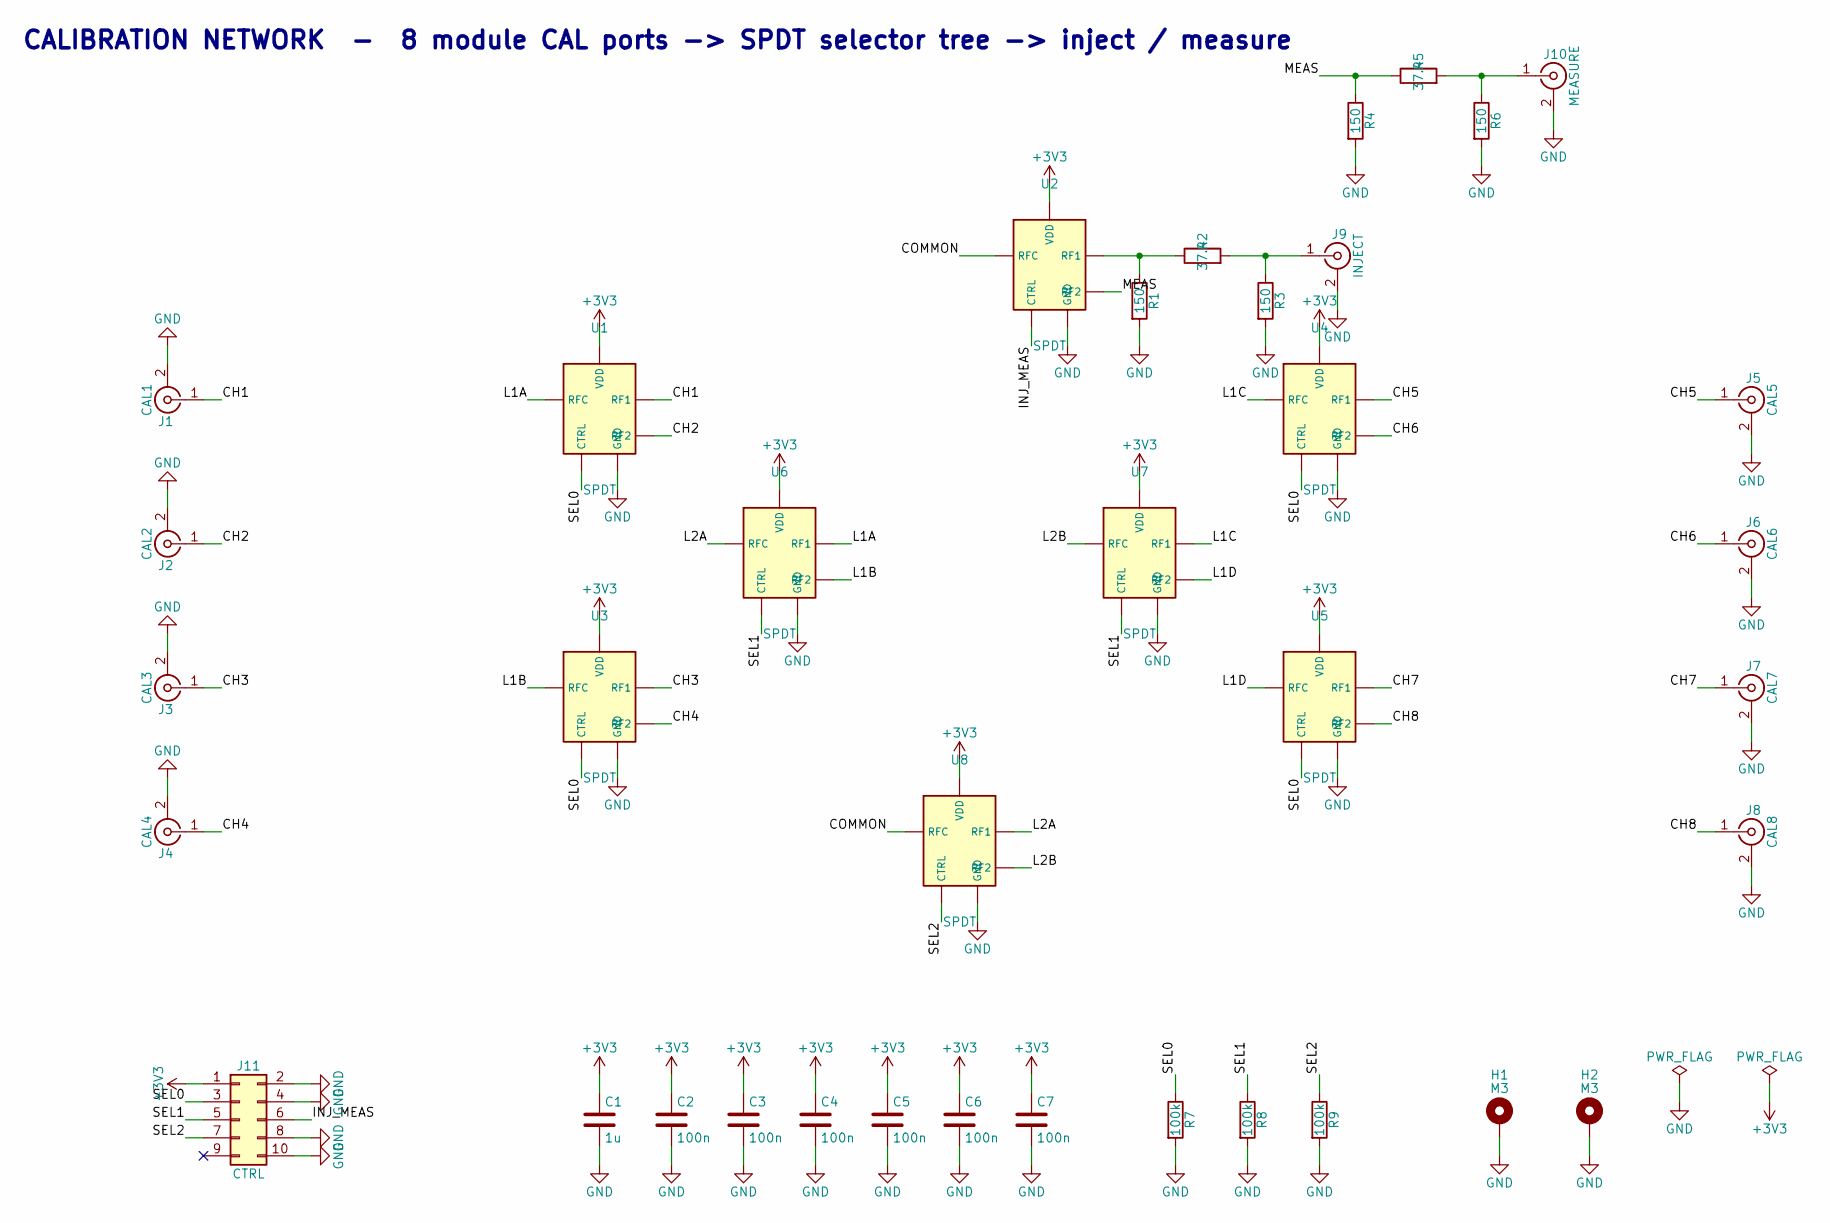
[picture p59: schematic SENTINEL_CAL.kicad_sch, SENTINEL-UHF Calibration Network]

Parts:
C1: 1u; C_0603_1608Metric
C2, C3, C4, C5, C6, C7: 100n; C_0603_1608Metric
H1, H2: M3; MountingHole_3.2mm_M3_Pad
J1: CAL1; SMA_Amphenol_132289_EdgeMount
J2: CAL2; SMA_Amphenol_132289_EdgeMount
J3: CAL3; SMA_Amphenol_132289_EdgeMount
J4: CAL4; SMA_Amphenol_132289_EdgeMount
J5: CAL5; SMA_Amphenol_132289_EdgeMount
J6: CAL6; SMA_Amphenol_132289_EdgeMount
J7: CAL7; SMA_Amphenol_132289_EdgeMount
J8: CAL8; SMA_Amphenol_132289_EdgeMount
J9: INJECT; SMA_Amphenol_132289_EdgeMount
J10: MEASURE; SMA_Amphenol_132289_EdgeMount
J11: CTRL; PinHeader_2x05_P2.54mm_Vertical
R1, R3, R4, R6: 150; R_0603_1608Metric
R2, R5: 37.4; R_0603_1608Metric
R7, R8, R9: 100k; R_0603_1608Metric
U1, U2, U3, U4, U5, U6, U7, U8: SPDT; SOT-363_SC-70-6

Connections:
+3V3: C1.1, C2.1, C3.1, C4.1, C5.1, C6.1, C7.1, J11.1, U1.6 (VDD), U2.6 (VDD), U3.6 (VDD), U4.6 (VDD), U5.6 (VDD), U6.6 (VDD), U7.6 (VDD), U8.6 (VDD)
CH1: J1.1 (In), U1.1 (RF1)
CH2: J2.1 (In), U1.3 (RF2)
CH3: J3.1 (In), U3.1 (RF1)
CH4: J4.1 (In), U3.3 (RF2)
CH5: J5.1 (In), U4.1 (RF1)
CH6: J6.1 (In), U4.3 (RF2)
CH7: J7.1 (In), U5.1 (RF1)
CH8: J8.1 (In), U5.3 (RF2)
COMMON: U2.5 (RFC), U8.5 (RFC)
GND: C1.2, C2.2, C3.2, C4.2, C5.2, C6.2, C7.2, H1.1, H2.1, J1.2 (Ext), J2.2 (Ext), J3.2 (Ext), J4.2 (Ext), J5.2 (Ext), J6.2 (Ext), J7.2 (Ext), J8.2 (Ext), J9.2 (Ext), J10.2 (Ext), J11.2, J11.4, J11.8, J11.10, R1.2, R3.2, R4.2, R6.2, R7.2, R8.2, R9.2, U1.2 (GND), U2.2 (GND), U3.2 (GND), U4.2 (GND), U5.2 (GND), U6.2 (GND), U7.2 (GND), U8.2 (GND)
INJ_MEAS: J11.6, U2.4 (CTRL)
L1A: U1.5 (RFC), U6.1 (RF1)
L1B: U3.5 (RFC), U6.3 (RF2)
L1C: U4.5 (RFC), U7.1 (RF1)
L1D: U5.5 (RFC), U7.3 (RF2)
L2A: U6.5 (RFC), U8.1 (RF1)
L2B: U7.5 (RFC), U8.3 (RF2)
MEAS: R4.1, R5.1, U2.3 (RF2)
unnamed: J9.1 (In), R2.2, R3.1
unnamed: J10.1 (In), R5.2, R6.1
unnamed: R1.1, R2.1, U2.1 (RF1)
SEL0: J11.3, R7.1, U1.4 (CTRL), U3.4 (CTRL), U4.4 (CTRL), U5.4 (CTRL)
SEL1: J11.5, R8.1, U6.4 (CTRL), U7.4 (CTRL)
SEL2: J11.7, R9.1, U8.4 (CTRL)

Notes on the sheet:
CALIBRATION NETWORK - 8 module CAL ports -> SPDT selector tree -> inject / measure

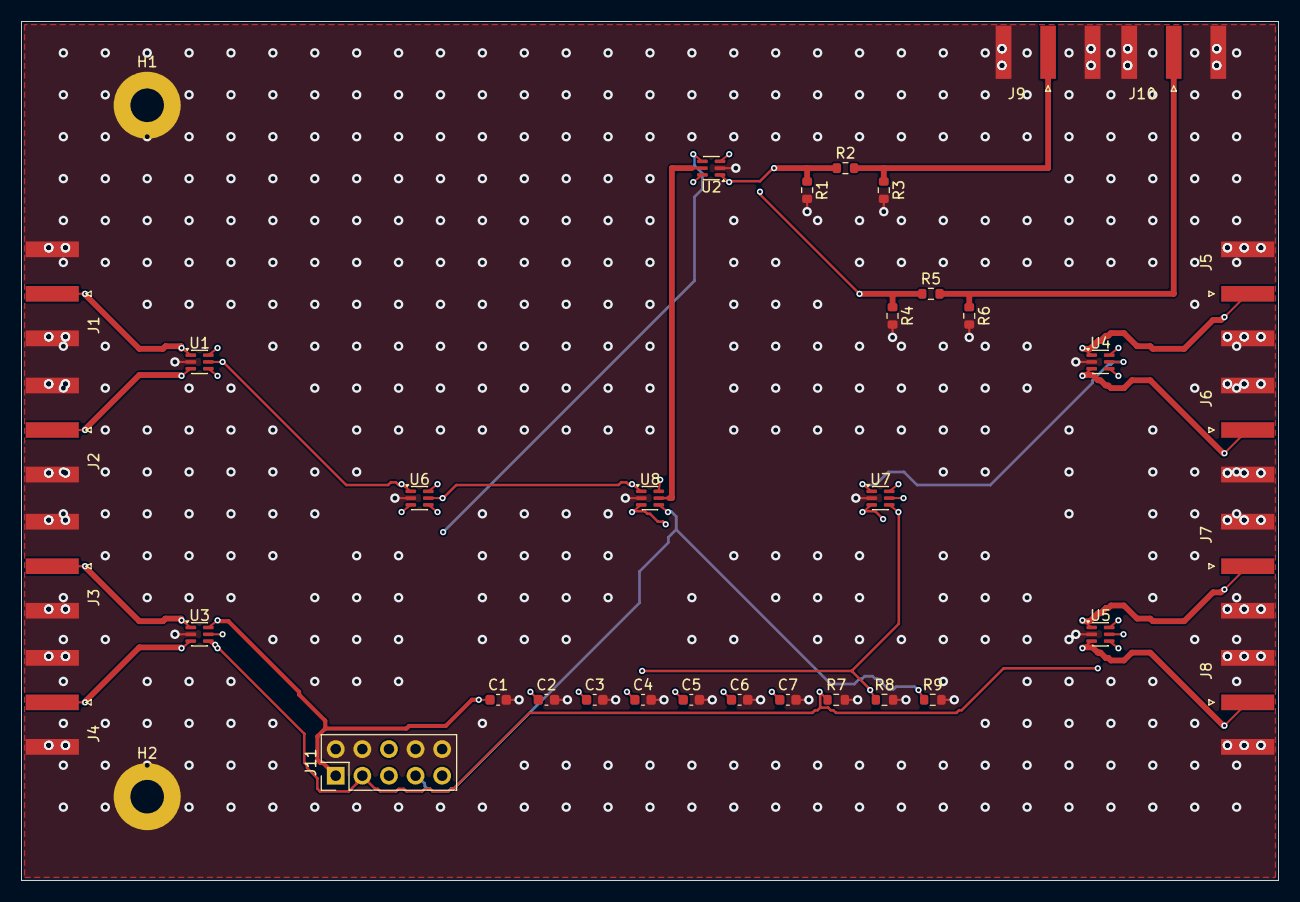
[picture p60: board SENTINEL_CAL.kicad_pcb from above]

Board: 4 copper layers, 120.0 x 82.0 mm, 37 parts (0 on the bottom side), 25 nets.
