ajisrawi/sentinel-uhf-radar/hardware/feed_board/SENTINEL_FEED.kicad_pcb

## KiCad design hardware/feed_board/SENTINEL_FEED.kicad_pcb (2026-10-18)

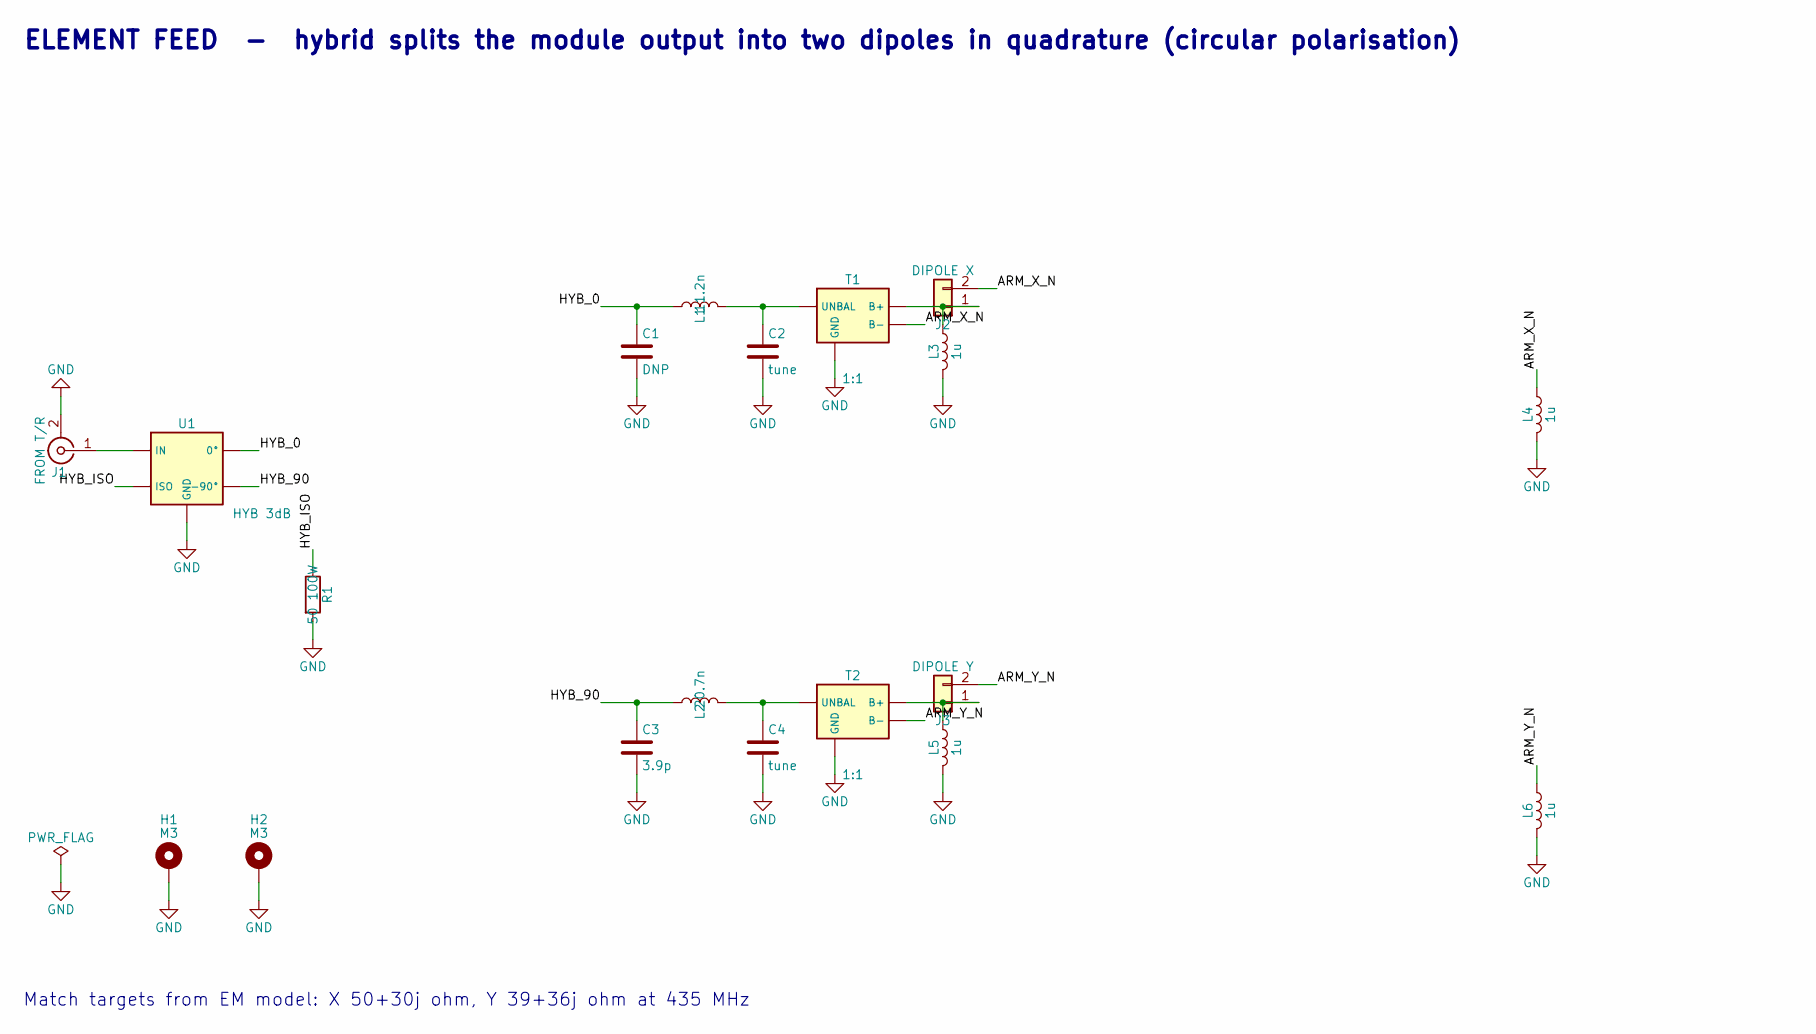
[picture p61: schematic SENTINEL_FEED.kicad_sch, SENTINEL-UHF Element Feed Board]

Parts:
C1: DNP; C_2220_5750Metric
C2, C4: tune; C_2220_5750Metric; MPN DNP
C3: 3.9p; C_2220_5750Metric
H1, H2: M3; MountingHole_3.2mm_M3_Pad
J1: FROM T/R; N_EdgeLaunch
J2: DIPOLE X; DipoleArm_M4_Pair
J3: DIPOLE Y; DipoleArm_M4_Pair
L1: 11.2n; L_1210_3225Metric
L2: 20.7n; L_1210_3225Metric
L3, L4, L5, L6: 1u; L_0805_2012Metric
R1: 50 100W; Termination_100W_SMD
T1, T2: 1:1; Balun_SMD_10x8
U1: HYB 3dB; Hybrid90_SMD_15x10

Connections:
ARM_X_N: J2.2, L4.1, T1.4 (B-)
ARM_Y_N: J3.2, L6.1, T2.4 (B-)
GND: C1.2, C2.2, C3.2, C4.2, H1.1, H2.1, J1.2 (Ext), L3.2, L4.2, L5.2, L6.2, R1.2, T1.2 (GND), T2.2 (GND), U1.5 (GND)
HYB_0: C1.1, L1.1, U1.3 (0°)
HYB_90: C3.1, L2.1, U1.4 (-90°)
HYB_ISO: R1.1, U1.2 (ISO)
unnamed: J1.1 (In), U1.1 (IN)
unnamed: J2.1, L3.1, T1.3 (B+)
unnamed: J3.1, L5.1, T2.3 (B+)
unnamed: C2.1, L1.2, T1.1 (UNBAL)
unnamed: C4.1, L2.2, T2.1 (UNBAL)

Notes on the sheet:
ELEMENT FEED - hybrid splits the module output into two dipoles in quadrature (circular polarisation)
Match targets from EM model: X 50+30j ohm, Y 39+36j ohm at 435 MHz
