ajisrawi/sentinel-uhf-radar/hardware/feed_board/SENTINEL_FEED.kicad_pcb

## KiCad design hardware/feed_board/SENTINEL_FEED.kicad_pcb (continued)

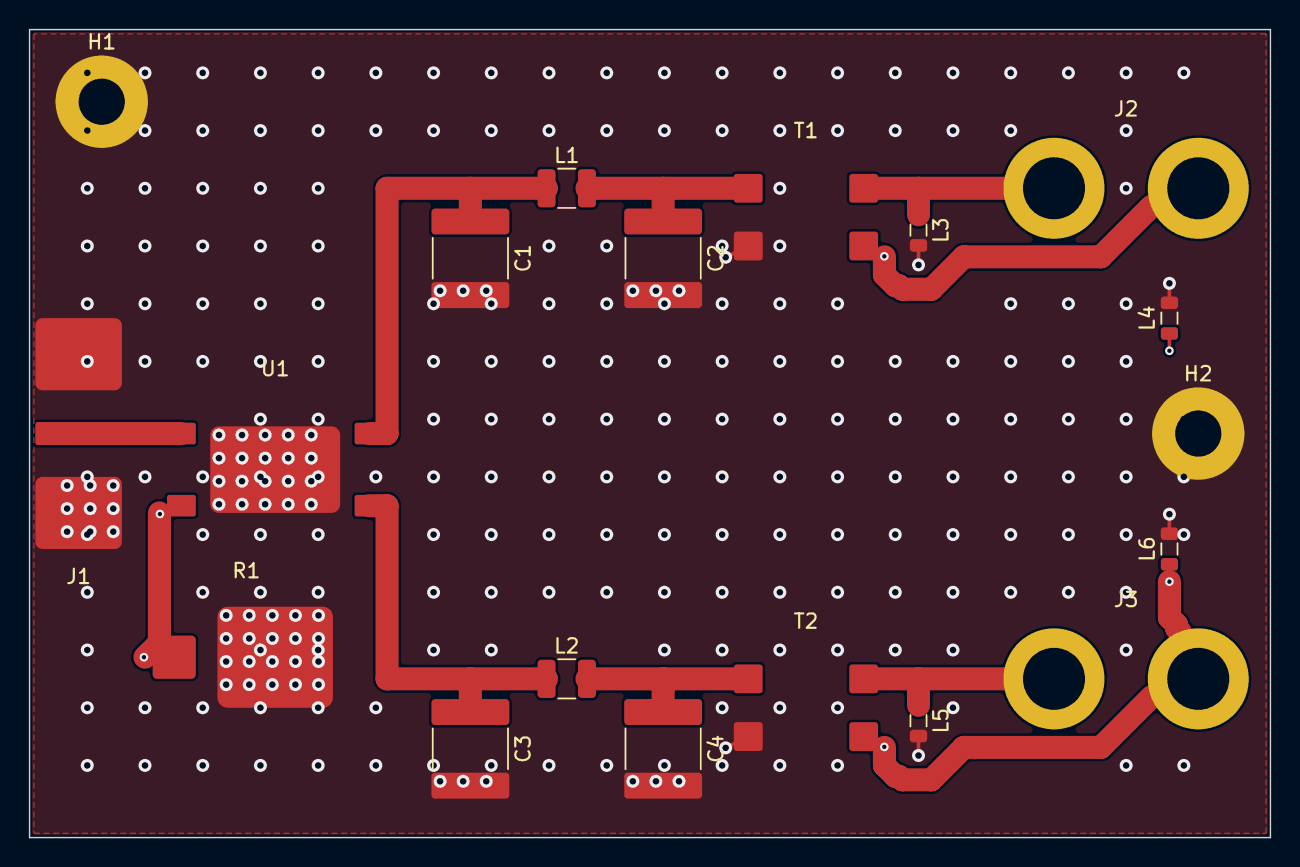
[picture p62: board SENTINEL_FEED.kicad_pcb from above]

Board: 4 copper layers, 86.0 x 56.0 mm, 19 parts (0 on the bottom side), 11 nets.
