ajisrawi/sentinel-uhf-radar/hardware/psu/SENTINEL_PSU.kicad_pcb

## KiCad design hardware/psu/SENTINEL_PSU.kicad_pcb (2026-10-18)

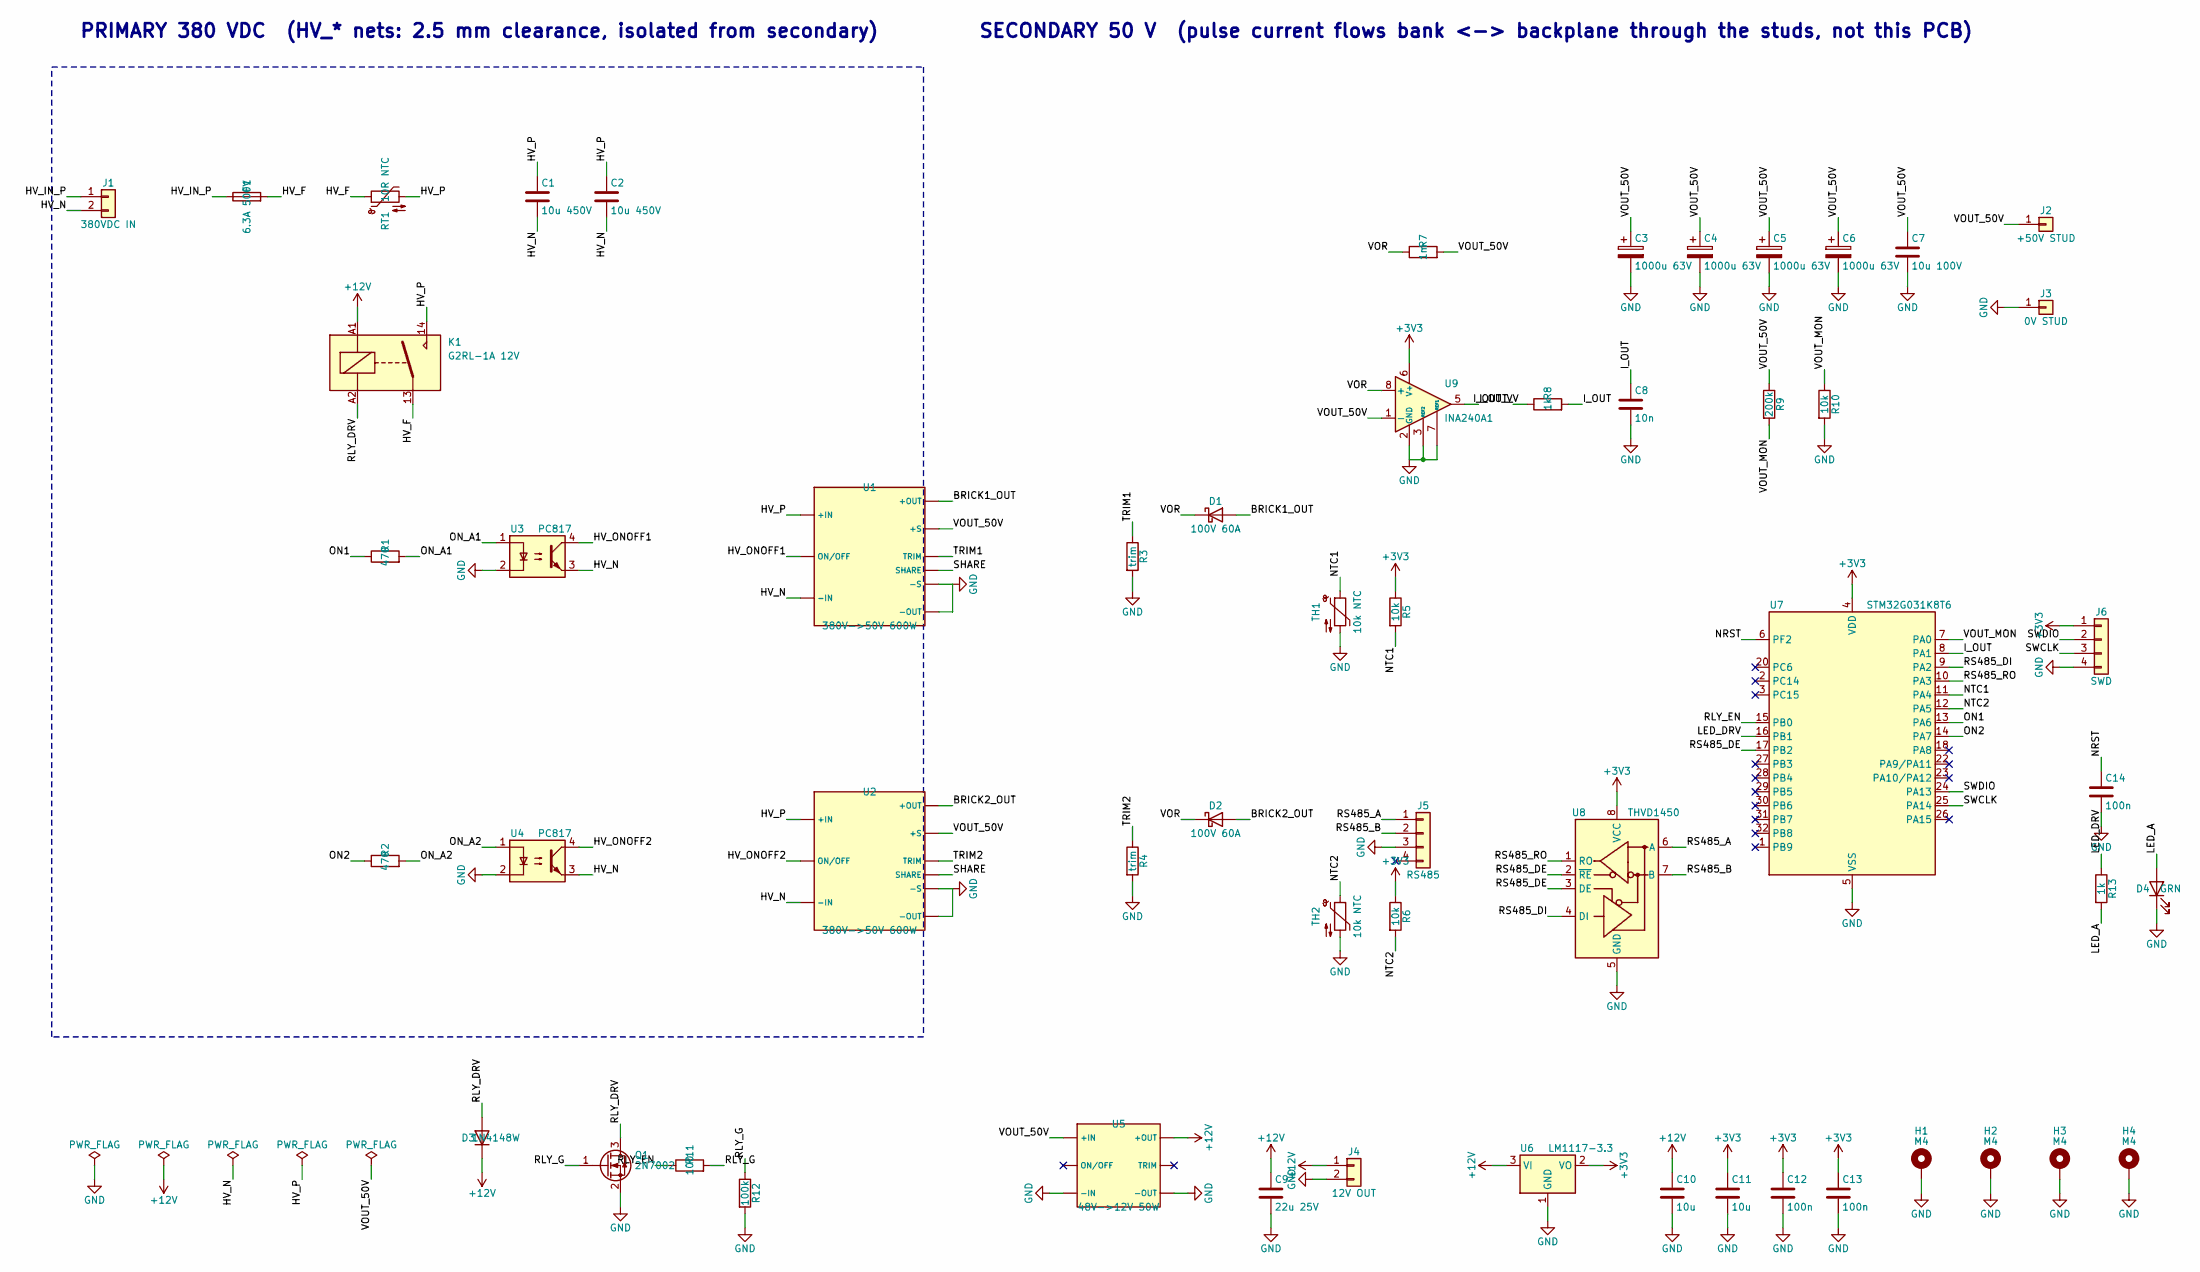
[picture p63: schematic SENTINEL_PSU.kicad_sch, SENTINEL-UHF Subarray Power Supply, 380 V -> 50 V]

Parts:
C1, C2: 10u 450V; C_Rect_L26.5mm_W10.5mm_P22.50mm_MKS4
C3, C4, C5, C6: 1000u 63V; CP_Radial_D18.0mm_P7.50mm
C7: 10u 100V; C_1210_3225Metric
C8: 10n; C_0603_1608Metric
C9: 22u 25V; C_1210_3225Metric
C10, C11: 10u; C_1210_3225Metric
C12, C13, C14: 100n; C_0603_1608Metric
D1, D2: 100V 60A; TO-247-2_Vertical
D3: 1N4148W; D_SOD-123
D4: GRN; LED_0603_1608Metric
F1: 6.3A 500V; Fuse_Clips_5x20
H1, H2, H3, H4: M4; MountingHole_3.2mm_M3_Pad
J1: 380VDC IN; Terminal_HV_2P_7.62
J2: +50V STUD; Stud_M6
J3: 0V STUD; Stud_M6
J4: 12V OUT; Molex_Mini-Fit_Jr_5566-02A_2x01_P4.20mm_Vertical
J5: RS485; PinHeader_1x04_P2.54mm_Vertical
J6: SWD; PinHeader_1x04_P2.54mm_Vertical
K1: G2RL-1A 12V; Relay_SPST_Omron_G2RL-1A
Q1: 2N7002; SOT-23
R1, R2: 470; R_0603_1608Metric
R3, R4: trim; R_0603_1608Metric; MPN value per brick datasheet
R5, R6, R10: 10k; R_0603_1608Metric
R7: 1m; R_2512_6332Metric
R8, R13: 1k; R_0603_1608Metric
R9: 200k; R_0603_1608Metric
R11: 100; R_0603_1608Metric
R12: 100k; R_0603_1608Metric
RT1: 10R NTC; NTC_Disc_D15_P7.5
TH1, TH2: 10k NTC; R_0603_1608Metric
U1, U2: 380V->50V 600W; Brick_Full_THT
U3, U4: PC817; SMDIP-4_W7.62mm
U5: 48V->12V 50W; Brick_16_THT
U6: LM1117-3.3; TO-252-3_TabPin2
U7: STM32G031K8T6; LQFP-32_7x7mm_P0.8mm
U8: THVD1450; SOIC-8_3.9x4.9mm_P1.27mm
U9: INA240A1; SOIC-8_3.9x4.9mm_P1.27mm

Connections:
+3V3: C11.1, C12.1, C13.1, J6.1, R5.1, R6.1, U6.2 (VO), U7.4 (VDD), U8.8 (VCC), U9.6 (V+)
+12V: C9.1, C10.1, D3.1 (K), J4.1, K1.A1, U5.6 (+OUT), U6.3 (VI)
BRICK1_OUT: D1.2 (A), U1.8 (+OUT)
BRICK2_OUT: D2.2 (A), U2.8 (+OUT)
GND: C3.2, C4.2, C5.2, C6.2, C7.2, C8.2, C9.2, C10.2, C11.2, C12.2, C13.2, C14.2, D4.1 (K), H1.1, H2.1, H3.1, H4.1, J3.1, J4.2, J5.3, J6.4, Q1.2 (S), R3.2, R4.2, R10.2, R12.2, TH1.2, TH2.2, U1.4 (-OUT), U1.5 (-S), U2.4 (-OUT), U2.5 (-S), U3.2, U4.2, U5.3 (-IN), U5.4 (-OUT), U6.1 (GND), U7.5 (VSS), U8.5 (GND), U9.2 (GND), U9.3 (REF2), U9.4 (GND), U9.7 (REF1)
HV_F: F1.2, K1.13, RT1.1
HV_IN_P: F1.1, J1.1
HV_N: C1.2, C2.2, J1.2, U1.3 (-IN), U2.3 (-IN), U3.3, U4.3
HV_ONOFF1: U1.2 (ON/OFF), U3.4
HV_ONOFF2: U2.2 (ON/OFF), U4.4
HV_P: C1.1, C2.1, K1.14, RT1.2, U1.1 (+IN), U2.1 (+IN)
I_OUT: C8.1, R8.2, U7.8 (PA1)
I_OUT_V: R8.1, U9.5
LED_A: D4.2 (A), R13.2
LED_DRV: R13.1, U7.16 (PB1)
NRST: C14.1, U7.6 (PF2)
NTC1: R5.2, TH1.1, U7.11 (PA4)
NTC2: R6.2, TH2.1, U7.12 (PA5)
ON1: R1.1, U7.13 (PA6)
ON2: R2.1, U7.14 (PA7)
ON_A1: R1.2, U3.1
ON_A2: R2.2, U4.1
RLY_DRV: D3.2 (A), K1.A2, Q1.3 (D)
RLY_EN: R11.1, U7.15 (PB0)
RLY_G: Q1.1 (G), R11.2, R12.1
RS485_A: J5.1, U8.6 (A)
RS485_B: J5.2, U8.7 (B)
RS485_DE: U7.17 (PB2), U8.2 (~RE), U8.3 (DE)
RS485_DI: U7.9 (PA2), U8.4 (DI)
RS485_RO: U7.10 (PA3), U8.1 (RO)
SHARE: U1.9 (SHARE), U2.9 (SHARE)
SWCLK: J6.3, U7.25 (PA14)
SWDIO: J6.2, U7.24 (PA13)
TRIM1: R3.1, U1.6 (TRIM)
TRIM2: R4.1, U2.6 (TRIM)
VOR: D1.1 (K), D2.1 (K), R7.1, U9.8 (+)
VOUT_50V: C3.1, C4.1, C5.1, C6.1, C7.1, J2.1, R7.2, R9.1, U1.7 (+S), U2.7 (+S), U5.1 (+IN), U9.1 (-)
VOUT_MON: R9.2, R10.1, U7.7 (PA0)

Notes on the sheet:
PRIMARY 380 VDC (HV_* nets: 2.5 mm clearance, isolated from secondary)
SECONDARY 50 V (pulse current flows bank <-> backplane through the studs, not this PCB)

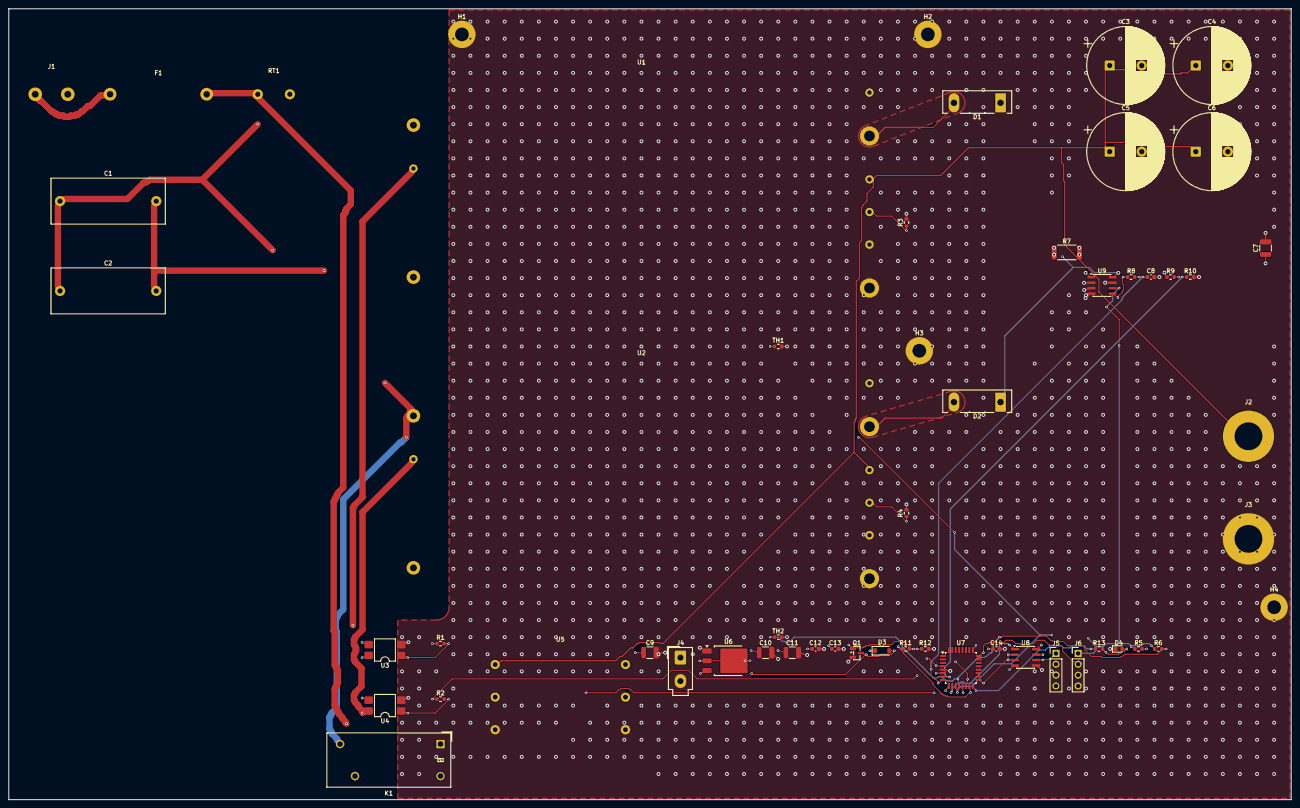
[picture p64: board SENTINEL_PSU.kicad_pcb from above]

Board: 4 copper layers, 300.0 x 185.0 mm, 56 parts (0 on the bottom side), 38 nets.
