ajisrawi/sentinel-uhf-radar/(commit log)

2026-10-18 SENTINEL-UHF: UHF early-warning phased-array radar reference design
    System sizing, thin-wire MoM antenna solver with a 61-element array study,
    seven KiCad 10 board projects (T/R module, feed board, RFSoC tile carrier,
    tile backplane, 380 V -> 50 V subarray PSU, calibration network, clock and
    timing distribution), a Blender site model, renders and the design report.
    All schematics pass KiCad ERC and match their intended netlists pin for pin.
    Feed board, PSU and calibration network layouts are DRC-clean; the remaining
    four layouts are first-pass and still being routed.
    [SENTINEL_BACKPLANE-B_Courtyard.gbr, SENTINEL_BACKPLANE-B_Cu.gbl, SENTINEL_BACKPLANE-B_Fab.gbr, SENTINEL_BACKPLANE-B_Mask.gbs, SENTINEL_BACKPLANE-B_Paste.gbp, SENTINEL_BACKPLANE-B_Silkscreen.gbo, SENTINEL_BACKPLANE-Edge_Cuts.gm1, SENTINEL_BACKPLANE-F_Courtyard.gbr]
2026-10-19 Five boards DRC-clean, BOMs, layout engine improvements
    - Backplane, clock & timing, calibration network, PSU and feed board layouts now pass
    KiCad DRC with zero errors and zero unconnected items
    - T/R module: 0 DRC errors, 6 connections left to route by hand
    - Calibration selector redesigned as an SPDT tree (replaces the fine-pitch SP8T)
    - PSU: IPC-2221 2.5 mm high-voltage clearance via KiCad custom rules
    - Backplane/tile cable re-pinned (slots 1-4 left column, 5-8 right) for routability
    - Grouped BOM CSV for every board (hardware/tools/export_bom.sh)
    - Router: partial routing, neck-downs at fine-pitch pins, long-axis fan-out,
    NPTH obstacles, pour-net connectivity, domain-aware clearanc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
    [SENTINEL_BACKPLANE-B_Courtyard.gbr, SENTINEL_BACKPLANE-B_Cu.gbl, SENTINEL_BACKPLANE-B_Fab.gbr, SENTINEL_BACKPLANE-B_Mask.gbs, SENTINEL_BACKPLANE-B_Paste.gbp, SENTINEL_BACKPLANE-B_Silkscreen.gbo, SENTINEL_BACKPLANE-Edge_Cuts.gm1, SENTINEL_BACKPLANE-F_Courtyard.gbr]
2026-10-20 RFSoC tile: 320 x 260 mm, routed with EasyEDA Pro, DRC clean
    - Board enlarged from 240 x 190 to 320 x 260 mm; SOM connector B pins
    grouped by row toward their destinations (RS-485 / control side).
    - Routing done by the EasyEDA Pro autorouter (Top / In2 / Bottom, In1 kept
    as solid GND) and imported back into KiCad: 0 DRC errors, 0 unrouted.
    - tools/import_easyeda.py replays easyeda_routes.json onto the KiCad board;
    tools/layer_preview.py draws copper previews from any finished board.
    - Regenerated gerbers, 3D view, BOM, figures, report and README (6 of 7
    layouts now DRC clean).
    [SENTINEL_TILE-B_Courtyard.gbr, SENTINEL_TILE-B_Cu.gbl, SENTINEL_TILE-B_Fab.gbr, SENTINEL_TILE-B_Mask.gbs, SENTINEL_TILE-B_Paste.gbp, SENTINEL_TILE-B_Silkscreen.gbo, SENTINEL_TILE-Edge_Cuts.gm1, SENTINEL_TILE-F_Courtyard.gbr]
2026-10-20 T/R module: last five nets finished with EasyEDA Pro, all 7 boards DRC clean
    - +5V, DRAIN_ON, NTC_V, FAULT_N and V_REFL routed by the EasyEDA Pro
    autorouter with every existing track locked (DRAIN_ON uses one short
    In1 run); stored in tr_module/easyeda_routes.json.
    - import_easyeda.py can now replace only the nets listed in the JSON.
    - T/R module: 0 DRC errors, 0 unconnected; gerbers, 3D view and copper
    preview regenerated.
    - Report counts tracks/vias from the board file; README now reports
    7 of 7 layouts DRC clean.
    [SENTINEL_TRM-B_Courtyard.gbr, SENTINEL_TRM-B_Cu.gbl, SENTINEL_TRM-B_Fab.gbr, SENTINEL_TRM-B_Mask.gbs, SENTINEL_TRM-B_Paste.gbp, SENTINEL_TRM-B_Silkscreen.gbo, SENTINEL_TRM-Edge_Cuts.gm1, SENTINEL_TRM-F_Courtyard.gbr]
